nenecchiCV/ball-balancing-omni-rover/README.md

# ball-balancing-omni-rover
玉乗りオムニローバー開発用
