nenecchiCV/ball-balancing-omni-rover/specs/hardware_design/electronics/nucleo_shield_imu_hole_alignment.md

# Nucleoボード・シールド・IMUの穴位置合わせ設計

作成日: 2026-10-27

Fusion 360のCADモデル（`ball_balancing_omnirover3wd_assembly`）に対応する、制御ボード・ユニバーサルシールド・IMUの取付穴位置情報をまとめる。CADには簡略化した代表形状のみを持ち、はんだ付け・ドリル位置の決定には本書の座標を正として使う。

## 座標系の定義

- **機体座標系**: 原点は機体中心（ボール直上・車体中央）、+XはP0モータ方向、+Zは上向き。単位はmm。
- **Nucleo基板座標系**: ST公式機械図面（UM2505 Fig.6）の基板左上隅を原点（0, 0）、+Xは基板右方向、+Yは基板下方向（ST-LINK側がy=0、ターゲット端がy=82.5）。
- **IMU基板座標系**: Adafruit Eagleデータの基板左下隅を原点。センサー（LSM6DSOXチップ）は基板中心(12.7, 8.89)に一致する。

## Nucleoボードの機体への配置

採用ボードはNUCLEO-G474RE（Nucleo-64, MB1367系、基板外形70 × 82.5 mm）。機体座標への変換は次の通り。

- 基板原点(0,0) → 機体座標 **(-34.27, -41.53)**
- 基板+X方向は機体+Xに対し **約+1.49°** の回転
- 基板のジャンクション（ST-LINK切り離しライン、基板y=27.93）は機体y ≈ -13.6の帯に位置する

### 基板取付穴（Ø3.2 mm、M3スペーサ対応）

| 穴 | 基板座標 (x, y) | 機体座標 (x, y) | 実装 |
|---|---|---|---|
| M1 | (10.97, 28.06) | (-24.03, -13.19) | M3×25mmスペーサ実装 |
| M2 | (59.17, 29.31) | (24.17, -11.94) | M3×25mmスペーサ実装 |
| M3 | (43.89, 80.14) | (8.89, 38.89) | L2に穴のみ（スペーサなし、下記参照） |

M3位置はバッテリー包絡（後述）と干渉するため、第3スペーサは省略としL2の貫通穴のみ残す。基板はジャンクション側2点で支持する。3点支持が必要になった場合はバッテリーを取り外した状態で第3スペーサを追加できる。

## IMU（Adafruit LSM6DSOXブレイクアウト）の配置

センサー中心を機体座標 **(0, 0)** に合わせる。基板の9ピン列は-Y側（ST-LINK／ジャンクション方向）、5ピン列は+Y側に向ける向きを標準とする。

- IMU基板外形: 25.4 × 17.78 × 1.6 mm、中央が(0,0)
- ヘッダピン列は機体Y = **±6.35 mm** の2列に並ぶ（センサー中心から±6.35）

### 一致させるべき穴位置（機体座標）

ユニバーサルシールド上で、Adafruitのヘッダピンが通るべきグリッド穴の位置は次の通り（全て2.54 mmグリッド上）。

| 用途 | 穴位置（機体座標, mm） |
|---|---|
| 9ピン列（JP1、9穴） | y = -6.35、x = {-10.16, -7.62, -5.08, -2.54, 0, +2.54, +5.08, +7.62, +10.16} |
| 5ピン列（JP2、5穴） | y = +6.35、x = {-5.08, -2.54, 0, +2.54, +5.08} |
| IMU基板固定穴（任意、2穴） | (-10.16, +6.35)、(+10.16, +6.35) |

両ピン列とも基板中心（x=0）に対し対称であり、14ピン全てが y = ±6.35 の2列の直線上に収まる。2列間隔は12.70 mm = 2.54 mmグリッド5ピッチで、連続グリッドに整合する。

### 一致させるべき穴位置（基板座標）

はんだ付け・グリッド確認を基板上で直接行えるよう、同じ14穴＋固定穴を各基板の座標系でも示す。機体座標との関係は次の通り。

- IMU基板座標: 原点 = 基板左下隅（機体座標(-12.7, -8.89)）、軸は機体と平行
- シールド基板座標: 原点 = 代表外形の左下隅（機体座標(-34.5, -24.5)）、軸は機体と平行

#### IMU基板座標（Adafruit Eagleデータの正規値）

| 用途 | 穴位置（IMU基板座標, mm） |
|---|---|
| 9ピン列（JP1、9穴） | y = 2.54、x = {2.54, 5.08, 7.62, 10.16, 12.70, 15.24, 17.78, 20.32, 22.86} |
| 5ピン列（JP2、5穴） | y = 15.24、x = {7.62, 10.16, 12.70, 15.24, 17.78} |
| 基板固定穴（任意、2穴） | (2.54, 15.24)、(22.86, 15.24) |

センサー中心 = 基板中心 (12.70, 8.89)。両ピン列は基板中心からy方向 ±6.35 の位置にある。

#### シールド基板座標（CADの代表外形 69 × 53 mm 基準）

| 用途 | 穴位置（シールド基板座標, mm） |
|---|---|
| 9ピン列と一致させる列 | y = 18.15、x = {24.34, 26.88, 29.42, 31.96, 34.50, 37.04, 39.58, 42.12, 44.66} |
| 5ピン列と一致させる列 | y = 30.85、x = {29.42, 31.96, 34.50, 37.04, 39.58} |
| IMU固定穴と一致させる穴 | (24.34, 30.85)、(44.66, 30.85) |

シールド基板座標でのIMUセンサー中心位置は (34.50, 24.50)。2列間隔は12.70 mm（2.54 mmグリッド5ピッチ）で、シールドのユニバーサルグリッドがこれらの座標を含む位相にあればよい。

- 代表外形は実シールドと異なる可能性があるため、実シールド上では「外形隅からの絶対座標」ではなく「ユニバーサルグリッドに対する位相」で判断する。上表の座標を2.54で割った剰余（x: 約1.48、y: 約0.37）が、代表外形左下を原点とした場合のグリッド位相条件となる。
- 参考: Nucleo基板座標では、IMUセンサー中心は約 (35.34, 40.63)（基板のほぼ中央）に投影され、両ピン列は基板X軸に対し約 -1.5° 傾いた直線になる。

### スペーサ穴を基準としたIMU中心位置

実機ではんだ付け位置を決める際、Nucleoの取付（スペーサ）穴を基準に測るのが最も確実。IMUセンサー中心の目標位置と各取付穴からのオフセットは次の通り。

| 基準 | 座標系 | IMU中心位置 |
|---|---|---|
| Nucleo基板座標（左上隅原点） | 基板座標 | **(35.34, 40.63)** — 基板のほぼ中央 |
| 取付穴M1 (10.97, 28.06) から | 基板座標オフセット | **(+24.37, +12.57)** |
| 取付穴M2 (59.17, 29.31) から | 基板座標オフセット | **(-23.83, +11.32)** |
| 取付穴M3 (43.89, 80.14) から | 基板座標オフセット | **(-8.55, -39.51)** |

実装上の2スペーサ（M1, M2）を基準にすると:

- **M1–M2を結ぶ線のほぼ垂直二等分線上**にあり、その線から**約11.9 mm**だけM3側（基板奥側）へ離れた位置
- 穴中心からの直線距離（ノギス確認用）: M1から **27.4 mm**、M2から **26.4 mm**、M3から **40.4 mm**
- 機体座標ではM1(−24.03,−13.19)、M2(24.17,−11.94)から見てIMU中心(0,0)は中点の真上付近（中点(0.07,−12.57)から+y方向へ12.6 mm）

採用するUNO互換ユニバーサルシールドのプロト穴グリッド（2.54 mmピッチ）が、機体座標で **y = ±6.35** の2列および上表のx位置に穴を持つ必要がある。言い換えると、機体中心を通る仮想のy=0線から測って **グリッドが半ピッチ（1.27 mm）ずれた位相** にあれば全穴が一致する。

- シールドの機体への位置は、NucleoのArduinoコネクタ（CN5, CN6, CN8, CN9）への挿入で機械的に確定する。グリッド位相はシールド個別の設計に依存するため、採用シールド上で上表の14座標に実穴があることを確認してからはんだ付けする。
- グリッド位相が半ピッチずれないシールドでは、IMUのヘッダピンをグリッドに合わせるとセンサー中心が±1.27 mmずれる。厳密な中央一致を優先する場合は、2.54 mmピッチの小型変換基板（グリッドを1.27 mmオフセットする中継板）をシールドとIMUの間に挟む。

## 高さ方向の積層（機体座標 z, mm）

| 要素 | z範囲 | 備考 |
|---|---|---|
| フレームL2上面 | 178.0 | 電子機器の載置面 |
| 基板固定スペーサ M3×25 | 178.0–203.0 | M1, M2位置に2本（Nucleo用） |
| MDD3A用 M3×10 スペーサ | 178.0–188.0 / 199.0–209.0 | 右側ストリップに4本×2段（MDD3A 2層積み） |
| MDD3A-A基板（実寸代表 48.26×41.66×11） | 188.0–199.0 | 下層、中心(56,0)、取付穴はL2穴表 |
| MDD3A-B基板（実寸代表 48.26×41.66×11） | 209.0–220.0 | 上層、中心(56,0)、L3下面まで8 mm |
| Nucleo基板（1.6 mm厚） | 203.0–204.6 | |
| シールド基板 | 215.0–216.6 | スタックヘッダ高さ10.4 mm想定（実物のヘッダ高で調整） |
| IMU基板 | 219.1–220.7 | シールド上面から2.5 mmのスタンドオフ想定 |
| フレームL3下面 | 228.0 | IMU上面との隙間約7.3 mm |

IMUとL3の間隔は約7 mm確保される。スタックヘッダを実装する際は、シールド下の高さを合わせてIMUがL3下面に接触しないことを確認する。

## バッテリー配置

- バッテリー: Zeee 7.2 V 5000 mAh NiMH（TAMIYAプラグ付）、包絡 **135.5 × 45.5 × 22.5 mm**
- 配置: 機体座標で x = ±22.75、y = ±67.75、z = 178.0–200.5（L2上・Nucleo基板下、ほぼ機体中央）
- 上部クリアランス: バッテリー上面200.5 → 基板下面203.0で2.5 mm

### 既知の干渉と対処

- 中央配置のバッテリー（幅45.5 mm）と2本の基板スペーサ（M1, M2、中心間隔48.2 mm）の間に、**約1.8 mm深さの隅部干渉** が残る（実測: 157 / 145 mm³）。スペーサ間隔よりバッテリー幅が2.7 mmだけ狭いため、中央近傍では両スペーサを同時に回避する位置が幾何学的に存在しない。
- 実機では、NiMHスティックパックの角部シュリンク・丸み（実効幅は公称より小さい）とスペーサのわずかな面取りで吸収できる見込み。完全非接触が必要なら、バッテリーを1–2 mm片側へ寄せるか、スペーサに小さな面取りを入れる。
- 配線スロット（L2、幅10 mm、r=26–56、0°/120°/240°方向）はバッテリー縁より外側まで開放しており、モーターコネクタからの配線はスロット外側部を通る。

## フレームL2の穴（実装済み）

| 穴 | 位置（機体座標, mm） | 寸法 |
|---|---|---|
| 基板取付穴 ×3 | M1(-24.03,-13.19)、M2(24.17,-11.94)、M3(8.89,38.89) | Ø3.5 |
| MDD3A取付穴 ×4 | (37.71,±21.59)、(74.29,±21.59)（2層共用） | Ø4.0（挿入固定） |
| 層間スペーサ穴 ×6 | r=65、0°/60°/120°/180°/240°/300° | Ø3.5 |
| 配線スロット ×3 | r=26–56の放射状長穴、0°/120°/240°方向 | 幅10 |
| 中央部 | — | 充填済み（旧Ø20穴は廃止） |

## 備考・未確認事項

- CADのシールドは69 × 53 mmの代表形状であり、採用シールド実物とは外形が異なる。確定したシールドのユニバーサル領域が上表14座標を含むことを発注前に確認する。
- Nucleo基板CADの外形は機械図面寸法を反映しているが、USBコネクタ・部品高さは未モデル。基板上の実部品高は別途確認する。
- IMUの向き（±90°回転）は自由に選べる。向きを変える場合は上表の座標を同じ回転で変換し直す。
