nenecchiCV/ball-balancing-omni-rover/specs/hardware_design/controll/ball_balancing_omnirover3wd/ball_balancing_omnirover3wd-implementation-plan.md

# 玉乗り3WDオムニローバー実装計画

## 状態

| 項目 | 値 |
|---|---|
| ステータス | 正本モデルのモジュール化完了・階層制御へ移行済み |
| 最終更新日 | 2026-09-09 |
| アーキテクチャ | [アーキテクチャ仕様](ball_balancing_omnirover3wd-architecture.md) |
| 検証 | [検証計画](ball_balancing_omnirover3wd-test-plan.md) |

## 1. 進捗

| フェーズ | 状態 | 成果物 |
|---|---|---|
| 0. インターフェース固定 | 完了 | 座標系、信号、単位、符号、パラメーター |
| 1. MATLAB関数 | 実装・単体試験完了 | 幾何、摩擦、IMU、推定、制御、配分、単体試験 |
| 2. Multibodyプラント | 完了 | 球、床、3輪機構、4接触、異方性摩擦 |
| 3. 制御器統合 | バイアス診断・起動ガード統合完了 | 状態推定・モード制御、5 ms制御遅延、サーボ包絡線 |
| 4. 閉ループ検証 | 短時間公称完了 | 静止、複合速度・ヨー指令 |
| 5. ロバストネス | 未完了 | 摩擦、球質量、ソルバー感度 |
| 6. 実機向けヨーバイアス補正 | 基本実装・構造検証完了 | 14状態推定器、低運動認定、診断、起動ガード、単体試験、短時間MIL |

## 2. 依存製品

| 製品 | 用途 | 必須 |
|---|---|---|
| MATLAB | パラメーター、MATLAB関数、解析 | Yes |
| Simulink | 制御器・ログ | Yes |
| Simscape | 物理信号 | Yes |
| Simscape Multibody | 剛体・ジョイント・接触 | Yes |
| Simulink Test | Gherkin/MIL自動化 | No。利用可能時に使用 |

## 3. フェーズ依存

```mermaid
flowchart TD
  P0[Phase 0<br/>Interface freeze]
  P1A[Geometry and parameters]
  P1B[Estimator functions]
  P1C[Controller functions]
  P2A[Ball and ground]
  P2B[Rover and wheel modules]
  P2C[Wheel-ball contacts]
  P3[Closed-loop integration]
  P4[Nominal MIL]
  P5[Robustness MIL]
  P0 --> P1A
  P0 --> P1B
  P0 --> P1C
  P1A --> P2A
  P1A --> P2B
  P1A --> P2C
  P1B --> P3
  P1C --> P3
  P2A --> P3
  P2B --> P3
  P2C --> P3
  P3 --> P4 --> P5
```

## 4. ビルド手順

### Phase 0: インターフェース固定

| ID | 操作 | 完了条件 | 状態 |
|---|---|---|---|
| 0.1 | $W,B,K,F_i$座標系を固定 | 機構・制御文書で一致 | 完了 |
| 0.2 | 3輪番号と正方向を固定 | $\beta=[0,120,240]$ deg | 完了 |
| 0.3 | 13要素推定出力を固定（バスは14幅・末尾未使用） | システム仕様§5と一致 | 完了 |
| 0.4 | 5 ms離散インターフェースを固定 | 推定器・制御器で一致 | 完了 |

### Phase 1: MATLAB関数

| ID | 関数 | 確認 | 状態 |
|---|---|---|---|
| 1.1 | `ballbotParameters` | 全パラメーター有限、質量整合 | 完了 |
| 1.2 | `ballbotWheelGeometry` | 直交性、$\operatorname{rank}(A_\tau)=3$ | 完了 |
| 1.3 | `ballbotTorqueAllocator` | 往復誤差、飽和 | 完了・現行構成では輪速変換$W_\omega$（`p.controller.lqi.wheelSpeedFromPlanarVelocity`）へ移行 |
| 1.4 | `ballbotCustomFriction` | 摩擦がすべりと逆向き | 完了・3接触へ統合済み |
| 1.5 | `ballbotWheelRateFromDisplacement` | 車輪回転変位の後退差分 | 完了 |
| 1.6 | `ballbotEstimatorStep` | 14状態、補正角速度、静止不変、有限出力 | 完了・実行確認済み |
| 1.7 | `ballbotControlStep` | モード・符号・飽和 | 完了・現行構成では`ballbotLqiControllerUpdate`→`ballbotFullPlantHierarchyUpdate`へ移行 |
| 1.8 | `ballbotServoTorqueEnvelope` | 最高輪速で加速トルク0 | 完了・現行構成では`ballbotSpeedPiMotorStep`→`ballbotMdd3aVoltageController`の輪速PI＋DCモータへ移行 |
| 1.9 | `ballbotEstimatorStepTest` | バイアス収束、学習抑止、上限、再開、回帰 | 16件合格（現行制御器向けに更新済み） |
| 1.10 | `ballbotYawBiasStartupGuard` | ヨー抑止、解除、運動中ラッチ保持 | 完了・実行確認済み |
| 1.11 | `ballbotFullPlantHierarchyUpdate` | 速度外側ループ＋傾斜安定化＋輪速変換 | 完了・正本モデルで使用中 |
| 1.12 | `ballbotSpeedPiMotorStep` | 輪速PI、MDD3A電圧制限、DCモータトルク | 完了・正本モデルで使用中 |
| 1.13 | `ballbotDesignLqi` | 10状態縮約プラントのLQIゲイン設計 | 完了・パラメーター初期化で再計算 |

### Phase 2: Multibodyプラント

| ID | 操作 | 検証ツール |
|---|---|---|
| 2.1 | 既存`omnirover3wd_multibody.slx`を新規フォルダーへ複製 | ファイル存在 |
| 2.2 | ルートをCommandSource/Controller/MultibodyPlant/Loggingへ分割 | `model_overview` |
| 2.3 | Infinite Planeと直径100 mm Spherical Solidを配置 | `model_read` |
| 2.4 | 球–床Spatial Contact Forceを接続 | `model_read`, `model_check` |
| 2.5 | 3輪中心を球面$\lambda=33$ degへ再配置 | Transform確認 |
| 2.6 | 3組のRevolute Jointを$+a_i$へ整列 | Joint軸確認 |
| 2.7 | 3組の輪–球Spatial Contact Forceを接続 | 物理ポート確認 |
| 2.8 | Provided by Input摩擦と`ballbotCustomFriction`を接続 | すべり/力ログ |
| 2.9 | IMU、車輪回転変位、truthセンサーを接続 | 信号次元確認 |

### Phase 3: 制御器統合

| ID | 操作 | 完了条件 |
|---|---|---|
| 3.1 | StateEstimatorをMATLAB Function+Unit Delayで構成 | 14状態、13要素`estimate` |
| 3.2 | ModeAndControlをMATLAB Function+Unit Delayで構成 | 2積分状態、3輪出力 |
| 3.3 | 輪トルクをRevolute Jointへ接続 | 正方向一致 |
| 3.4 | 速度・ヨー指令をCommandSourceへ接続 | 範囲制限一致 |
| 3.5 | truth信号を制御器から隔離 | 制御入力線なし |
| 3.6 | ヨーバイアス診断をLoggingへ接続 | $\hat b_{g,z}$、$\gamma$、$t_{qual}$を個別ログ |
| 3.7 | 起動時ヨー制御ガードを追加 | 準備完了までヨートルクだけを抑止し、状態をUnit Delayで保持 |

Phase 3.1、3.6、3.7はSimulink Agentic Toolkitの`model_read`、`model_edit`、`model_check`を使用して実施し、`Controller`と`Logging`の構造チェックが正常であることを確認した。

### Phase 4: 閉ループ検証

| ID | シナリオ | ゲート |
|---|---|---|
| 4.1 | 静止直立 | 4接触維持、姿勢±1 deg |
| 4.2 | $v_x=0.10$ m/s | 速度誤差±0.01 m/s |
| 4.3 | $v_y=0.08$ m/s | 速度誤差±0.01 m/s |
| 4.4 | $r=0.5$ rad/s | ヨー速度誤差±0.05 rad/s |
| 4.5 | 初期傾斜10 deg | 2 s以内に±2 deg |
| 4.6 | 静止、ヨーバイアス0.02 rad/s | 15 s以内に推定誤差0.002 rad/s未満 |
| 4.7 | 学習後の静止10 s | ヨードリフト0.5 deg未満 |
| 4.8 | 走行・振動・すべり・接触低下 | バイアス変化0.002 rad/s未満 |

## 5. パラメーター表

| パラメーター | 値 | 単位 | 出典 | 実装 |
|---|---:|---:|---|---|
| $R_b$ | 0.050 | m | 要求 | `p.ball.radius` |
| $m_b$ | 0.285 | kg | 基準質量・実測更新 | `p.ball.mass` |
| $R_w$ | 0.024 | m | 14108仕様書 | `p.wheel.radius` |
| $m_w$ | 0.039 | kg | 14108仕様書/既存モデル | `p.wheel.mass` |
| $m_R$ | 1.179 | kg | Fusion実測反映後（MotorMount_v12等） | `p.rover.mass` |
| $m_p$ | 0.500 | kg | 正式上部ロッド仕様 | `p.fullplant.payload.mass` |
| $L_p$ | 0.300 | m | 正式上部ロッド仕様 | `p.fullplant.payload.length` |
| $h_{COM}$ | 0.1074 | m | ローバー合成重心（Fusion実測反映後） | `p.rover.centerAboveBall` |
| $\lambda$ | 33 | deg | 機構設計（案B内向き格納の成立限界） | `p.wheel.contactLatitude` |
| $\tau_{motor,stall}$ | 0.981 | N·m | FIT0521公式仕様 | `p.motor.stallTorque` |
| $\tau_{driver,continuous}$ | 0.919 | N·m | MDD3A 3 A連続定格とFIT0521トルク定数 | `p.driver.continuousTorqueLimit` |
| $\tau_{contact,max}$ | 0.1262 | N·m | ローバー質量・λ33の公称法線荷重・摩擦 | `p.wheel.contactTorqueLimit` |
| $T_s$ | 0.005 | s | 制御設計 | estimator/controller |
| $K_{pv}$ | [2.3,2.3] | s$^{-1}$ | 正本構成の速度外側ループ | `p.controller.fullplant.velocityKp` |
| $K_{iv}$ | [0,0] | s$^{-2}$ | 正本構成の速度外側ループ | `p.controller.fullplant.velocityKi` |
| $K_{p,\alpha}$ | [16,16] | - | 傾斜安定化比例 | `p.controller.fullplant.tiltKp` |
| $K_{d,\alpha}$ | [1.6,1.6] | - | 傾斜安定化微分 | `p.controller.fullplant.tiltKd` |
| $\tau_{motor,lim}$ | 0.010 | N·m | 正本構成の輪トルク上限 | `p.controller.fullplant.motorTorqueLimit` |
| $c_{scale}$ | 0.60 | - | 指令スケール | `p.controller.fullplant.commandScale` |
| $\omega_{w,th}$ | 0.10 | rad/s | 低運動の暫定輪周速度ゲート | `p.estimator.biasWheelRateThreshold` |
| $a_{th}$ | $0.03g$ | m/s² | 静止振動の暫定許容値 | `p.estimator.biasAccelNormThreshold` |
| $\omega_{rp,th}$ | 0.02 | rad/s | ロール・ピッチ低運動の暫定値 | `p.estimator.biasRollPitchRateThreshold` |
| $\omega_{z,th}$ | 0.05 | rad/s | 0.02 rad/sバイアスを含む暫定値 | `p.estimator.biasYawRateThreshold` |
| $t_{min}$ | 0.50 | s | 一時停止を除外する滞留時間 | `p.estimator.biasQualificationTime` |
| $\tau_b$ | 1.0 | s | 低運動維持時間内の収束と15 s基準を両立する暫定値 | `p.estimator.biasTimeConstant` |
| $b_{max}$ | 0.10 | rad/s | 未確定IMU向け保守上限 | `p.estimator.biasMaximum` |
| $\Delta b_{max}$ | $1.0\times10^{-4}$ | rad/s/sample | 外れ値急変防止 | `p.estimator.biasMaximumUpdatePerSample` |
| $\omega_{ready}$ | 0.002 | rad/s | 収束合格誤差と一致する起動ガード解除値 | `p.controller.yawBiasReadyRateThreshold` |

## 6. 完了定義

- [x] 座標系・符号・単位を文書化
- [x] MATLAB関数をモデル外で静止入力確認
- [x] ルート階層がアーキテクチャと一致
- [x] `model_check`にerrorなし
- [x] 全モデルが更新・コンパイル可能
- [x] 静止シミュレーション完走
- [x] 短時間の複合速度・ヨー指令シナリオ完走
- [x] 4接触truthログを保存
- [ ] 規定速度での定常追従ゲート合格
- [ ] 接触分離シナリオと法線力・すべりログを保存
- [ ] ソルバー・摩擦・球質量の感度試験完了
- [x] 14状態推定器とヨー軸バイアス更新則をMATLAB関数へ実装
- [x] 9項目以上のクラスベース単体試験を作成
- [x] MATLAB接続下でヨーバイアス単体試験を実行
- [x] StateEstimatorの状態幅と診断ログをSimulinkモデルへ統合
- [ ] バイアス・ノイズ・振動・すべり・接触低下MILを実行

### 6.1 実行済みMIL

| シナリオ | 主結果 | 判定 |
|---|---|---|
| 静止、0.1 s | 4接触、最大傾斜0.00001 deg未満、有限値 | 合格 |
| $[v_x,v_y,r]=[0.03,0.02,0.20]$、0.5 s | 4接触、最大傾斜0.787 deg、平均ヨー速度0.183 rad/s、最大輪速1.403 rad/s | 短時間ゲート合格 |
| モデル更新 | `ANISOTROPIC_COMPILE_OK` | 合格 |
| MATLAB単体試験 | 16件中16件合格 | 合格 |
| モデル構造 | `Controller`、`Logging`とも`model_check`正常、ルートにerrorなし | 合格 |
| 静止、ヨーバイアス0.02 rad/s、4 s | 4 s時点誤差0.001916 rad/s、3～4 sヨードリフト0.005293 deg | 短時間ゲート合格 |
| $[v_x,v_y,r]=[0.03,0.02,0.20]$、0.5 s再試験 | 平均ヨー速度0.197879 rad/s、最大傾斜0.005681 deg、最終mode=1 | 合格 |
| モジュール化回帰 | サブシステム化後モデルと再構成前ベースラインで全ログ信号が一致（最大相対差は摩擦力で約$4\times10^{-3}$） | 合格 |
| モデル更新 | モジュール化後モデルで`update`成功 | 合格 |

25 sの全機体バイアスMILでは15 s時点の推定誤差0.001916 rad/sを確認したが、モデルは4.760 sでFALLENへ遷移したため、その後の10 sヨードリフトは判定対象外とした。バイアスなし公称指令でも2.195 sでFALLENへ遷移するため、長時間姿勢・速度回帰は既存プラント／制御調整の未解決事項として分離する。ノイズ、振動、すべり、接触低下を含む長時間MILは未実施である。

## 7. リスク

| リスク | 検出 | 対策 |
|---|---|---|
| 接触モデルが硬くシミュレーション停止 | ソルバー診断 | 遷移幅、剛性、最大ステップを段階調整 |
| 車輪ローカル軸と摩擦方向が不一致 | 単輪正トルク試験 | $F_i$座標の軸を修正 |
| 反力符号が逆 | 1 deg姿勢偏差試験 | joint actuation signを1か所で反転 |
| 公称摩擦でトルク不足 | 飽和率 | 接触緯度・重心・指令範囲を再設計 |
| IMU速度積分ドリフト | truth誤差 | 実機版で外部速度補正を追加 |
| 実機IMU仕様未確定 | 静止ログ、温度試験、Allan分散 | 低運動閾値、時定数、上限を実測調整 |
| 走行中にエンコーダーからヨーを誤推定 | バイアスの運動中変化 | エンコーダーは低運動認定だけに使い、走行中は学習停止 |
