nenecchiCV/ball-balancing-omni-rover/specs/hardware_design/mechanism/ball_balancing_omnirover3wd/cad/fit0521_motor_mount_report.md

# FIT0521モーター固定パーツ設計レポート(v23 長方形プレート締結角筒式・印刷伏せ姿勢)

## 概要

DFRobot FIT0521(φ24.4 × 52 mm、4 mm Dシャフト)を Nexus Robot 14108 オムニホイール(φ48 × 25.1 mm)に同軸直結する配置と、そのモーター固定パーツを設計した。ホイール接触緯度は **λ = 33°**(車軸水平角 57°)、ユーザー指示により **案B(内向き格納)** を採用する。ホイール方位 β = {0°, 120°, 240°} は変更しない。

v9 では **実機で成立するギアボックス締結**を実現するため v12 のモーター締結部を再構成した。v8 の中央 Ø26 挿通ボアは PCD17 タップ半径(8.5 mm)がボア内側に入るためボルト座面となる材料が存在しなかった。v9 ではモーター面を板裏面(現行 s′=20.0 mm 面一)に着座させ、中央ボアを充填し、PCD17 の Ø3.5 貫通穴×4とホイール側ワッシャーポケット Ø7.2×2 mm×4を実体に切削した。

λ = 33° の選定根拠: 案B(モーターを車軸の内向き・上向きに延ばす同軸直結)は3モーター尾部が中心軸へ収束するため λ ≲ 33° でのみ幾何学的に成立する(計画書 §3 の定量化)。λ = 33° は境界値である。

v8→v9 での変更点(実締結構造の実現):

- **モーター締結部を実体ウェブ化**: 中央 Ø26 ボアを廃止し、ギアボックス前面タップ(PCD17、Ø2.5×4)に同軸の Ø3.5 貫通穴×4が板実体を通る構造へ変更
- **ワッシャーポケット**: ホイール側に Ø7.2×2 mm 窪み×4を新設(M3 ボルト頭+ワッシャーを収容、頭頂 s′≈14.5 mm)
- **ノーズ逃げ穴 Ø8**: ギアボックス前面中央の突起逃げ
- **モーター位置**: フェース s′=16.0 → 20.0 mm(板裏面に面一着座)
- **アダプタ再作成**: WheelAdapter_v4 を λ33 同軸の Ø11.9/Ø4.2 貫通チューブとして作り直し(旧姿勢の残存を解消)
- 体積 12.33 → 21.71 cm³(タブ追加・旧穴充填後)

v9→v10での変更点(フレーム締結とフィレット撤廃):

- **フレーム締結をタブ式に変更**: パッド上面を z=141–147 mm のキャップブロックで埋めて幅方向(±y)に張り出すタブとし(y = ±24 mm)、タブに Ø4.5 垂直穴×2((62,±19.5) mm)を切削。Frame_L1 側にも同一XY位置に Ø4.5 垂直穴を開け(3ステーション計6ヶ所)、フレーム板とタブをはさんで M4 ボルト+ナットで締結する方式へ変更
- **旧締結穴の撤廃**: パッド部の Ø4.6 垂直すきま穴×4は新タブ構造に置き換え(現行ボディに Ø4.6 垂直穴は存在しない)
- **フィレット撤廃・面取り化**: 凹角フィレット(R4×3・R2.5×1)を削除し、三角プリズムの結合/切削でフラットな面取り角に置き換え。プロファイルの段差ジグザグも直線化
- **モーター180°回転**: コネクタ干渉回避のため全3モーターを車軸まわりに180°回転
- 天面を z=147 mm で平坦化(Frame_L1 下面と面一密着、干渉0)

v10→v11での変更点(モーター姿勢の恒常化とシャフト係合):

- **モーターをステーション別コンポーネント化**: オカレンス変換(`transform2`)が保存時に旧姿勢へ巻き戻る問題が残存したため、最終姿勢をコンポーネント幾へ直接焼き込んだ FIT0521_P0/P1/P2(恒等変換)へ再構築。保存・再オープンで姿勢維持を検証
- **モーター面を板裏面へ面一着座**: s′=20.6(0.6 mm 浮き)→ s′=20.0 mm(タップ開口位置で実測確認)
- **アダプタ延長でシャフト係合を確保**: WheelAdapter_v4 のモーター側端を s′=+1.5 → +11.5 mm へ延長し、シャフト先端 s′=7.8 との 3.7 mm 係合を実現(ボア Ø4.2、外径 Ø11.9 は不変)
- 全ペア干渉 0 mm³、PCD17 穴整合・3ステーション対称性を再検証済み

v11→v13での変更点(スリーブ式マウントへの全面再設計、v15 で廃止):

- **モーターを筒状部に挿入**: 車軸同軸の回転体カップ(外径 Ø31・ボア Ø25.5、肉厚 2.75 mm)を生成。モーターは内側端(ギヤボックス側 s′≈50 の開口)から挿入され、ボアがギヤボックス前方 s′≈18.5–50 mm の周囲を包む。ボア内端 s′=18.3 がモーター前面(s′=18.5–18.7)の座面となる
- **モーターフェイスと筒壁のねじ止め**: カップ外端(ホイール側 s′=14 のキャップ壁 4.6 mm)に PCD17 同軸 Ø3.5 貫通穴×4 + Ø7.2×3.5 ワッシャーポケット×4 + 中央 Ø8 ノーズ逃げ穴を切削。キャップ内面にはギヤボックス前ボス(Ø17.6×s′≈18.5–21.5 突入)の逃げとして Ø18.4 カウンターボア(s′=15–18.4)を設置
- **面数削減**: キャップ+ウェブ+タブを単一ソリッドへ一体化(旧横穴はプラグ充填、不要な凹凸なし、面取りのみ)。現行ボディ 1 個・面数 39(解析面のみ)
- 体積 21.71 → **18.63 cm³**、CG z=128.1 mm(球心上 78.1 mm)・半径方向 52.7 mm、CG基準主慣性(鋼)≈0.500/0.440/0.185 kg·cm²

v13→v14での変更点(板+左右柱構造への再設計、v15 で3部品化。モーター/ホイール位置は不変):

- **ギアボックス接続板**: 車軸垂直の傾斜板(ê方向 ±17 mm × 幅方向 ±20 mm × 板厚 s′=14–18.6)。PCD17 同軸 Ø3.5 貫通穴×4 + ホイール側 Ø7.2 ワッシャーポケット×4 + 中央 Ø8 ノーズ逃げ穴 + 内面 Ø18.4 カウンターボア(モーター前ボス座面)はv13キャップと同一仕様
- **左右分割柱**: 板裏面(s′=18.6、ê≈+8 基点)から Frame_L1 下面タブへ繋ぐ柱を y=+15..24 / −24..−15 mm の左右2本に分割(モーター胴体 Ø25 が柱間 30 mm を軸方向に挿入可能)。柱断面は板→タブ方向(d̂=(0.10,0,0.99))に沿った 16 mm 幅の角柱
- **タブブロック**: 柱上端が接する L1 下面タブ(x=51–72.5・y=±24・z=141–147)を保持、Ø4.5 穴×2((62,±19.5) mm)の M4 ボルト+ナット挟み締結は不変
- 単一ソリッド **19.49 cm³**、CG z=126.0 mm(球心上 76.0 mm)・半径方向 58.9 mm、CG基準主慣性(鋼)≈0.845/0.488/0.468 kg·cm²。モーター胴体が開放されるため v13 のスリーブ保持(胴体拘束)は失われ、保持は面ボルトのみとなる

v14→v15での変更点(一体マウントを3部品へ分割、v16で一体成型へ回帰・廃止。モーター/ホイール位置は不変):

- **3部品構成**: `MountPlate_v15`(モーターフェイス締結板)+ `MountPillar_v15_R`(右柱)+ `MountPillar_v15_L`(左柱)。Fusion アセンブリでは3コンポーネント×3ステーションの9オカレンス(ステーション0は恒等変換、他は Rz(±120°))
- **接続は全てタブ同士のボルト+ナット挟み**:
  - 板↔柱: 板の両側縁タブ(y=±23.5)と柱下端の足タブが面接し、ê方向(車軸面内・水平角57°の斜交)Ø4.5 貫通穴を通す M4 ボルト+ナットで挟み締結(板側穴 (62.7,±23.5,112.2)、柱側穴 (61.5,±23.5,114.1)、同軸ずれ 0.007 mm)
  - 柱↔フレーム: 柱上端タブが Frame_L1 下面に接し、垂直 Ø4.5 穴((62,±19.5) mm、z=141–147)を通す M4 ボルト+ナットで挟み締結 — v14 と同位置
- **体積(鋼材質計測)**: 板 5.119 cm³ + 柱 5.530 cm³×2 = **16.18 cm³**(v14 より −17%)。結合体 CG: z=122.2 mm(球心上 31.9 mm)・半径方向 58.3 mm、CG基準慣性テンソル(鋼) Ixx/Iyy/Izz = 0.706/0.368/0.475 kg·cm²(Ixz=−0.080)
- **注意**: 板↔柱・柱↔フレームの各継手は1ヶ所あたりボルト1本のみ — ボルト軸まわりの回転拘束はタブ面接触摩擦に依存する。実機でガタが出たら継手を2穴化するか段付き嵌合を検討

v15→v16での変更点(一体成型・バケット形状への回帰、v17 で一体化構造を修正・廃止。モーター/ホイール位置は不変):

- **単一ソリッド `MotorMount_v16`**: 分割案v15を廃止し、ショベルカーのバケットに相当する形状へ一体化 — 車軸垂直のフェイス板(s′=14–18.45) + 左右のチーク壁(y=±15–19、s′=18.6–54、モーター胴体Ø25.4を挟む間隔30mm) + 底クレードル(n′=14–16.5、胴体下面を支える) + チーク上端から立ち上がるリブでL1タブ(z=141–147)へ接続
- **締結**: ギアボックス前面 M3×4(板貫通、従来通り) + L1タブ Ø4.5垂直穴×2((62,±19.5) mm)→ Frame_L1 と M4 ボルト+ナット挟み(従来通り)。分割継手は廃止
- **モーター拘束の向上**: v14/v15 は面ボルトのみだったが、v16 はチーク壁(側面)+底クレードルで胴体を包み込み、径方向・重力方向の拘束を追加。挿入は尾部側(s′>54)の開口から車軸方向へスライド
- **体積**: 22.02 cm³(v14 +13%、v15合計 +36%)、CG z=124.4 mm(球心上 74.4 mm)・半径方向 48.4 mm、CG基準慣性テンソル(鋼) Ixx/Iyy/Izz = 0.812/0.754/0.686 kg·cm²(Ixz=−0.159)
- **板裏面**: s′=18.45 にトリム(モーター前面 s′≈18.48–18.6 との微小食い込みを解消)

v16→v17での変更点(接続一体化・接続位置と穴の分離、v18 で筒形状を変更・廃止。モーター/ホイール位置は不変):

- **バケット部の一体化**: v16 はフェイス板・チーク壁・底クレードル・リブを別々の直方体で差し込んで結合しており、接合部に継ぎ目が残っていた。v17 では **単一ブロック(s′=14–56・y±19・n′=−20..16)から内部空洞(y±15・s′>18.45・n′<14)を切削する構成**に変更し、フェイス板・左右チーク壁・底クレードルの間に継ぎ目を持たない一体シェルとした
- **タブ接続と締結穴の位置分離**: v16 ではチーク壁(y=±15–19)の上端がタブの M4 穴列(y=±19.5)の直下で接続され、穴と壁の接続箇所がほぼ同じ位置だった。v17 ではタブとの接続を **中央スパインブリッジ(y=±9・s′=40–58)のみ**に限定し、チーク壁の上端は s′>42 で n′≤12.5 まで下げてタブ下面から退避。タブ穴(x=62, y=±19.5)とブリッジ接続域(x≈51–56, y=±9)は x 方向 6 mm・y 方向 10 mm 以上離れ、明確に分離
- **ブリッジ上面**: z=146.5 の水平面でトリムし、Frame_L1 下面(z=147)に 0.5 mm の隙間(タブ z=141–147 が従来通り L1 下面に面一密着)
- **工学的形状への最適化**: ユーザ指示により「バケット」は比喩とし、胴体を包む必要のない壁上部を削除 — チーク壁の開放側(−n′)端を n′=−5(胴体中心高さ)まで下げた鞍状クレードルに変更。モーター保持は M3 ボルトに任せ、壁は横振動拘束の必要最小限とした(体積 22.75→18.24 cm³)
- **体積・質量**: 18.24 cm³、CG (53.33, 0, 123.73) mm(球心上 73.7 mm・半径方向 53.3 mm)、CG基準慣性テンソル(鋼) Ixx/Iyy/Izz = 0.663/0.539/0.407 kg·cm²(Ixz=−0.090)

v17→v18での変更点(ユーザ提示スケッチに基づく角筒構成、面数最小化・体積増は許容。v19 で箱外形をプレート寸法へ整合・拡大。モーター/ホイール位置は不変):

- **四角筒構造**: v17 の低壁クレードルを廃止し、モーター胴体を **30×30 mm 角筒(y±15・n′±15 内寸、壁厚4 mm、s′=18.45–58)** で四方向に包む構成へ変更。筒の車軸側端はフェイス板(s′=14–18.45)で閉塞 — 筒+板は単一ソリッド
- **一面の壁をフレーム方向へ延長**: +n′側(フレーム側)の壁(内面 n′=17・外面 n′=21、モーター尾部コネクタ n′≲15.5 との隙間 ≧1.5 mm)をそのまま s′=64 まで延長し、L1 下面(z=147)へ到達させる — 「四角筒の一面の壁がフレーム方向に延長」の実装
- **水平フランジタブ**: 延長壁の上端から水平板(z=141–147、x=34–72.5・y=±24)を張り出し、上面 z=147 を Frame_L1 下面へ面一密着、Ø4.5 垂直穴×2((62,±19.5) mm)で M4 ボルト+ナット挟み締結(従来通り)
- **コネクタ逃がしスロット**: フランジ内端に U字スロット(x=33–53・y±13.5)を切り、モーター尾部コネクタ(z≈141–146 領域へ進入)を回避
- **体積・質量**: 33.61 cm³(v17 +84%、面数優先・体積増許容の指示による)、44面、CG (47.23, 0, 123.38) mm(球心上 73.4 mm・半径方向 47.2 mm)、CG基準慣性テンソル(鋼) Ixx/Iyy/Izz = 1.168/1.210/1.098 kg·cm²(Ixz=−0.164)

v18→v19での変更点(箱外形を締結プレート寸法へ整合・壁厚化、剛性に寄与しない領域を垂直面でカット。v20 で締結部を変更。モーター/ホイール位置は不変):

- **箱外形=プレート寸法**: v18 の角筒外形(y±19・n′−19..21、38×40 mm)をフランジプレート(x=34–72.5・y±24)と同じ平面外形へ拡大 — 外寸 y±24・n′±24(48×48 mm角)。側壁は9 mm、床壁は9 mm、フレーム側壁は17..24(7 mm)に厚化。筒の水平投影はフランジの48 mm幅と一致
- **垂直カット(剛性に寄与しない領域)**: フランジ内端(x=34)より内側の箱部分を垂直面で除去 — +n′壁は全高x≥34で残存し筒→壁→フランジの荷重経路を維持。フランジ外端(x=72.5)以降の角部も除去し、平面視で箱がプレートに正確に一致
- **断面構成(変更なし)**: 内空 y±15・n′−15..+17(尾部コネクタ n′≲15.5 回避)、フェイス板 s′=14–18.45 の穴仕様(Ø8+PCD17 Ø3.5×4+Ø7.2ポケット+Ø18.4座面)、フランジ z=141–147・Ø4.5×2((62,±19.5))・U字スロット(x=33–53・y±13.5)
- **体積・質量**: 43.94 cm³(v18 +31%)、39面、CG (52.44, 0, 122.44) mm(球心上 72.4 mm・半径方向 52.4 mm)、CG基準慣性テンソル(鋼) Ixx/Iyy/Izz = 1.794/1.241/1.371 kg·cm²(Ixz=−0.189)

v19→v20での変更点(締結プレートを幅方向へ延長し穴を延長部へ移設。v21 でプレート外形を一様化・フェイス部下端角を削除。モーター/ホイール位置・箱構造は不変):

- **締結タブの延長**: フランジプレートの両側縁を y=±24 → **±34** へ延長(x=50–72.5 の翼タブ、z=141–147 の同一肉厚) — フレーム板(z=147–150)下面の広い範囲と重なり、ボルト+ナット挟みの強度余裕を確保
- **締結穴の移設**: 旧 Ø4.5 垂直穴×2((62,±19.5) mm)をマウント側・Frame_L1 側双方で充填(プレート下面 z=147 より下へ突出しない z=140–147 の充填)し、延長タブ上の **(62,±29) mm** に新 Ø4.5 垂直穴×2を開通 — 3ステーション全て(120°回転相当の位置)で同様
- **Frame_L1 の穴移設**: フレーム側も旧6穴(62,±19.5)×3を充填して新6穴(62,±29)×3を開通 — 単一ボディ、体積 43.83 cm³(ほぼ不変)
- **体積・質量**: 46.68 cm³(v19 +6%)、47面、CG (52.96, 0, 123.70) mm(球心上 73.7 mm・半径方向 53.0 mm)、CG基準慣性テンソル(鋼) Ixx/Iyy/Izz = 2.062/1.360/1.570 kg·cm²(Ixz=−0.23)

v20→v21での変更点(締結プレートの段差解消とフェイス部の不要角削除。v22 で印刷姿勢向けに楔充填。モーター/ホイール位置・筒構造・締結穴位置は不変):

- **締結プレートの一様長方形化**: v20 ではフランジが主部(y=±24)と両側翼タブ(x=50–72.5・y=±24–34)の段差形状だった。翼部を x=34–50 へも延長し、プレート全体を **x=34–72.5・y=±34・z=141–147 の一様な長方形**とした — 側縁の段差を解消し、Frame_L1 下面との接触面積を拡大(上面 z=147 面一密着は不変)
- **フェイス部下端角の削除**: 角筒のホイール側下端角(フェイス板外面と筒底面が交わる角、世界座標 (34.3,±24,89.0) mm 付近)がホイールへ張り出していたため、面取りで削除 — 前面側へ約11 mm・底面側へ約9 mm の斜面カット(幅方向全域)。フェイス板の穴仕様(Ø8/PCD17 Ø3.5/Ø7.2 ポケット/Ø18.4 座面)・筒内空・空洞床には影響なし(床面・側壁内面は残存)
- **体積・質量**: 46.91 cm³(v20 +0.5%)、41面、CG (53.06, 0, 125.59) mm(球心上 75.6 mm・半径方向 53.1 mm)、CG基準慣性テンソル(鋼) Ixx/Iyy/Izz = 2.092/1.276/1.660 kg·cm²(Ixz=−0.13)

v21→v22での変更点(締結プレート面をベッド伏せ印刷面とするための楔充填。モーター/ホイール位置・筒構造・締結穴位置は不変):

- **ホイール側下端角の復元**: v21 で面取りした下端角を元の方角へ戻した — 三角プリズム (34,88.78)–(34,96.02)–(43.54,94.97)・幅 y±24 を結合し、−n′外面と x=34 切断面が直角に交わる元の角を復元
- **フレーム側斜め隙間の充填**: +n′壁の斜め外面(57°)とプレート下面 z=141 の間にあった三角隙間(x=57.75–72.5・壁外面 z=118.29–141)を三角プリズム (57.75,141)–(72.5,141)–(72.5,118.29)・幅 y±24 で充填 — 筒のフレーム側端面が x=72.5 で壁底からプレート下面まで連続し、プレート面を下に伏せた際に筒端までベッドへ届く形状となった
- **印刷姿勢**: 締結プレート上面(z=147、フレーム接触面)をベッド面とする伏せ姿勢を想定 — 下端角と楔充填により、伏せ時に筒側が面一で支持されサポートなしで自立可能な輪郭に近付く
- **体積・質量**: 56.60 cm³(v21 +21%)、44面、CG (54.66, 0, 125.76) mm(球心上 75.8 mm・半径方向 54.7 mm)、CG基準慣性テンソル(鋼) Ixx/Iyy/Izz = 2.431/1.632/1.969 kg·cm²(Ixz=−0.26)。Frame_L1 は残存充填プラグを再統合して単一ボディ(43.83 cm³・不変)へ復帰

v22→v23(現行)での変更点(モーター端部下端角の面取り。モーター/ホイール位置・筒構造・締結穴位置は不変):

- **モーター端部下端角の面取り(ボール・ホイール接線平行)**: v22 で方形に復元した角筒のモーター端部下端角(世界座標 (34,±24,88.78) mm — x=34 端面と −n′斜め外面が交わる角)を、写真指示に基づき面取りカット — 切断面は**ボール・ホイール接線(接点における接線方向 (−0.545,0,0.839))に平行な平面**(法線 (0.839,0,0.545) = 球心→ホイール中心方向 = 車軸方向)。フェイス板と平行な面で、端面側へ約14.7 mm・斜め底面側へ約8 mm の斜面カット(幅方向全域 y±24)。フェイス板の穴仕様・筒内空・床面・楔充填部には影響なし(円筒面15個すべて保持)
- **体積・質量**: 53.17 cm³(v22 −6.1%)、**44面**、CG (55.79, 0, 127.49) mm(球心上 77.5 mm・半径方向 55.8 mm)、CG基準慣性テンソル(鋼) Ixx/Iyy/Izz = 2.127/1.298/1.817 kg·cm²(Ixz=−0.12)
- **面取り面の深化**: 接線垂直方向(中心線法線 (0.839,0,0.545) 方向)に +1.358 mm 追加して、面取り平面をフェイス板外面と同一面(const=86.26 mm)に一致させた → 面取り面とフェイス板外面フラグメントが同一平面上の単一面に統合され、併せてフレーム側端の重複面ペアと分割されていた端面が修復されて 45→42面に減少(実形状・体積は変更後も一致、BRep修復による面の統合)
- **締結穴の増設**: 締結プレートの Ø4.5 穴を y=±29 行に内側 x=44.5 へ1か所ずつ追加(内縁から既存外側穴と同じ 10.5 mm マージン)→ 各ステーション4穴 (44.5,±29)+(62,±29)。Frame_L1 にも3ステーション回転位置で対応穴を追加(計12穴)。マウント44面 = 面統合後42面 + 新円筒面2面

v23 締結規格改訂(現行): スペーサー穴パターン +30° 回転、M4→M3+Ø6ワッシャ移行(フェイス板は M2.5)。モーター/ホイール位置・筒構造・締結穴位置は不変:

- **スペーサー穴の回転**: フレーム間スペーサー穴を全層で +30° 回転 — パターン {±30,±90,±150} → {0,±60,±120,180}。Frame_L2/L3 は旧穴を充填して回転位置へ Ø3.5 で開け直し(6穴/層)、Frame_L1 は検出30穴を全て充填→両面フラット化→新パターン+締結穴+他穴を Ø3.5 で開け直し(30穴)。スペーサーオカレンス12個も +30° 移動して穴と一致
- **M4→M3+Ø6ワッシャ**: 旧M4想定箇所の穴を全て Ø3.5(M3クリアランス)へ変更 — フレーム締結穴 (44.5,±29)+(62,±29)、スペーサー穴、その他のフレーム穴を含む。ボルト+Ø6ワッシャ+ナットの挟み締結(平面部にワッシャ座面を確保)
- **スペーサー本体の M3 化**: `Spacer_M4x50` → `Spacer_M3x50` へ改名・再構築 — 外径 Ø6.2・通しボア Ø3.2・長さ50 mm(両端フラット)、単一ボディ 1107.4 mm³
- **フェイス板の M2.5 化(例外)**: ギアボックス締結のみ M2.5 を維持 — Ø3.5 貫通穴を充填して Ø2.9 で開け直し、ワッシャポケットを Ø7.2→Ø6.0(M2.5 ワッシャ Ø5.5 想定)へ。再構成中にポケット間ウェブが消失したため、フェイス板は中央 Ø25 ボス構造へ再構築(ノーズ Ø8 + 4×Ø2.9 + 4×Ø6.0 ポケットをボスが担う)
- **体積・質量**: 51.443 cm³、60面、CG (55.63, 0, 128.32) mm(球心上 78.3 mm・半径方向 55.6 mm)、CG基準慣性テンソル(鋼) Ixx/Iyy/Izz = 2.012/1.181/1.761 kg·cm²(Ixz=−0.12)。Frame_L1 = 43.994 cm³、L2/L3 = 各 59.203 cm³(後述のスタブ除去後)、スペーサー = 1107.4 mm³×12

v23 Frame_L2/L3 スタブ除去(現行): 旧スペーサー穴の充填プラグが板両面へ約5 mm ずつ突出したまま残っていたため、両円板を穴付き単一押出(L2: z=200–203 / L3: z=253–256、Ø160・中央 Ø20・スペーサー穴 Ø3.5×6 回転パターン)として作り直し、旧フィーチャ履歴を新しい順に削除。結果: 各層 単一ボディ・59.203 cm³(旧60.381)、全フレーム/マウント/スペーサー間干渉0、12個の asBuiltJoint(スペーサー)維持を保存+再オープンで検証

## 配置(案B: 内向き同軸格納、λ = 33°)

車軸方向の単位ベクトルを `u_i`(水平から57°上向き・内側)とする。モーターは車軸上をホイールから中心軸へ向かって延び、尾部が Frame_L1 のクリアランス穴を通過する。

- ホイール中心: r = 62.06 mm・z = 90.30 mm・球中心距離 74.0 mm(接線接触)
- モーター前面(タップ面): 車軸座標 s′ ≈ 18.5–18.6 mm(板裏面 s′=18.45 にほぼ面一着座、実測面 ~18.55)
- モーター CG: z = 130.6 mm(球心上 80.6 mm)、半径方向 35.8 mm
- 尾部先端: z ≈ 154 mm、ρ ≈ 20 mm → Frame_L1 の Ø48 穴を貫通
- 隣接ホイール間の最小隙間: 62.1 mm

## 部品構成

| 部品 | 役割 | 締結 |
|---|---|---|
| MotorMount_v23 | 角筒マウント(外形=締結プレート寸法 48×48 mm角・厚壁角筒 ＋ フェイス板 s′=14–18.45 ＋ +n′壁フレーム方向延長 → 水平締結プレート z=141–147 を一様長方形 x=34–72.5・y=±34 へ拡張、フレーム側斜め隙間を楔充填・モーター端部下端角は面取り、単一ソリッド) | ギヤボックス前面 M2.5×4(板貫通) + プレート Ø3.5 穴×4 → Frame_L1 板と M3 ボルト+Ø6ワッシャ+ナットで挟み締結 |
| ホイールアダプタ WheelAdapter_v4 | ホイールハブ内のスルーボア管(外径 Ø11.9・ボア Ø4.2、モーター側端 s′=+11.5 まで延長)→ Ø4.2 Dシャフトが 3.7 mm 係合(先端 s′=7.8)、実機ハブの Dカット向け止めネジで軸方向固定 | `parts/WheelAdapter_v4.step/.stl` |
| ~~MotorClampStrap_v1~~ | **廃止** — 設置空間なし(ハブブラケットと不可避干渉) | — |

### 締結方針(要件との対応)

- **フレーム1層との固定(ボルト・ナット挟み式)**: 締結プレート(一様長方形 x=34–72.5・y=±34・z=141–147 mm)の上面は Frame_L1 下面に面一で接し、プレート上の Ø3.5 垂直穴×4((44.5,±29)+(62,±29) mm)とフレーム板の同位置 Ø3.5 穴を通す M3 ボルト+Ø6ワッシャ+ナットで挟み締結する
- **ギアボックス前面との締結**: モーターを尾部側開口から車軸方向へ角筒内(内寸30×30)にスライド挿入し、前面ボスを板内面の Ø18.4 カウンターボア座面へ着座。ホイール側ボス面の Ø6.0 ポケットから M2.5 ボルト+Ø5.5ワッシャーでギアボックス前面 PCD17 タップへ締結(同軸確認済み)。さらに角筒が胴体を包み、径方向の拘束を分担
- **インサートナット不要**: v23 にインサートポケットは無い
- **連続面**: 単一ソリッド、解析面のみ(60面)

### モーターマウントの形状(v23 長方形プレート締結角筒式)

- **四角筒(厚壁)**: 外寸 48×48 mm(y±24・n′±24 = 締結プレートと同じ幅)、内空 30×32 mm(y±15・n′−15..+17)、車軸方向 s′=14–58。側壁9 mm・床壁9 mm・フレーム側壁7 mm(17..24)。尾部側は開放(挿入口)
- **フェイス板**: 筒の車軸側端を閉塞する板(s′=14–18.45、筒外形断面)。中央 Ø25 ボスが穴仕様を担う: Ø8 ノーズ + PCD17 Ø2.9×4(M2.5) + Ø6.0 ワッシャポケット×4
- **フレーム延長壁**: +n′側の壁(n′=17–24、モーター尾部コネクタ n′≲15.5 を回避)を筒の尾部端から s′=64 まで延長し、上面を z=147 で水平トリム — 筒壁がそのままフレームへ届く構成
- **水平締結プレート(一様長方形)**: 延長壁上端から張り出す水平板(z=141–147)を全長にわたり **x=34–72.5・y=±34 の一様長方形**とした(v20 の主部+翼タブ段差を解消)。上面 z=147 = Frame_L1 下面に面一密着、Ø3.5 垂直穴×4((44.5,±29)+(62,±29) mm)。内端は U字スロット(x=33–53・y±13.5)で尾部コネクタを回避
- **モーター端部下端角(接線平行面取り)**: x=34 端面と −n′外面が交わる角 ((34,±24,88.78) mm) を、ボール・ホイール接線に平行な平面(法線=車軸方向 (0.839,0,0.545)、フェイス板と平行)でカット — 端面側約14.7 mm・底面側約8 mm。板の穴仕様・筒内空・床面は維持
- **フレーム側楔充填**: +n′壁の斜め外面(57°)とプレート下面 z=141 の間の三角隙間を充填 — 筒のフレーム側端面(x=72.5)が壁底 z≈114 からプレート下面 z=141 まで連続する垂直面となった
- **旧穴充填**: 旧締結穴(62,±19.5)は充填済み。充填プラグのプレート下面への残存突起(スタブ)と円形インプリント痕も除去し、プレート下面は z=141 で完全にフラット
- **垂直カット**: プレート内端(x=34)より内側・プレート外端(x=72.5)より外側の材料を除去 — 平面視の外形が締結プレートと一致
- 単一ソリッド 51.443 cm³、不要な凹凸なし

### 3Dプリント指針

- **印刷姿勢**: 単一品。**締結プレート上面(z=147、Frame_L1 接触面)をベッド面とする伏せ姿勢**が基本 — フレーム側楔充填により筒端がベッドへ面一で届き、伏せ時の自立輪郭が確保される(モーター端部下端角は面取り済み)。筒開口は横向き。サポート要否はスライサーで確認
- **穴**: 板の Ø8/Ø2.9/Ø6.0 穴は車軸方向(斜交穴)、締結プレート・スペーサー穴の Ø3.5 は垂直穴。実寸公差はクーポン試刷で確認(Ø2.9・Ø3.5 はドリル整形想定)
- **組立手順**: マウントを L1 へ M3×4(+Ø6ワッシャ+ナット) で固定 → モーターを尾部側開口から角筒へスライド挿入 → M2.5×4 で板締結(逆順でも可。実作業性は要確認)
- **材質**: ABS/PETG/ナイロン想定(反り・変形はPETG推奨)。Fusion 上の材質は鋼(仮置き)のため質量は体積換算値を使用

## 検証結果

`fit0521_mount_validation.json` に機械可読の結果を出力。

### v23(Fusion 360 BRep ブール演算 交差、オカレンス座標ボディ、全3ステーション)

| 組合せ | 結果 |
|---|---|
| マウント–モーター/ホイール/アダプタ/Frame_L1/ボール | 干渉 0 mm³(全3ステーション) |
| モーター–ホイール/アダプタ/Frame_L1/ボール | 干渉 0 mm³ |
| ホイール–アダプタ/Frame_L1/ボール、アダプタ–Frame_L1/ボール、Frame_L1–ボール | 干渉 0 mm³ |
| 板穴–ギアボックスタップ | 同軸(PCD17、n/y = ±8.5/0・0/±8.5 で一致、Ø2.9 貫通=M2.5) |
| プレート穴–Frame_L1実穴 | Ø3.5 垂直穴 同軸一致(44.5,±29)+(62,±29) mm×3ステーション(一様長方形プレート上)、プレート上面 z=147 = フレーム下面(密着・干渉0) |
| スペーサー穴–オカレンス | 全層 Ø3.5・回転パターン {0,±60,±120,180}・r=65、Spacer_M3x50(OD6.2/ボアØ3.2/50mm)×12と一致 |
| モーター軸–車軸 | dot = 1.0000(全3ステーション)、モーター面 s′≈18.5–18.7 が板座面(Ø18.4 カウンターボア)に対向着座 |
| モーター胴体–筒隙間 | 筒内面 y=±15・n′=−15/+17 に対し胴体 Ø25(半径12.5) → 半径隙間 2.5 mm(−n′・両側)/4.5 mm(+n′) |
| モーター尾部コネクタ–延長壁/フランジ | コネクタ n′≲15.5 に対し壁内面 n′=17、フランジ内端 U字スロット(x=33–53・y±13.5)で回避 — 干渉 0 mm³ |
| アダプタ–車軸 | 全3ステーションで û33 と同軸(Ø4.2 貫通ボア、モーター側 s′=+11.5 まで延長→シャフト係合 3.7 mm) |
| アセンブリ構成 | MotorMount_v23 ×3(保存+再オープンで維持確認済み) |

### λ = 33° 幾何の検証値

| 項目 | 実測 | 目標 |
|---|---|---|
| ホイール接触緯度 | 33.00°(3輪とも) | 33° ± 0.5° |
| ホイール中心半径 | 62.06 mm | 62.1 ± 0.3 mm |
| ホイール中心高さ | 90.30 mm | 90.3 ± 0.3 mm |
| 球中心–ホイール中心距離 | 74.0 mm | 74 mm(接線接触) |
| 車軸水平角 | 57.0° | 57° |
| 隣接ホイール隙間 | 62.1 mm | ≥ 40 mm |
| ボール–モーター最小隙間 | 約11.8 mm(車軸線-球心距離74 mm − 球半径50 − モータ半径12.2) | ≥ 10 mm |
| 最大外形 | 直径167.5 mm | ≤ 直径250 mm |

### 質量プロパティ(Fusion 実測)

| 部品 | 体積 | CG(球心上高さ/半径方向) |
|---|---|---|
| MotorMount_v23(単一ソリッド) | 51.44 cm³ | 78.3 mm / 55.6 mm |
| FIT0521(CAD固体) | 27.05 cm³ | 79.0 mm / 37.1 mm |
| ホイール | — | 40.4 mm / 62.0 mm |
| アダプタ(延長後) | 1.217 cm³ | 44.7 mm / 59.2 mm |
| Frame_L1(穴開き実測) | 43.99 cm³ | 98.5 mm |

`ballbotParameters.m` には ABS 密度(1050 kg/m³)換算で反映: mountMass ≈ 54.0 g(51.44 cm³)。CG基準慣性テンソル(鋼実測) Ixx/Iyy/Izz = 2.012/1.181/1.761 kg·cm²(Ixz=−0.12) → ABS 換算して mountTiltI=1.58e-5・mountYawI=2.36e-5 kg·m²。スペーサーは Spacer_M3x50(OD 6.2/ボア Ø3.2/50 mm = 1107.4 mm³)×12。

## λ65復帰の原因究明と根絶

保存・再計算時にモーターオカレンスがλ65姿勢へ巻き戻る現象が繰り返し発生していた。原因究明の結果、以下を除去した。

- **破損した剛性asBuiltJoint(剛性108)**: 削除済みオカレンスを参照するジョイント(`occPath1.valid()` = InternalValidationError)が、λ65時代に捕捉した変換を再計算時に生存オカレンスへ再適用していた → 削除。削除後の保存でモーター3台のλ33姿勢が維持されることを確認
- **λ65時代の部品エクスポート**: `parts/` の MotorMount_v4/v5/v6/v7/v9、MotorClampStrap_v1、WheelAdapter_v3、`cad/` の fit0521_motor_clamp_strap、fit0521_motor_mount_bracket、MotorMount_v10(外向き)を削除 — 再インポートによるλ65幾何の混入経路を遮断(git履歴には残存)
- **λ65変換で生成された旧モーターオカレンス(:8/:11/:12/:14/:15)**: 削除
- **オカレンス変換の保存時巻き戻し(第2の原因)**: 破損ジョイント除去後も、API で設定した `transform2` が保存時に旧姿勢へ戻る現象が残存した。根絶策として、各ステーションの最終姿勢をコンポーネント幾何へ直接焼き込んだ **FIT0521_P0/P1/P2**(オカレンス変換=恒等行列、巻き戻る変換が存在しない)へモーターを再構築。保存 + 閉じる/再オープン後も λ33 姿勢(ギア面 s′=20.0)が維持されることを検証済み
- **omnirover3wd_reference**: オムニホイール以外は本機と無関係のためディレクトリ削除(READMEのデータシートリンクは `cad/parts/omniwheel_14108.step` 参照へ修正)

残存: Fusionクラウドのドキュメント・バージョン履歴にはλ65版(v1–v17)が残るが、現行ドキュメント内の再計算パスは除去済み。

## 未確定事項・残課題

- **モーター保持は面ボルト4本+角筒**: v23 はギアボックス前面 PCD17 タップへの M2.5 締結に加え、角筒が胴体を拘束する(垂直カットで尾部側の下面・下面側面は開放)。胴体拘束の実効性は印刷公差を含めて実機確認
- **延長プレートのナット側アクセス**: 締結穴(44.5,±29)+(62,±29)は内外2列 — ナット・スパナのアクセス空間と、プレート端の印刷強度は実機で確認
- **ギアボックス前面M2.5タップの実寸**: PCD17(±8.5 mm)のタップとして実装。実機採寸で径・有効深さを確定する
- **モーター挿入・締結作業性**: 尾部側開口から胴体 Ø25 を角筒内寸 30×30 へスライド挿入する通過確認、およびワッシャーポケット内でのボルト締結工具(精密ドライバ)アクセスは実印刷で確認。CAD干渉ゼロは実作業性を保証しない
- **尾部配線**: モーター尾部は Frame_L1 の Ø48 穴を貫通する。エンコーダ配線も同穴経由で引き回す前提(穴径は配線コネクタ通過を含めて確定)
- **Frame_L1 剛性**: Ø48 穴×3が中央開口と繋がり、外周部が残る形状。L1荷重(バッテリ等)に対する剛性確認は残課題
- **アダプタボアの公差**: ボア Ø4.2 とシャフト Ø4.2 は公称ゼロクリアランス。印刷の実寸収縮を考慮し、必要ならボアを Ø4.3–4.5 へ拡大するか挿入後リーマ仕上げとする
- **印刷品質の実機確認**: スライサーでのプレビュー(サポート不要の確認)、実寸公差(Ø8/Ø3.5/Ø7.2/Ø4.6 の実測)、積層方向強度は実印刷で確認する。実装前に公差クーポンの試刷を推奨

## 生成ファイル

| ファイル | 内容 |
|---|---|
| `parts/FIT0521.step` | モーター実装モデル(出力軸 Ø4×12 Dカット丸軸) |
| `parts/MotorMount_v23.step/.stl` | 長方形プレート締結角筒マウント・楔充填印刷伏せ対応+モーター端部下端角面取り(3個共用) |
| `parts/MotorMount_v18.step/.stl` | v18 角筒マウント(比較・ロールバック案として残置) |
| `parts/MotorMount_v17.step/.stl` | v17 一体成型クレードルマウント(比較・ロールバック案として残置) |
| `parts/MotorMount_v14.step/.stl` | v14 一体式板+柱マウント(比較・ロールバック案として残置) |
| `parts/MotorMount_v13.step/.stl` | v13 スリーブ式マウント(比較案として残置) |
| ~~`MotorMount_v10/step/.stl`~~ | λ65外向きマウント — λ65復帰原因の除去のため削除(git履歴に残存) |
| `ball_balancing_omnirover3wd_assembly.f3d/.step/.stl` | 全体アセンブリ(λ=33°、案B、v23 角筒マウント) |
| `fit0521_mount_validation.json` | 干渉・隙間・質量プロパティの検証結果 |

現行形状は Fusion 360 アセンブリ(`ball_balancing_omnirover3wd_assembly`)内の MotorMount_v23(×3)が正であり、MotorMount_v18・v17・v16・v15 3部品(MountPlate_v15/MountPillar_v15_R/_L)および MotorMount_v14 のオカレンスは削除済み。MotorClampStrap_v1 も削除済み。Fusion計測の質量プロパティは `ballbotParameters.m` へ ABS 密度換算で反映済み。
