nenecchiCV/ball-balancing-omni-rover/specs/hardware_design/controll/ball_balancing_omnirover3wd/ball_balancing_omnirover3wd-system.md

# 玉乗り3WDオムニローバー制御・推定システム仕様

## 状態

| 項目 | 値 |
|---|---|
| ステータス | 実装中 |
| 最終更新日 | 2026-09-09 |
| 対象モデル | `matlab_ws/ball_balancing_omni3/ball_balancing_omni3_multibody_lqi_custom_contact_fullplant.slx` |
| 機構仕様 | [玉乗り3WDオムニローバー機構仕様](../../mechanism/ball_balancing_omnirover3wd/README.md) |

## 1. 目的

3輪オムニ機構を球の駆動系として用い、固定結合を持たないローバーを球上に維持しながら、ワールド座標の任意方向並進速度とヨー角速度を追従させる。制御器は6軸IMUと3輪エンコーダーのみを入力とし、ボール回転、機体速度、機体–ボール相対変位を内部推定する。実機展開に向け、エンコーダーで低運動状態を認定した区間だけヨー軸ジャイロバイアスを学習し、ヨードリフトを低減する。

## 2. 成功条件

| ID | 指標 | 目標 | 検証 |
|---|---|---:|---|
| G-01 | 静止時ロール・ピッチ | 定常値 ±1 deg | 閉ループMIL |
| G-02 | 0.10 m/s速度ステップ | 整定誤差 ±0.01 m/s | 閉ループMIL |
| G-03 | 0.5 rad/sヨー速度ステップ | 整定誤差 ±0.05 rad/s | 閉ループMIL |
| G-04 | 接触維持 | 3輪接触率 99%以上 | truthログのみで判定 |
| G-05 | ボール–床接触維持 | 分離時間 0 s | truthログのみで判定 |
| G-06 | 推定姿勢 | ロール・ピッチ誤差 0.5 deg以内 | truthとの比較 |
| G-07 | 推定速度 | 平面速度誤差 0.02 m/s以内 | truthとの比較 |
| G-08 | アクチュエーター制約 | 輪速・輪トルク上限超過なし | 回転変位ログの差分値とトルクログで判定 |
| G-09 | ヨー軸バイアス収束 | 0.02 rad/s注入時、15 s以内に誤差0.002 rad/s未満 | MATLAB単体/MIL |
| G-10 | 学習後ヨードリフト | 静止10 sで0.5 deg未満 | MATLAB単体/MIL |
| G-11 | 運動中の誤学習防止 | バイアス推定値変化0.002 rad/s未満 | MATLAB単体/MIL |

## 3. 適用範囲

| 対象 | v1 |
|---|---|
| 物理モデル | 上部ロッドを含む剛体、球–床接触、3組のcustomホイール–球接触、接触分離、異方性摩擦 |
| 制御 | 平面速度、ロール・ピッチ、ヨー角速度、モード、飽和、積分器アンチワインドアップ |
| 推定 | 姿勢、平面速度、ボール角速度、機体–ボール相対変位、ヨー軸ジャイロバイアス、低運動継続時間 |
| センサー | 比力、角速度、車輪回転変位。MILではバイアス・ノイズ・振動を注入可能 |

| 非対象 | 理由 |
|---|---|
| ヨー軸以外のジャイロバイアス・温度モデル | 実機IMU選定と温度試験後に拡張するため |
| ボール変形の有限要素モデル | 接触ペナルティモデルで制御帯域を評価するため |
| ローラー個別剛体 | 異方性摩擦として等価化するため |
| 絶対位置の長期保持 | IMU・エンコーダーのみでは絶対位置が観測不能なため |

## 4. 運転シナリオ

| ID | 条件 | 指令 | 期待動作 |
|---|---|---|---|
| S-01 | 直立・静止初期値 | $v_d=0$, $r_d=0$ | ロール・ピッチ0、全接触維持 |
| S-02 | 直立 | $v_{x,W}:0\rightarrow0.10$ m/s | 一時的前傾後、速度追従 |
| S-03 | 直立 | $v_{y,W}:0\rightarrow0.08$ m/s | 一時的横傾斜後、速度追従 |
| S-04 | 直立 | $r_d:0\rightarrow0.5$ rad/s | 並進速度を維持してヨー回転 |
| S-05 | 10 deg初期傾斜 | $v_d=0$, $r_d=0$ | BALANCEで直立復帰 |
| S-06 | 20–35 deg傾斜 | 任意 | RECOVERYで速度・ヨー指令を抑制 |
| S-07 | 35 deg以上 | 任意 | FALLENでトルク0、積分器リセット |
| S-08 | 摩擦係数-20% | S-02 | 飽和下で接触維持、性能劣化を記録 |

## 5. 外部インターフェース

### 5.1 入力

| 名前 | 記号 | 次元 | 単位 | サンプル時間 | 範囲 | 符号 |
|---|---:|---:|---:|---:|---:|---|
| ワールドX速度指令 | $v_{x,d}^W$ | 1 | m/s | 5 ms | ±0.12 | $+X_W$ |
| ワールドY速度指令 | $v_{y,d}^W$ | 1 | m/s | 5 ms | ±0.12 | $+Y_W$ |
| ヨー角速度指令 | $r_d$ | 1 | rad/s | 5 ms | ±0.80 | $+Z_W$右手 |
| 制御有効 | enable | 1 | logical | 5 ms | 0/1 | 1=有効 |
| IMU比力 | $f^B$ | 3 | m/s² | 5 ms | double | $B$軸 |
| IMU角速度 | $\omega_{IMU}^B$ | 3 | rad/s | 5 ms | double | $B$軸右手。ヨー成分はバイアスを含み得る |
| 車輪回転変位 | $\theta_w$ | 3 | rad | 5 ms | double | $+a_i$ |

### 5.2 出力

| 名前 | 記号 | 次元 | 単位 | サンプル時間 | 範囲 |
|---|---:|---:|---:|---:|---:|
| 車輪軸トルク | $\tau_w$ | 3 | N·m | 5 ms | ±`min(p.controller.tractionLimitedWheelTorque, p.controller.fullplant.motorTorqueLimit)`（正本構成の公称±0.010） |
| 推定状態 | $\hat z$ | 14 | 混合 | 5 ms | [理論仕様](ball_balancing_omnirover3wd-control-estimation-theory.md) |
| 制御モード | mode | 1 | uint8 | 5 ms | 0,1,2 |

推定状態出力`estimate`は13要素とする。`estimate(4:6)`は生ジャイロではなく、前回サンプルまでの推定バイアスを差し引いた機体角速度とする。末尾の接触信頼度要素は実測で常に~1（49.5 s全サイクル中t=0.01の初期1サンプルのみ低下）かつmode遷移・バイアス学習ゲートの両方で不発だったため削除した。なおモデル内の推定バスは保存済みSelector範囲（15:28）を維持するため14幅のままとし、末尾要素は未使用パッド（常時0）である。

### 5.3 診断出力

| 名前 | 記号 | 次元 | 単位 | 意味 |
|---|---:|---:|---:|---|
| ヨー軸バイアス推定値 | $\hat b_{g,z}$ | 1 | rad/s | 当該サンプル末に更新した値 |
| バイアス学習許可 | $\gamma$ | 1 | logical | 1のサンプルだけバイアスを更新 |
| 低運動継続時間 | $t_{qual}$ | 1 | s | 候補不成立で0、成立中は$t_{min}$まで増加 |

診断3信号はSimulinkログと実機テレメトリで確認できる構成とする。学習許可は起動時のヨー制御抑止解除判定にも内部使用する。

### 5.4 truth出力

| 名前 | 用途 | 制御器への接続 |
|---|---|---|
| 機体6DoF位置姿勢 | 検証 | なし |
| ボール6DoF位置姿勢 | 検証 | なし |
| 4接触の接触信号・法線力・すべり | 検証 | なし |
| 推定誤差 | 検証 | なし |

## 6. 運転モード

| 値 | モード | 進入条件 | 動作 | 積分器 |
|---:|---|---|---|---|
| 0 | DISABLED/FALLEN | `enable=0` または傾斜≥35 deg（一旦進入すると終端・復帰なし） | 全輪速度指令0、駆動電圧0 | 0へリセット |
| 1 | BALANCE | 傾斜<5 deg（mode 2からの退出は2 degヒステリシス） | 速度・姿勢・ヨーの全制御 | 条件付き積分 |
| 2 | RECOVERY | 傾斜5–35 deg | 姿勢チャネルのみの高ゲイン律で直立復帰を優先 | 0へリセット |

正本構成では `p.controller.recoveryTilt=5` deg、`recoveryExitTilt=2` deg、`recoveryGainScale=3.0` とする。起立時の初期傾きが大きい場合に早期発動させるため旧17 degから引き下げた。mode 2ではLQI状態の速度・ヨーレート・輪速チャネル（速度系チャネルはtorque LQIゲインが元々ゼロ）をゼロ化し姿勢のみを制御する。

リーン目標との競合不変式: `leanSetpointLimit`（並進のための傾き指令上限）は `recoveryTilt` より十分小さく保つ。通常運転の傾き実測は最大 ~0.026 rad（最悪ケース、旧設定では ~0.012 rad）で、`leanSetpointLimit=0.015` rad の指令帯＋トラッキングオーバーシュートでも 5 deg（0.087 rad）閾値へは ~3 倍以上の余裕があり、リーン追従が誤ってリカバリを発動することはない。静的保持コーン（現行牽引上限 ~0.162 N·m で ~0.23 rad ≈ 13 deg）はこの上限を超えるため物理的余地はあるが、リーン上限を閾値へ近づける変更はリカバリ発動条件との同時再設計を要する。

また mode 2 への進入は `elevatedAuthority` フラグを立て、車輪が静止するまで（filtered輪速<1.5 rad/s）保持する。有効中はモードに関わらずトルク上限を `recoveryWheelTorqueLimit`（公称牽引上限と同じ ≈0.162 N·m — 旧来は公称が陳腐な 4.07 N 静止荷重で実際の接触予算の半分に飢餓していたため 2 倍に引き上げていた）とする。接触信頼度ゲートは全運転域で不発だったため削除した。

**mode 0 は終端状態**: 傾斜≥35 deg（または `enable=0`）で一旦 mode 0 に入ると、そのラン中は mode 1/2 へ復帰しない。fallen→recovery の再突入は、床で機体がバウンスして傾斜が 35 deg を割るたびに発動し、床への反復フェースプラントになる（実測: ドリフト ~22 s 後に 0.55→0.03 rad のバウンスサイクルが反復）ため、再突入経路は実装しない — 実機での反復転倒破損を防ぐ安全仕様。復帰は新規ラン（実機では電源/コントローラ再起動）のみ。

**初期傾き起立の実測包絡**: 傾き注入は `p.rover.initialEulerWorld`（プラント配置・6-DOFターゲット・推定器初期状態が共有）で行う。検証結果は — 5–7 deg: 全方向合格、10 deg: **全6方位で ~15–25 s 保持**（60°/90°方位は25 s完走、他方位はドリフトが ~10 m 伸びた後に再転倒。速度状態LQI導入前は純粋ロール ~8.6 s・settle制御導入前は ~4–6 s）。λ=33 再導出後（`leanSetpointLimit=0.015`・加速ランプ 0.06 m/s²・牽引上限を実測静止荷重 8.45 N ベースの 0.162 N·m へ修正）の純粋ロール計測では **40 s 完走・転倒なし**（旧構成では ~15–25 s でボール喪失転倒）— ボールは ~0.5 m/s でドリフトし続けるが、機体がドリフトに追従して支持を失わなくなった。elevatedAuthority 中の mode 1（settle）は推定器のボール速度・機体速度チャネル（ドリフト中にそれぞれ ~7 倍・~3 倍のバイアスを実測）を捨て、エンコーダ輪速から逆解した運動学レート（`pinv(wheelSpeedFromPlanarVelocity)*filteredWheelRate`、~0.25 s 一次フィルタ）をチェイス目標・速度誤差・スリップ基準に共用する（`settleFollowGain=1.0` の純粋追従）。`settleLeanDamping=1.0` はフィルタ済みドリフト加速度をリーン要求から減算し、IMU加速度バイアス（ドリフト中 est-real ~0.016 rad実測）の相殺を兼ねる。settle専用の `settleLeanGain=1.0` はドループを超過する制動リーン要求を出す（通常運転の `velocityLeanGain=0.3` には影響しない）。

速度状態付きLQI（`ballbotVelocityTorqueGains`）は10状態プラント [v; tilt; rate; yaw; wheels]（dv/dt = g·tilt + forceScale·W'τ/mEff、輪行は運動学レートへのcompliance結合）で速度列を設計する。フィードバック `state(1:2)=ballVelocityBody−commandVelocityBody` は **elevated-authority settle 中のみ有効** — 通常運転で有効化すると力チャネルが惰性走行ボールを牽引駆動する回帰（停止脚 ~0.2 m/s残留）を確認したため。settle中の速度ゲインは yaw-tilt シミーを減衰させる（保持 ~8.6 s→20 s級）が、ドリフト自体を止められない。

ドリフトの残存機構と牽引上限の再評価: 以前「接触トラクション ~0.078 N·m/輪が物理上限」と結論したが、これは65°時代の静止荷重 4.07 N を残していた**推定側の飢餓**だった — λ=33 実測の静止荷重は 8.45 N/輪（物理限界は μ=2.0 換算で ~0.41 N·m/輪、推定側は μ_est=1.0・80% ディレートで 0.162 N·m/輪へ修正済み）。修正後は直接ブレーキなしでも 10° 純粋ロールで **40 s 完走・転倒なし**: ボールは依然 ~0.5 m/s でドリフトするが、機体がドリフトへ追従して支持を失わなくなった（ドリフトの減速自体は未達 — IMU加速度バイアスが残す真のリーン残留が重力供給を止めない）。残課題はドリフト制動（真値に近い姿勢・速度推定または更なる権限配分）であり、転倒して床に倒れる失敗形態はこの包絡では解消した。

**非理想床**: `p.simulation.floorSlopeDeg` と `floorSlopeAzimuthDeg` で接触平面を傾斜できる（GroundFrameをランタイム回転、重力はワールド鉛直のまま。重力ベクトルを傾ける方法は勾配ではなく水平加速を生じるため不適）。実測: 1 deg勾配は保持、2 deg以上は斜面を転がり落ちる。凹凸床はGrid Surfaceへの構造的置換が必要（未実装）。

## 7. 初期値・タイミング

| 項目 | 値 |
|---|---:|
| 推定器初期クォータニオン | $[1,0,0,0]^T$ |
| 推定速度・ボール角速度・相対変位 | 0 |
| ヨー軸ジャイロバイアス推定値 | 0 rad/s |
| 低運動継続時間 | 0 s |
| 制御器サンプル時間 | 5 ms |
| 推定器サンプル時間 | 5 ms |
| Multibodyプラント | 連続 |
| 最大ソルバーステップ | $1.0\times10^{-4}$ s |
| 相対許容誤差 | $1.0\times10^{-4}$ |

## 8. 観測可能性の境界

| 状態 | 理想条件での扱い | 実機で必要な追加情報 |
|---|---|---|
| ロール・ピッチ | 加速度方向+ジャイロで推定 | バイアス同定 |
| ヨー | 初期値+バイアス補正ジャイロ積分 | 磁気・視覚・外部方位 |
| ヨー軸ジャイロバイアス | 低運動・高接触信頼区間のIMUヨー角速度 | 実機IMUノイズ・温度特性に基づく調整 |
| 平面速度 | 比力積分+接触運動学で推定 | 外部速度または位置補正 |
| 絶対平面位置 | 制御対象外 | GNSS、UWB、LiDAR、視覚 |
| ボール角速度 | 車輪回転変位の微分値+地面無すべり仮定で推定 | ボールマーカー等 |
| 接触分離 | 運動学残差から信頼度を推定 | 荷重・距離センサー |

車輪エンコーダーは低運動状態の認定に使用する。絶対ヨー角の観測には使用しない。走行中は、車輪回転だけから機体ヨー角速度とボール角速度を常時かつ一意に分離できるとは仮定せず、バイアス学習を停止する。

## 9. ヨー軸ジャイロバイアス学習条件

低運動候補は、最大車輪角速度、比力ノルム偏差、ロール・ピッチ角速度、バイアス補正後ヨー角速度の全条件で判定する。候補が0.50 s連続した後だけ学習し、いずれかの条件が退出側閾値を超えたサンプルでは更新せず継続時間を0へ戻す。認定後は1.25倍の退出側閾値を用い、境界付近のチャタリングを抑える。

バイアス更新は時定数1.0 sの一次遅れ、絶対上限±0.10 rad/s、1サンプル更新量上限$1.0\times10^{-4}$ rad/sとする。時定数は、0.5 sの認定後にマルチボディモデルが低運動域を保つ時間内で0.02 rad/sの注入値へ収束し、15 s収束目標を満たす暫定値である。起動時は補正後ヨー角速度が0.002 rad/s以下になるまでヨートルクだけを抑止し、ロール・ピッチ安定化は継続する。解除状態はラッチし、明示的な非ゼロヨー指令は抑止をバイパスする。実機ではIMUのゼロレート出力、ノイズ密度、温度ドリフト、車輪エンコーダー量子化、機体振動を測定して更新する。

## 10. 関連文書

- [アーキテクチャ](ball_balancing_omnirover3wd-architecture.md)
- [制御・状態推定理論](ball_balancing_omnirover3wd-control-estimation-theory.md)
- [実装計画](ball_balancing_omnirover3wd-implementation-plan.md)
- [検証計画](ball_balancing_omnirover3wd-test-plan.md)
