nenecchiCV/ball-balancing-omni-rover/specs/hardware_design/controll/ball_balancing_omnirover3wd/ball_balancing_omnirover3wd_lqi_theory.md

# 玉乗り3WDオムニローバーLQI制御理論

## 1. 目的

本書は、玉乗り3WDオムニローバーを直立近傍で安定化し、ワールド座標の平面速度とヨー角速度へ追従させるLQR/LQI制御系を定義する。制御設計には4接触を完全拘束として縮約した低次モデルを使用し、閉ループ検証には電圧駆動サーボモーターをSimscape Electricalで表現した非線形モデルを使用する。

採用する方針は次の3点である。

1. ボール―床1点とボール―ホイール3点の計4接触を、直立近傍では常時成立する完全拘束として扱う。
2. 接触ばねの貫入量とその速度は制御設計状態に含めず、拘束反力として消去する。
3. LQIは3輪の速度指令を生成し、各サーボの内側速度制御器がモーター印加電圧を生成する。電流、逆起電力、減速機、ローター・車輪慣性、粘性摩擦、電圧・電流制限はSimscape Electricalプラントで再現する。

このLQIは接触モードが変化しない局所制御器である。接触分離、大きなすべり、転倒からの復帰は、別のモード管理および非線形検証の対象とする。

## 2. 制御対象の境界

### 2.1 信号インターフェース

| 種別 | 信号 | 次元 | 単位 | 内容 |
|---|---|---:|---|---|
| 指令 | $v_d^W=[v_{x,d}^W,v_{y,d}^W]^T$ | 2 | m/s | ワールド座標の平面速度指令 |
| 指令 | $r_d$ | 1 | rad/s | ローバーヨー角速度指令 |
| 推定値 | $\phi,\theta$ | 2 | rad | ローバーのロール、ピッチ |
| 推定値 | $p,q,r$ | 3 | rad/s | ローバー物体座標の角速度 |
| 推定値 | $v_B^W$ | 2 | m/s | ローバー平面速度 |
| 推定値 | $\omega_w$ | 3 | rad/s | 車輪軸角速度 |
| LQI出力 | $\omega_{w,d}$ | 3 | rad/s | 3輪速度指令 |
| サーボ出力 | $v_a$ | 3 | V | 各モーターの等価電機子電圧 |

LQIの制御出力と物理プラント入力を区別する。

$$
\underbrace{\omega_{w,d}}_{\text{LQI出力}}
\longrightarrow
\underbrace{C_{\omega}(s)}_{\text{サーボ内側速度制御}}
\longrightarrow
\underbrace{v_a}_{\text{電気プラント入力}}
\longrightarrow
\underbrace{\omega_w}_{\text{実車輪速度}}
$$

市販連続回転サーボへの実機指令がPWMパルス幅である場合、$v_a$はPWMデューティ比と電源電圧から得る平均等価電圧と解釈する。実機用のPWM―速度非線形、デッドバンド、内部制御器が判明した場合は、その特性を内側サーボモデルへ追加する。

### 2.2 座標と符号

姿勢角は既存仕様に合わせ、ロール$\phi$を$+X_B$右手、ピッチ$\theta$を$+Y_B$右手、ヨー$\psi$を$+Z_B$右手とする。速度指令は、推定ヨー角を用いて機体座標へ変換する。

$$
v_d^B=R_z(\hat\psi)^Tv_d^W,qquad
v_B^B=R_z(\hat\psi)^Tv_B^W
$$

平面2軸を同形に扱うため、傾斜状態を、

$$
\alpha=
\begin{bmatrix}\alpha_x\\\alpha_y\end{bmatrix}
=
\begin{bmatrix}\theta\\-\phi\end{bmatrix},qquad
\dot\alpha=
\begin{bmatrix}q\\-p\end{bmatrix}
$$

と定義する。$\alpha_x>0$は機体上端が$+X_B$方向へ傾く状態、$\alpha_y>0$は機体上端が$+Y_B$方向へ傾く状態を表す。

## 3. 4接触完全拘束モデル

### 3.1 完全拘束の意味

設計モデルでは次を仮定する。

- ボール中心の高さは$R_b$で一定である。
- ボールと床の接触点では、水平2方向に無すべりである。
- 3個のホイールはボールから分離しない。
- 各ホイールの駆動転動方向では無すべりである。
- 各ホイールのローラー方向は自由であり、理想拘束力を発生しない。
- 接触面の変形、貫入、法線方向振動を状態に持たない。

「完全拘束」は接触力が無限大であることを意味しない。必要な接触力を代数変数として解き、その力が摩擦円錐と正の法線荷重の範囲にある間だけ、仮定が成立する。

### 3.2 接触拘束式

一般化座標を$q_m$、一般化速度を$\nu$、車輪速度を$\omega_w$とすると、完全拘束は、

$$
\Phi_n(q_m)=0
$$

$$
J_t(q_m)\nu-D_w\omega_w=0
$$

で表せる。$\Phi_n$はボール―床1本と車輪―ボール3本の法線位置拘束、$J_t$は床2方向と各ホイール駆動方向3本の速度拘束である。

ボール―床の無すべり条件は、

$$
P_{xy}\left[v_K^W+\omega_K^W\times(-R_be_3)\right]=0
$$

であり、

$$
v_{K,x}^W=R_b\omega_{K,y}^W,qquad
v_{K,y}^W=-R_b\omega_{K,x}^W
$$

を与える。

ホイール$i$の駆動方向拘束は、

$$
(t_i^W)^T\left[
v_B^W+\omega_B^W\times r_{F_i/B}^W
-v_K^W-\omega_K^W\times(R_bn_i^W)
\right]=R_w\omega_{w,i}
$$

である。

### 3.3 拘束縮約

拘束を満たす一般化速度は、独立速度$\nu_r$と車輪速度を用いて、

$$
\nu=N(q_m)\nu_r+G(q_m)\omega_w
$$

と表すことができる。ここで$N$は拘束ヤコビアンの零空間基底であり、$G$は車輪速度による特解である。

完全な運動方程式を、

$$
M(q_m)\dot\nu+h(q_m,\nu)
=S^T\tau_w+J(q_m)^T\lambda
$$

とする。$\lambda$は接触反力である。左から$N^T$を掛け、$N^TJ^T=0$を用いると、

$$
M_r(q_m)\dot\nu_r+h_r(q_m,\nu_r,\omega_w)
=B_r(q_m)\tau_w+E_r(q_m)\dot\omega_w
$$

を得る。代表的には、

$$
M_r=N^TMN,qquad B_r=N^TS^T
$$

である。この操作により接触反力$\lambda$と接触変形状態を制御設計モデルから除去できる。$E_r\dot\omega_w$は速度制御された車輪の加速度が機体・ボールへ与える反力を表す。

### 3.4 成立条件の事後確認

縮約モデルで計算した制御入力は、詳細モデル上で次を満たす必要がある。

$$
F_{n,g}>0,qquad F_{n,w,i}>0
$$

$$
|F_{t,g}|\le\mu_gF_{n,g},qquad
|F_{t,w,i}|\le\mu_dF_{n,w,i}
$$

いずれかを満たさない場合、完全拘束モデルの予測は無効になる。LQIゲインを変更して拘束違反を隠すのではなく、指令制限、モード遷移または非線形制御へ切り替える。

## 4. 接触変形状態を除く理由

ペナルティ接触モデルでは、各接触点に、

$$
F_n=k_nd+c_n\dot d
$$

に相当する高剛性モードが生じる。その代表固有角周波数は、等価質量$m_{eq}$に対して、

$$
\omega_c\approx\sqrt{\frac{k_n}{m_{eq}}}
$$

となる。既存値の$k_n=2.0\times10^5$～$3.0\times10^5$ N/mは、姿勢・速度制御より十分高速な接触振動を生じさせる。

接触変形をLQI状態へ含めると、次の問題が生じる。

- Riccati方程式が高速接触モードにも制御努力を配分する。
- 数値的な接触剛性や遷移幅の変更でゲインが大きく変わる。
- 実機で直接計測できない貫入量を状態推定する必要が生じる。
- 遅い姿勢制御と高速電気・接触系が混在し、重み調整が難しくなる。

そこで、設計モデルでは$d=0$を厳密に課し、接触変形は状態から完全に除く。ただし詳細Simscapeモデルでは有限剛性接触を維持し、設計されたLQIが接触高周波モードを励起しないことを検証する。

この方針は、

$$
\text{制御器設計モデル}\neq\text{最終検証モデル}
$$

を意図的に採用するものである。前者は制御則を明確にし、後者はモデル化誤差と接触限界を検出する。

## 5. サーボモーターの電気・機械モデル

### 5.1 DCモーター基本式

各サーボを、電機子回路、DCモーター、減速機、車輪負荷から構成する。モーター軸量には添字$m$、車輪軸量には添字$w$を付ける。

$$
L_a\dot i_a=v_a-R_ai_a-K_e\omega_m
$$

$$
J_m\dot\omega_m=K_ti_a-b_m\omega_m-\tau_{g,m}
$$

理想減速比を$N=\omega_m/\omega_w>1$、効率を$\eta_g$とすると、

$$
\omega_m=N\omega_w,qquad
\tau_w=\eta_gN\tau_m
$$

である。車輪側へ換算すると、

$$
L_a\dot i_a=v_a-R_ai_a-NK_e\omega_w
$$

$$
J_{eq}\dot\omega_w
=\eta_gNK_ti_a-b_{eq}\omega_w-\tau_{load}
$$

$$
J_{eq}=J_w+N^2J_m+J_g
$$

となる。$J_g$は減速機を車輪側へ換算した等価慣性、$\tau_{load}$は接触拘束を介してボールから戻る負荷トルクである。

SI単位系では数値的に$K_t=K_e$となる場合があるが、単位はそれぞれN m/AとV/(rad/s)であり、パラメーターとして分けて管理する。

### 5.2 電圧、電流、速度の制限

$$
|v_a|\le V_{dc}
$$

$$
|i_a|\le I_{max}
$$

$$
|\omega_w|\le\omega_{w,max}
$$

を適用する。既存の最高速度は、

$$
\omega_{w,max}=62\frac{2\pi}{60}\approx6.49\ \mathrm{rad/s}
$$

である。FIT0521のストールトルク0.981 N m、公称電圧6 V、ストール電流3.2 A、無負荷速度210 rpm、無負荷電流0.13 Aを初期制約として利用する。$R_a=1.875\ \Omega$、出力軸等価$K_t=0.306\ \mathrm{N\,m/A}$を公称値から推定し、$L_a,J_m,b_m$は実機試験で同定する。

ストール試験から得る一次近似は、

$$
R_a\approx\frac{V_{dc}}{I_{stall}},qquad
K_t\approx\frac{\tau_{stall}}{\eta_gNI_{stall}}
$$

である。無負荷試験では、

$$
V_{dc}\approx R_aI_0+NK_e\omega_{w,0}
$$

を利用できる。モーター端子へ直接アクセスできない市販サーボでは、これらを内部込みの等価パラメーターとして端子電圧―車輪速度―負荷トルク試験から同定する。

### 5.3 内側速度制御器

各輪の速度誤差を、

$$
e_{\omega,i}=\omega_{w,d,i}-\omega_{w,i}
$$

とし、PI制御で等価印加電圧を生成する。

$$
\dot\xi_{\omega,i}=e_{\omega,i}
$$

$$
v_{a,i}^{raw}=K_{p\omega}e_{\omega,i}+K_{i\omega}\xi_{\omega,i}
$$

$$
v_{a,i}=\operatorname{sat}(v_{a,i}^{raw},\pm V_{dc})
$$

電圧飽和中は、追跡型アンチワインドアップを用いる。

$$
\dot\xi_{\omega,i}
=e_{\omega,i}+K_{aw,\omega}(v_{a,i}-v_{a,i}^{raw})
$$

外側LQIが見る閉ループサーボは、設計初期には、

$$
\dot\omega_w=-T_s^{-1}\omega_w+T_s^{-1}\omega_{w,d}
$$

と近似できる。対称3輪なら$T_s=\tau_sI_3$であり、既存の暫定時定数$\tau_s=0.030$ sを初期値にできる。最終的にはSimscape Electricalモデルの周波数応答またはステップ応答から、輪ごとの$T_s$、遅延、DCゲインを同定して更新する。

### 5.4 Simscape Electrical構成

各輪の検証プラントは、概念的に次の要素で構成する。

```text
速度指令
  → 速度PI・電圧飽和・アンチワインドアップ
  → Controlled Voltage Source / PWM等価段
  → DC Motor（R, L, Kt, Ke, Jm, bm）
  → Ideal Gear または損失付き減速機
  → 車輪Revolute Joint
  → ボール接触負荷
```

電気基準、機械回転基準、電源内部抵抗を明示する。3輪同時加速時の電圧降下を評価する場合は、電源を共有し、

$$
V_{bus}=V_{oc}-R_{bat}\sum_{i=1}^{3}i_{a,i}
$$

に相当する電池内部抵抗も含める。

## 6. LQI用低次線形モデル

### 6.1 主要状態

4接触拘束を消去し、接触変形を除いた設計状態を、

$$
x_p=
\begin{bmatrix}
v_x^B&v_y^B&
\alpha_x&\alpha_y&
\dot\alpha_x&\dot\alpha_y&
r&
\omega_{w,1}&\omega_{w,2}&\omega_{w,3}
\end{bmatrix}^T
$$

とする。次元は10である。絶対平面位置、絶対ヨー角、ボール絶対姿勢、車輪回転変位は安定化に不要な積分座標なので、LQIの主要状態には含めない。

必要なログ出力は、低次状態から、

$$
\dot p_{B,xy}^W=R_z(\psi)v_{B,xy}^B,qquad
\dot\psi=r,qquad
\dot\theta_w=\omega_w
$$

を積分して再構成する。ボール中心速度・角速度は完全拘束の運動学から再構成する。

### 6.2 線形化

直立静止平衡点を、

$$
\alpha_0=0,quad\dot\alpha_0=0,quad
v_{B,0}=0,quad r_0=0,quad
\omega_{w,0}=0
$$

とする。縮約非線形モデルをこの点で線形化して、

$$
\delta\dot x_p=A_p\delta x_p+B_p\delta\omega_{w,d}
$$

$$
\delta y_p=C_p\delta x_p
$$

を得る。$A_p,B_p$には、機体・ボール慣性、重心高さ、3輪幾何、車輪半径、サーボ閉ループ時定数が反映される。

左右対称性が十分高くヨー運動との結合が小さい場合、平面運動は$x$軸系と$y$軸系へ分離できる。1軸モデルの例は、

$$
x_a=\begin{bmatrix}v&\alpha&\dot\alpha&\omega_a\end{bmatrix}^T
$$

$$
\dot x_a=A_ax_a+B_a\omega_{a,d}
$$

である。$\omega_a$は3輪速度を平面駆動方向へ変換した仮想アクチュエーター速度である。ただし最終設計では、3輪同時飽和とヨー結合を評価できる10状態MIMOモデルを使用する。

### 6.3 車輪速度配分

仮想平面・ヨー速度を、

$$
u_v=\begin{bmatrix}u_x&u_y&u_\psi\end{bmatrix}^T
$$

とし、3輪幾何行列$G_w$によって、

$$
\omega_{w,d}=G_wu_v
$$

へ変換する。$G_w$は$\beta_i$、接触緯度$\lambda$、$R_b$、$R_w$および既存の車輪正方向から導出する。符号は単輪正指令試験で確認し、解析式、Simscape Joint正方向、エンコーダー正方向を一致させる。

現行コードおよび実機CAD測定値では$\lambda=33$ degである（案B内向きモーター格納の成立限界）。LQIモデル生成は33 degの幾何に基づく。

## 7. LQI制御則

### 7.1 積分状態

速度追従誤差を、

$$
e_v=v_d^B-v_B^B
$$

とし、積分状態を、

$$
\dot\xi_v=e_v
$$

と定義する。ヨー角速度にも定常偏差除去が必要な場合は、

$$
\dot\xi_r=r_d-r
$$

を追加できる。ただしヨー積分はホイール摩擦差、ジャイロバイアス、飽和の影響を受けやすいため、初期構成では平面速度2積分のみとする。

拡大状態は、

$$
x_L=\begin{bmatrix}x_p^T&\xi_v^T\end{bmatrix}^T
$$

で、

$$
\dot x_L=
\underbrace{\begin{bmatrix}
A_p&0\\
-C_v&0
\end{bmatrix}}_{A_L}x_L
+
\underbrace{\begin{bmatrix}B_p\\0\end{bmatrix}}_{B_L}
\omega_{w,d}
+
\begin{bmatrix}0\\I_2\end{bmatrix}v_d^B
$$

となる。

### 7.2 評価関数と最適ゲイン

連続時間LQIでは、

$$
J=\int_0^\infty
\left(x_L^TQx_L+\omega_{w,d}^TR\omega_{w,d}\right)dt
$$

を最小にするゲインを求める。

$$
\omega_{w,d}^{raw}=-K_xx_p-K_i\xi_v+K_rr_d
$$

$Q\succeq0$、$R\succ0$とし、次を満たすことを確認する。

- $(A_p,B_p)$が可安定である。
- 積分出力を含む拡大系$(A_L,B_L)$が可安定である。
- 原点に不安定な不変零点がなく、指定した速度を積分制御できる。
- 閉ループ極が内側サーボ帯域へ過度に近づかない。

### 7.3 重みの選定

Bryson則を初期値として、許容最大値$x_{i,max}$、$u_{j,max}$から、

$$
Q_{ii}=\frac{1}{x_{i,max}^2},qquad
R_{jj}=\frac{1}{u_{j,max}^2}
$$

と置く。姿勢角と姿勢角速度の重みを速度より大きくし、速度追従より接触維持と直立を優先する。

| 状態 | 重み付け方針 |
|---|---|
| $\alpha_x,\alpha_y$ | 最大傾斜を小さく保つため大 |
| $\dot\alpha_x,\dot\alpha_y$ | 振動とオーバーシュート抑制のため中～大 |
| $v_x,v_y$ | 追従帯域を決める中程度 |
| $r$ | ヨー角速度応答に応じて中程度 |
| $\omega_w$ | 高速回転と電圧飽和を避けるため中程度 |
| $\xi_v$ | 定常偏差を除去できる範囲で徐々に増加 |
| $\omega_{w,d}$ | サーボ能力と接触摩擦を超えないよう設定 |

外側LQIの帯域は、内側速度ループ帯域の概ね1/3以下を初期目標とする。これは厳密な制約ではないが、二重ループ間の時間尺度を分離する実用的な出発点である。

## 8. 飽和とアンチワインドアップ

### 8.1 車輪速度指令制限

$$
\omega_{w,d}=\operatorname{sat}(\omega_{w,d}^{raw},\pm\omega_{w,max})
$$

とする。要素別飽和だけでは並進・ヨー方向が変わるため、可能なら3輪ベクトルを実現可能集合へ射影する。

$$
\omega_{w,d}
=\arg\min_{\omega\in\mathcal U}
\|W_u(\omega-\omega_{w,d}^{raw})\|_2^2
$$

$\mathcal U$には速度、加速度、推定電流、摩擦限界を含める。

### 8.2 外側LQI積分器

BALANCE中かつ制限前後の差が小さい場合だけ通常積分する。飽和時は、追跡型アンチワインドアップを用いる。

$$
\dot\xi_v=e_v+K_{aw,L}G_w^\dagger
(\omega_{w,d}-\omega_{w,d}^{raw})
$$

RECOVERY、FALLEN、DISABLEDでは$\xi_v=0$へリセットする。BALANCEへ再進入するときは、現在の出力と一致するよう積分状態を初期化するか、速度指令をランプ状に復帰させてバンプを防ぐ。

### 8.3 電流・摩擦制限との協調

電流制限はおおむねトルク制限に対応する。

$$
|\tau_w|\le\eta_gNK_tI_{max}
$$

さらに接触駆動力は、

$$
|\tau_{w,i}|\le \mu_dF_{n,w,i}R_w
$$

を満たす必要がある。電気的に発生可能なトルクが摩擦限界を超える場合は、速度追従よりすべり防止を優先する。

## 9. モード管理

既存モード境界を維持する。

$$
\theta_{tilt}=\sqrt{\phi^2+\theta^2}
$$

| モード | 条件 | LQI・サーボ動作 |
|---|---|---|
| BALANCE | `enable=1`、$\theta_{tilt}<18$ deg | LQI有効、速度積分有効 |
| RECOVERY | `enable=1`、$18\le\theta_{tilt}<35$ deg | 速度・ヨー指令0、姿勢回復制御、LQI積分リセット |
| FALLEN/DISABLED | `enable=0`または$\theta_{tilt}\ge35$ deg | 速度指令0、電圧0、積分リセット |

完全拘束モデルはBALANCEの設計にのみ用いる。大傾斜でRECOVERYへ入った場合、4接触仮定が崩れている可能性があるため、LQI出力を継続しない。

現在の判定にはモード境界のヒステリシスがない。実機化では、復帰側閾値を進入側より小さくし、最小滞留時間を設ける。

## 10. 可制御性と可観測性

### 10.1 LQI設計状態

IMUと車輪エンコーダーから、$\phi,\theta,p,q,r,\omega_w$を直接または推定できる。平面速度$v_B^W$はIMUと拘束運動学から推定する。

絶対位置$p_{B,xy}^W$と絶対ヨー$\psi$は、外部基準なしでは長期的に観測できない。そのため速度追従LQIの主要状態には含めない。

ボール絶対姿勢は球対称性のためバランス制御には不要である。ボール中心速度と角速度は、接触拘束の整合性確認およびログに使用する。

### 10.2 数値確認

線形化後に、

$$
\operatorname{rank}\mathcal C
=\operatorname{rank}
\begin{bmatrix}B_p&A_pB_p&\cdots&A_p^{n-1}B_p\end{bmatrix}
$$

を評価する。全状態可制御でなくても、非安定モードが可制御なら可安定である。PBH判定、

$$
\operatorname{rank}\begin{bmatrix}\lambda I-A_p&B_p\end{bmatrix}=n
$$

を$\operatorname{Re}(\lambda)\ge0$の固有値に対して確認する。

## 11. 設計モデルと検証モデルの役割分担

| 項目 | LQI設計モデル | Simscape検証モデル |
|---|---|---|
| 接触 | 完全拘束 | 有限剛性、減衰、摩擦、分離 |
| 接触変形状態 | なし | 物理ネットワーク内部に存在 |
| サーボ | 同定した閉ループ低次モデル | 電圧、電流、逆起電力、慣性、減速機 |
| 入力 | 車輪速度指令$\omega_{w,d}$ | 等価電圧$v_a$ |
| 用途 | LQIゲイン計算、極・可制御性解析 | 飽和、すべり、接触分離、電源評価 |
| 数値特性 | 低次、非剛性 | 高次、接触により剛性あり |

両モデルを一致させる対象は、低周波の車輪速度応答、直立近傍の姿勢応答、平面速度応答である。接触固有振動そのものを設計モデルへ一致させる必要はない。

## 12. 設計および検証手順

### 12.1 パラメーター同定

1. 車輪を無負荷で駆動し、電圧―定常速度、デッドバンド、時定数を測定する。
2. 拘束または既知負荷で電流―トルク特性を測定する。
3. $R_a,L_a,K_t,K_e,N,J_{eq},b_{eq}$または等価伝達関数を同定する。
4. 組立CADまたは実測からローバー重心と慣性テンソルを確定する。
5. 接触緯度と各車輪軸方向をCADおよび単輪試験で確定する。

### 12.2 LQI設計

1. 直立静止の整合平衡点を求める。
2. 4接触ヤコビアンから零空間基底$N$を求める。
3. 接触反力を消去した縮約モデルを生成する。
4. 内側速度ループを閉じ、$\omega_{w,d}\rightarrow\omega_w$の低次モデルを得る。
5. 10状態MIMOモデルを線形化する。
6. 可安定性と積分可能性を確認する。
7. Bryson則から$Q,R$を初期化し、LQIゲインを計算する。
8. 速度、電圧、電流、摩擦限界を考慮して重みと指令制限を調整する。

### 12.3 検証

| 段階 | 試験 | 主な合格条件 |
|---|---|---|
| サーボ単体 | 速度ステップ、負荷ステップ、逆転 | 実測時定数・定常速度・電流と一致 |
| 縮約モデル | 初期傾斜、速度ステップ | 安定、指定帯域、飽和なし |
| 詳細開ループ | 単輪電圧、3輪共通・差動電圧 | 符号、電流、車輪速度、接触反力が妥当 |
| 詳細閉ループ | 静止直立、$x/y$速度、ヨー速度 | 追従、姿勢、電圧、電流が制限内 |
| ロバスト性 | 質量・重心・摩擦・電圧変動 | 4接触維持、転倒なし、性能劣化が許容内 |
| モード遷移 | BALANCE↔RECOVERY、FALLEN | バンプなし、積分器リセット、電圧安全化 |

数値ロバスト性として、Simscapeのソルバー刻みと接触剛性を変化させ、低周波閉ループ応答が大きく変わらないことを確認する。

## 13. 必要パラメーター

### 13.1 既存パラメーター

| 記号 | 公称値 | 単位 | 対応 |
|---|---:|---|---|
| $R_b$ | 0.050 | m | `p.ball.radius` |
| $m_b$ | 0.285 | kg | `p.ball.mass` |
| $I_b$ | $4.75\times10^{-4}I_3$ | kg m$^2$ | `p.ball.inertia` |
| $R_w$ | 0.024 | m | `p.wheel.radius` |
| $m_w$ | 0.039 | kg/輪 | `p.wheel.mass` |
| $m_R$ | 1.179 | kg | 基礎ローバーと上部ロッドの合計（Fusion実測反映後）、`p.rover.mass` |
| $m_p$ | 0.500 | kg | 上部ロッド、`p.fullplant.payload.mass` |
| $h_B$ | 0.125 | m | 機体原点の幾何高さ |
| $h_{COM}$ | 0.1074 | m | ローバー合成重心高（Fusion実測反映後）、`p.rover.centerAboveBall` |
| $V_{dc}$ | 6.0 | V | `p.driver.supplyVoltage` |
| $\tau_{stall}$ | 約0.981 | N m | `p.motor.stallTorque` |
| $\tau_{continuous}$ | 約0.919 | N m | `p.driver.continuousTorqueLimit` |
| $\omega_{w,max}$ | 約21.99 | rad/s | `p.motor.noLoadSpeed` |
| $\tau_s$ | 0.030 | s | `p.motor.timeConstant`、暫定 |

### 13.2 追加または同定が必要なパラメーター

| パラメーター | 単位 | 用途 |
|---|---|---|
| $R_a,L_a$ | $\Omega$, H | 電機子電気応答 |
| $K_t,K_e$ | N m/A, V/(rad/s) | 電気―機械変換 |
| $J_m,b_m$ | kg m$^2$, N m/(rad/s) | モーター軸運動 |
| $N,\eta_g,J_g$ | -, -, kg m$^2$ | 減速機 |
| $J_w$ | kg m$^2$ | 車輪回転慣性 |
| $I_{max},I_0,I_{stall}$ | A | 電流制限と同定 |
| $R_{bat}$ | $\Omega$ | 3輪同時駆動時の電圧降下 |
| PWM中立点・デッドバンド・最大デューティ | μsまたは- | 実サーボ入力特性 |
| $K_{p\omega},K_{i\omega},K_{aw,\omega}$ | 適合単位 | 内側速度制御 |
| $I_B,r_{G_B/B}$ | kg m$^2$, m | 縮約機体運動 |
| $r_{F_i/B}$、軸方向 | m, - | 接触ヤコビアン |

推測値で電気パラメーターを埋めると、LQIが存在しない帯域やトルク余裕を利用する可能性がある。少なくとも無負荷速度応答、ストール電流、負荷時速度の測定後にゲインを確定する。

## 14. 現行実装との対応

本書の目標構成は正本モデル`ball_balancing_omni3_multibody_lqi_custom_contact_fullplant.slx`へ実装済みである。

- LQI設計モデルはサーボ速度状態を含む10状態MIMOで、`ballbotDesignLqi.m`が縮約プラントからゲインを設計する。
- LQI出力は3輪速度指令$\omega_{w,d}$とし、`ballbotLqiControllerUpdate`が生成する。
- 内側速度制御は`ballbotSpeedPiMotorStep`→`ballbotMdd3aVoltageController`の輪速PIで、電流・逆起電力・粘性摩擦・電圧・電流制限はMATLAB関数内の解析的DCモータモデルで表現する。Simscape Electricalプラントへの置き換えは実機詳細化の拡張余地として残す。
- 接触力はLQI設計時に拘束消去し、詳細モデル上で法線荷重と摩擦限界を検証する方針を維持する。

正本構成では `p.controller.fullplant.enabled=true` として、`ballbotFullPlantHierarchyUpdate.m` の階層制御（速度外側ループ＋傾斜安定化＋輪速変換）を適用する。10状態LQIは `enabled=false` 時の代替パスとして残り、両者は同一の輪速指令インターフェースを共有する。信号単位、車輪正方向、サンプル時間、飽和処理は[制御・状態推定理論](ball_balancing_omnirover3wd-control-estimation-theory.md) §6 に固定済みである。

## 15. 関連文書

- [状態方程式](ball_balancing_omnirover3wd-state-equations.md)
- [制御・状態推定理論](ball_balancing_omnirover3wd-control-estimation-theory.md)
- [制御・推定アーキテクチャ](ball_balancing_omnirover3wd-architecture.md)
- [システム仕様](ball_balancing_omnirover3wd-system.md)
