nenecchiCV/ball-balancing-omni-rover/specs/hardware_design/mechanism/omnirover3wd_reference/servo_16007/mg996r_like_16007_iso_20260902T153214Z.png

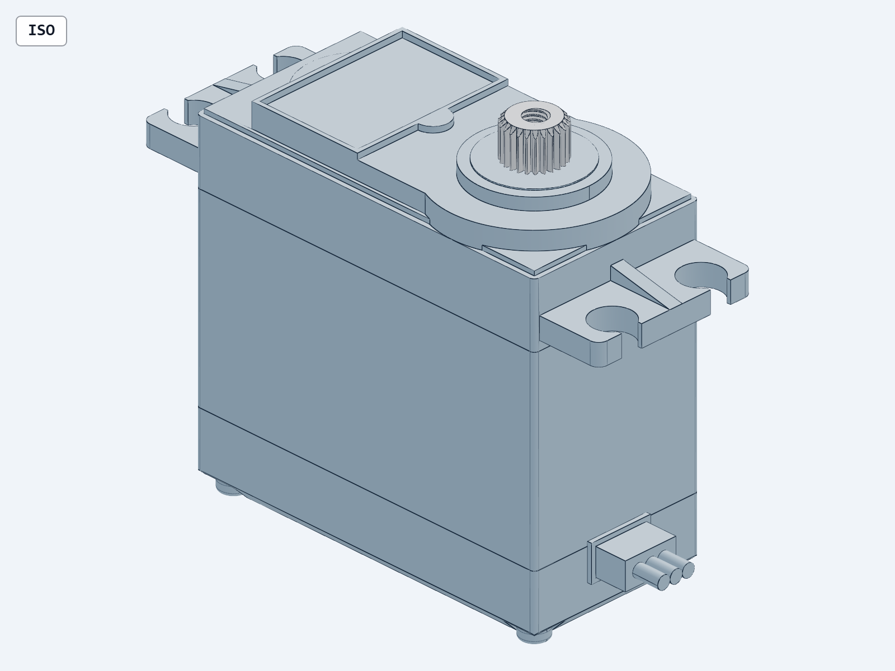
specs/hardware_design/mechanism/omnirover3wd_reference/servo_16007/mg996r_like_16007_iso_20260902T153214Z.png
