nenecchiCV/ball-balancing-omni-rover/specs/hardware_design/mechanism/omnirover3wd_reference/system/vstone_example_data/omniWheel_parts_list/parts_list.pdf

truck_type_robot_parts_list
Name | shopid | URL
M3ネジL5 | 05507162 | https://www.monotaro.com/p/0550/7162/
M3ネジL8 | 05507187 | https://www.monotaro.com/p/0550/7187/
M3ナット | 05529167 | https://www.monotaro.com/p/0552/9167/
M3樹脂スペーサーL60 | AS-360 | http://hirosugi.co.jp/products/POM/AR.html
M3樹脂スペーサーL17 | AS-317 | http://hirosugi.co.jp/products/POM/AR.html
M3金属スペーサーL5 | BSB-305E | http://hirosugi.co.jp/products/B/BSB-E.html
LEGO(レゴ)用48mmオムニホイール | | https://www.vstone.co.jp/robotshop/index.php?main_page=product_info&cPath=71_894_897&products_id=3771
メタルギアサーボモータ | | https://www.vstone.co.jp/robotshop/index.php?main_page=product_info&cPath=71_894_896&products_id=3825
Octopusアナログフォトセルブリック | | https://www.vstone.co.jp/robotshop/index.php?main_page=product_info&products_id=4344
OctopusLEDライトブリック(青) | | https://www.vstone.co.jp/robotshop/index.php?main_page=product_info&cPath=71_270_367_370&products_id=4356
Octopus雨／蒸気センサ | | https://www.vstone.co.jp/robotshop/index.php?main_page=product_info&cPath=71_270_367_370&products_id=4338
ドーム-コケリウム　S アップル | | http://ymall.jp/store/jaclife/e377280909a00001/?q=moss-connect
