nenecchiCV/ball-balancing-omni-rover/specs/hardware_design/mechanism/ball_balancing_omnirover3wd/cad/ball_balancing_omnirover3wd_assembly.step

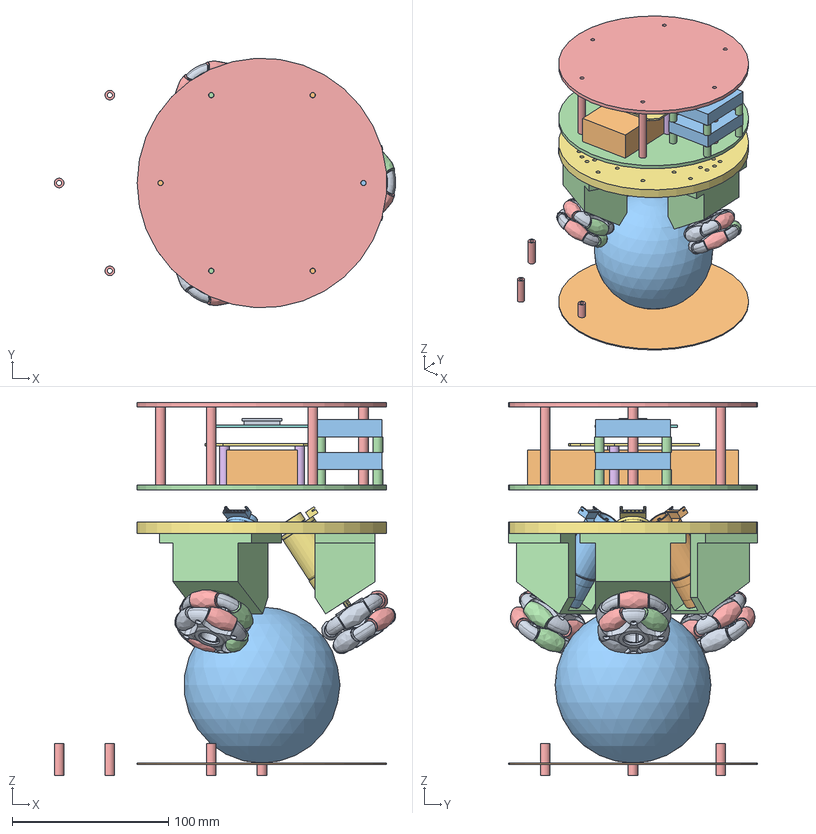
[picture p3: CAD file, 2026-10-28]
specs/hardware_design/mechanism/ball_balancing_omnirover3wd/cad/ball_balancing_omnirover3wd_assembly.step
218.8 x 159.8 x 239.0 mm
