nenecchiCV/ball-balancing-omni-rover/specs/hardware_design/mechanism/ball_balancing_omnirover3wd/cad/parts/Spacer_M3x20p5.step

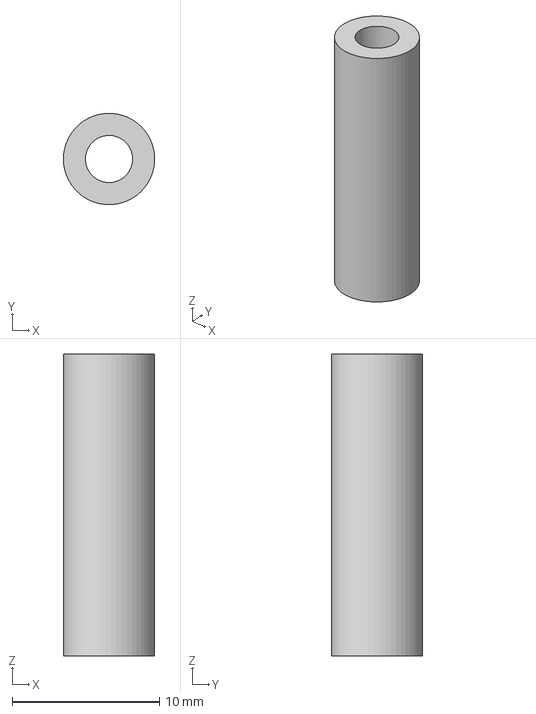
[picture p4: CAD file, 2026-10-28]
specs/hardware_design/mechanism/ball_balancing_omnirover3wd/cad/parts/Spacer_M3x20p5.step
6.19 x 6.20 x 20.5 mm
