nenecchiCV/ball-balancing-omni-rover/specs/hardware_design/mechanism/omnirover3wd_reference/omniwheel_14108/48MM-OMNI-WHEEL-for-NXT-and-servo-motor 14108/48MM-OMNI-WHEEL-for-NXT-and-servo-motor.stp

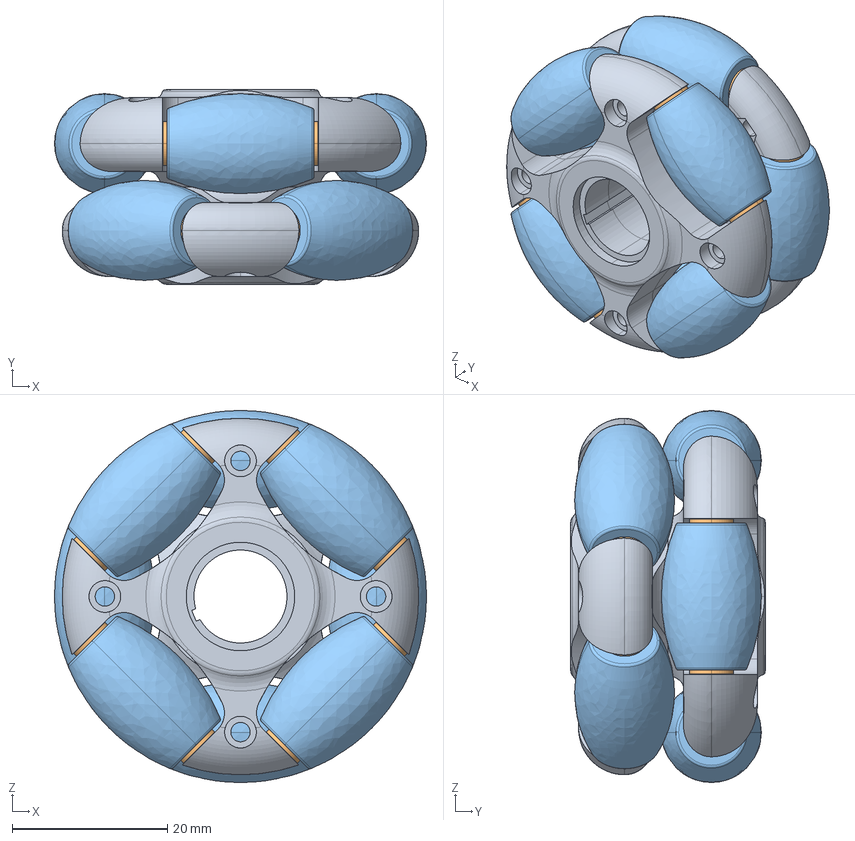
[picture p5: CAD file, 2026-08-31]
specs/hardware_design/mechanism/omnirover3wd_reference/omniwheel_14108/48MM-OMNI-WHEEL-for-NXT-and-servo-motor 14108/48MM-OMNI-WHEEL-for-NXT-and-servo-motor.stp
48.0 x 25.1 x 48.0 mm
G3
G8
X1-1 x 4
X2-1 x 4
X1-4
X1-5
X1-6
X1-7
G9_5 x 4
G8_1
G3_1
G11
X2-3 x 4
G9-7 x 4
