nenecchiCV/ball-balancing-omni-rover/specs/hardware_design/mechanism/omnirover3wd_reference/servo_16007/mg996r_like_16007.step

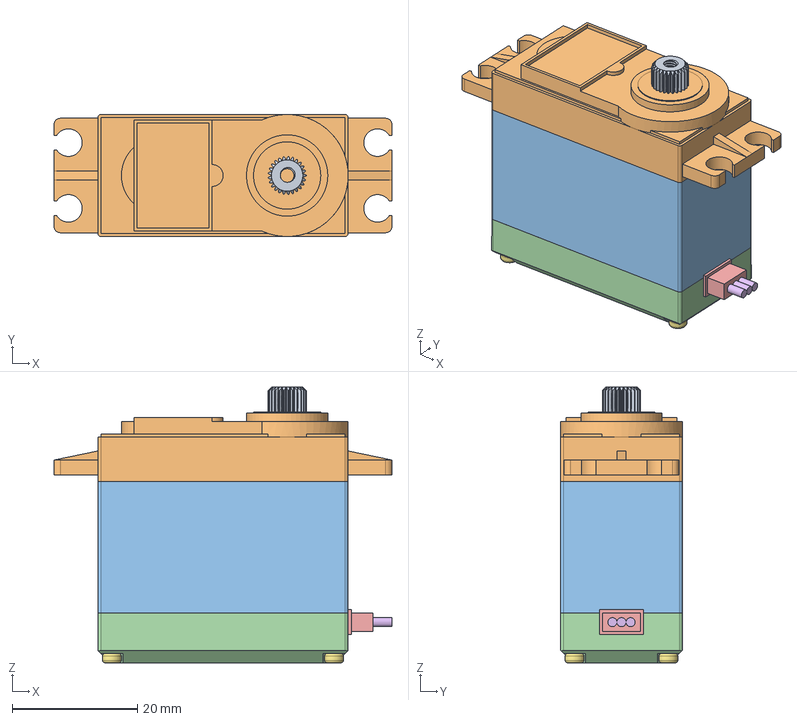
[picture p6: CAD file, 2026-09-03]
specs/hardware_design/mechanism/omnirover3wd_reference/servo_16007/mg996r_like_16007.step
54.0 x 19.5 x 44.0 mm
