nenecchiCV/ball-balancing-omni-rover/specs/hardware_design/mechanism/omnirover3wd_reference/system/vstone_example_data/omniWheel_parts_list/omniWheel_step/part01.step

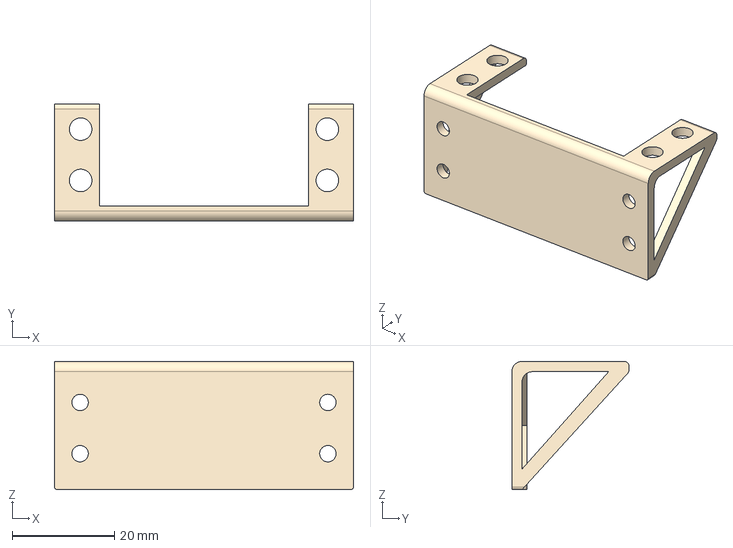
[picture p7: CAD file, 2026-08-31]
specs/hardware_design/mechanism/omnirover3wd_reference/system/vstone_example_data/omniWheel_parts_list/omniWheel_step/part01.step
58.4 x 22.9 x 25.0 mm
