nenecchiCV/ball-balancing-omni-rover/tools/cad/hub.stl

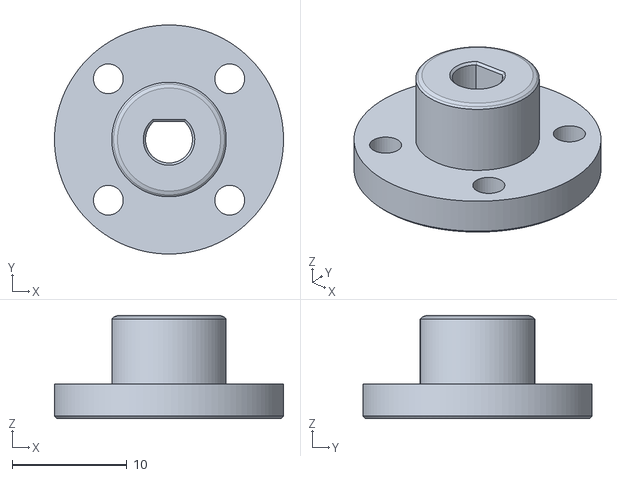
[picture p8: CAD file, 2026-10-27]
tools/cad/hub.stl
20.0 x 20.0 x 9.00
