nenecchiCV/ball-balancing-omni-rover/specs/hardware_design/mechanism/ball_balancing_omnirover3wd/cad/MotorMount_v12.step

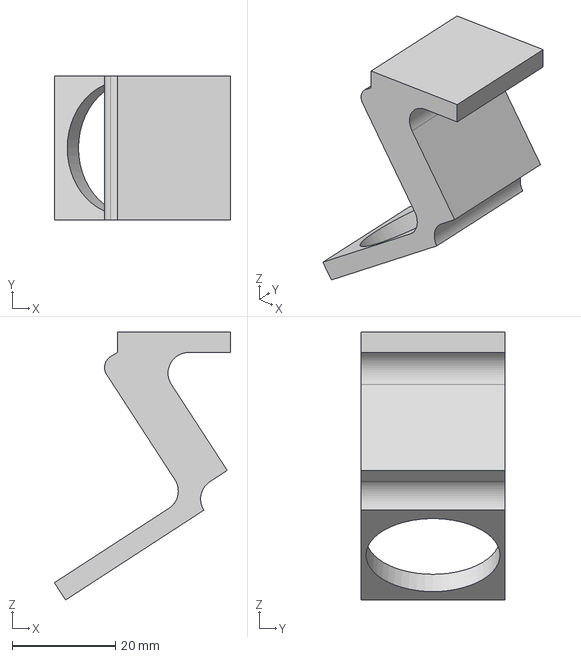
[picture p9: CAD file, 2026-10-18]
specs/hardware_design/mechanism/ball_balancing_omnirover3wd/cad/MotorMount_v12.step
34.2 x 28.0 x 52.0 mm
