nenecchiCV/ball-balancing-omni-rover/specs/hardware_design/mechanism/ball_balancing_omnirover3wd/cad/parts/Frame_L1.step

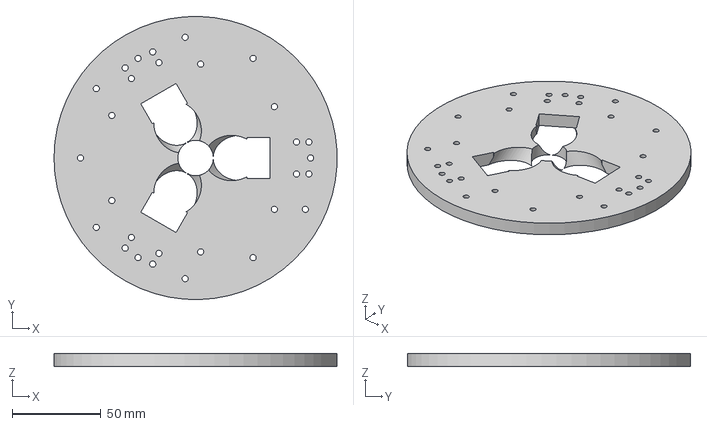
[picture p10: CAD file, 2026-10-28]
specs/hardware_design/mechanism/ball_balancing_omnirover3wd/cad/parts/Frame_L1.step
159.9 x 159.9 x 7.50 mm
