nenecchiCV/ball-balancing-omni-rover/specs/hardware_design/mechanism/omnirover3wd_reference/servo_16007/MotorMount_C.stl

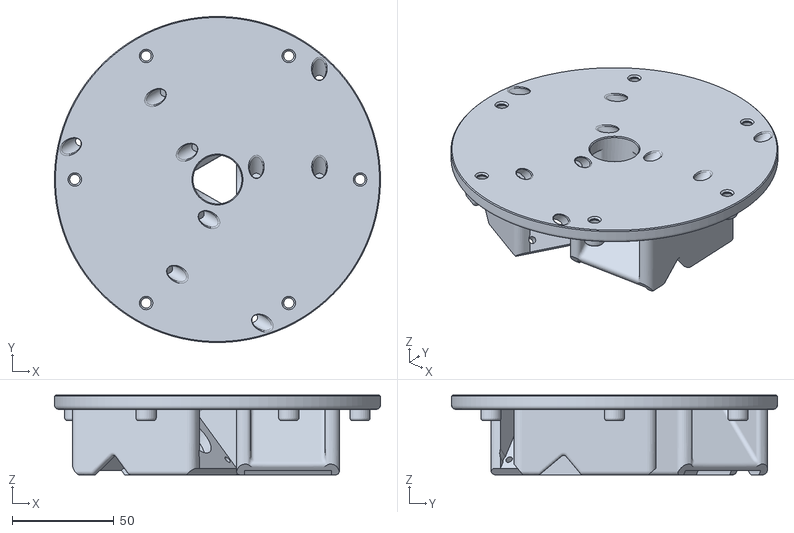
[picture p11: CAD file, 2026-09-03]
specs/hardware_design/mechanism/omnirover3wd_reference/servo_16007/MotorMount_C.stl
160.0 x 160.0 x 39.2
