nenecchiCV/ball-balancing-omni-rover/specs/hardware_design/mechanism/omnirover3wd_reference/system/vstone_example_data/omniWheel_parts_list/omniWheel_step/part02.step

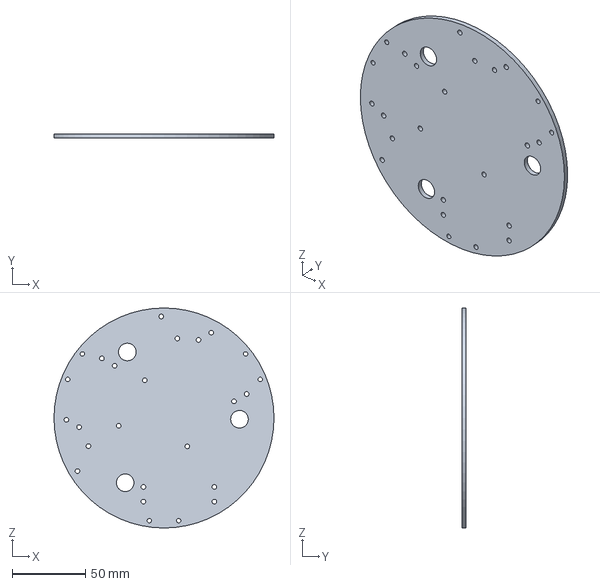
[picture p12: CAD file, 2026-08-31]
specs/hardware_design/mechanism/omnirover3wd_reference/system/vstone_example_data/omniWheel_parts_list/omniWheel_step/part02.step
150.0 x 3.00 x 150.0 mm
