nenecchiCV/ball-balancing-omni-rover/specs/hardware_design/mechanism/ball_balancing_omnirover3wd/cad/parts/Frame_L2.step

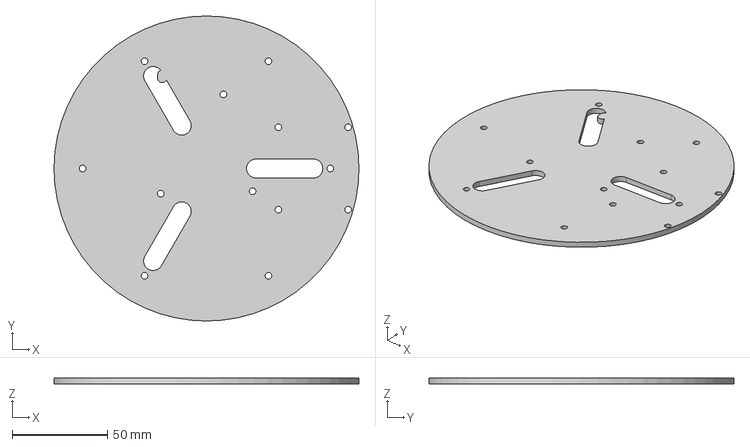
[picture p13: CAD file, 2026-10-25]
specs/hardware_design/mechanism/ball_balancing_omnirover3wd/cad/parts/Frame_L2.step
160.0 x 160.0 x 3.00 mm
