nenecchiCV/ball-balancing-omni-rover/specs/hardware_design/mechanism/ball_balancing_omnirover3wd/cad/parts/Nucleo64_G474.stl

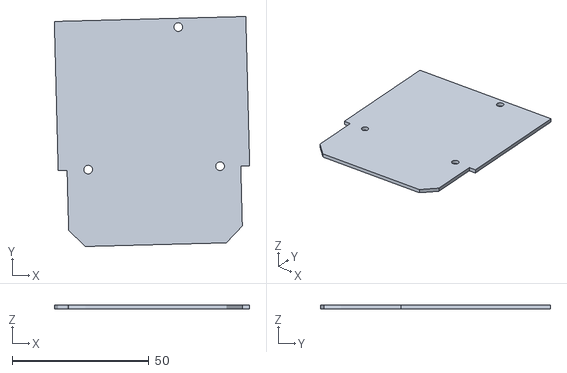
[picture p15: CAD file, 2026-10-22]
specs/hardware_design/mechanism/ball_balancing_omnirover3wd/cad/parts/Nucleo64_G474.stl
71.4 x 84.0 x 1.60
