nenecchiCV/ball-balancing-omni-rover/specs/hardware_design/mechanism/ball_balancing_omnirover3wd/cad/fit0521_motor_mount_bracket.step

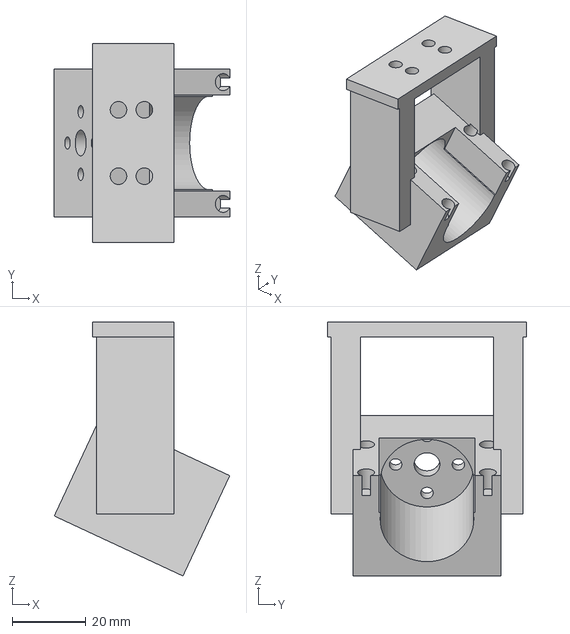
[picture p16: CAD file, 2026-09-21]
specs/hardware_design/mechanism/ball_balancing_omnirover3wd/cad/fit0521_motor_mount_bracket.step
47.6 x 54.0 x 68.8 mm
