nenecchiCV/ball-balancing-omni-rover/specs/hardware_design/mechanism/ball_balancing_omnirover3wd/cad/parts/Frame_L3.step

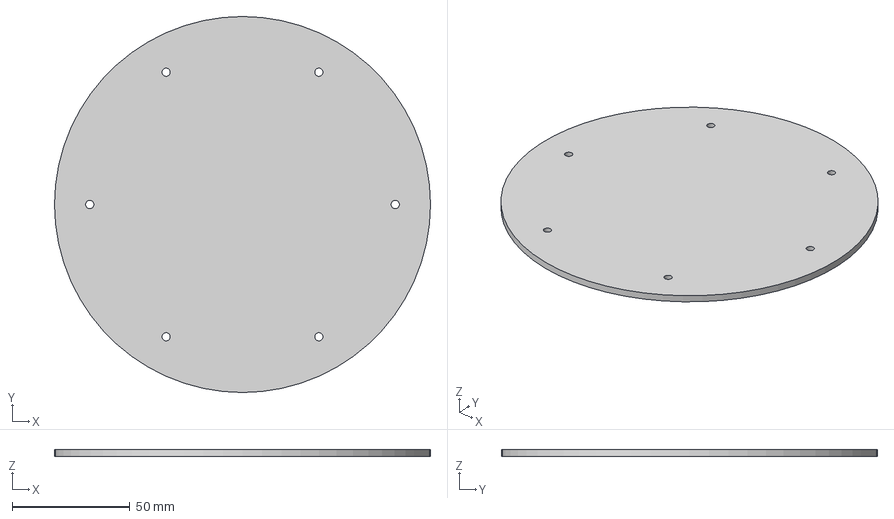
[picture p17: CAD file, 2026-10-22]
specs/hardware_design/mechanism/ball_balancing_omnirover3wd/cad/parts/Frame_L3.step
160.0 x 160.0 x 3.00 mm
