nenecchiCV/ball-balancing-omni-rover/specs/hardware_design/mechanism/ball_balancing_omnirover3wd/cad/fit0521_motor_clamp_strap.step

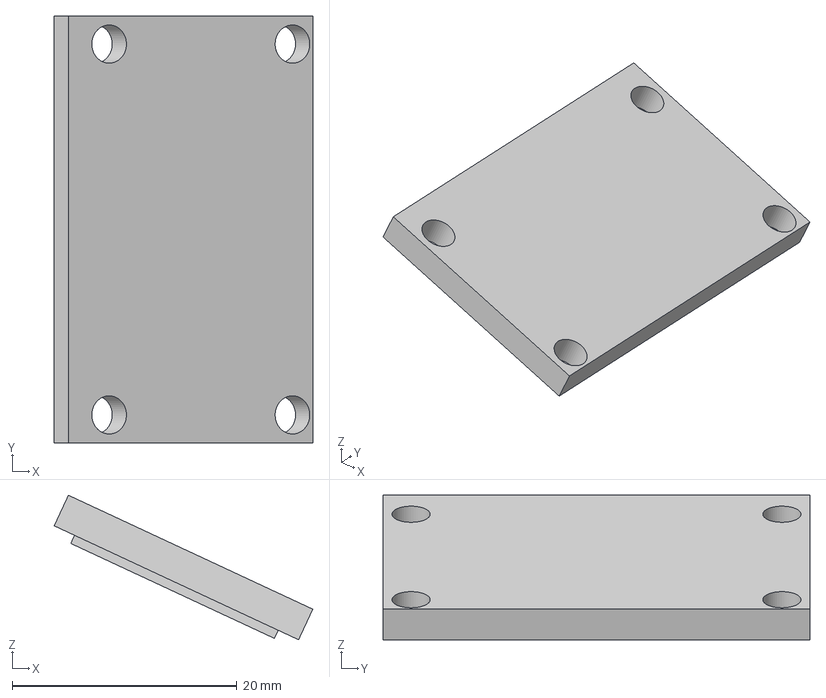
[picture p18: CAD file, 2026-09-21]
specs/hardware_design/mechanism/ball_balancing_omnirover3wd/cad/fit0521_motor_clamp_strap.step
23.0 x 38.0 x 12.9 mm
