nenecchiCV/ball-balancing-omni-rover/specs/hardware_design/mechanism/ball_balancing_omnirover3wd/cad/parts/Spacer_M3x50.step

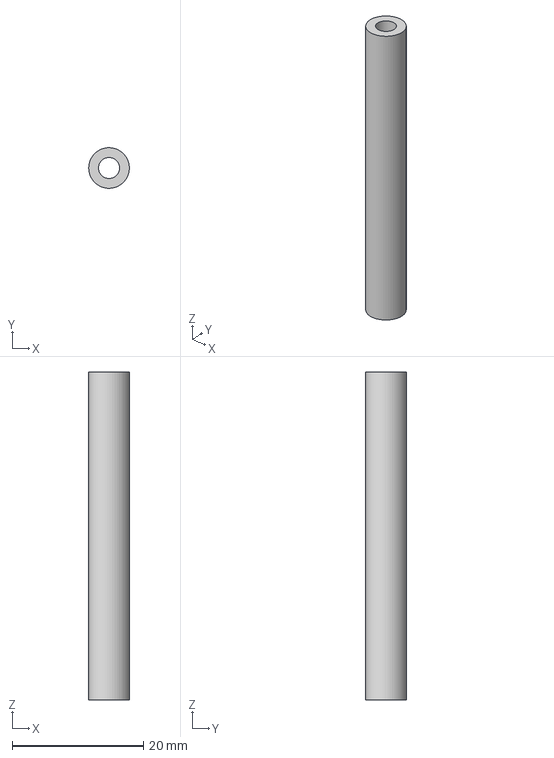
[picture p19: CAD file, 2026-10-18]
specs/hardware_design/mechanism/ball_balancing_omnirover3wd/cad/parts/Spacer_M3x50.step
6.19 x 6.20 x 50.0 mm
