nenecchiCV/ball-balancing-omni-rover/specs/hardware_design/mechanism/ball_balancing_omnirover3wd/cad/parts/MotorMount_v23.step

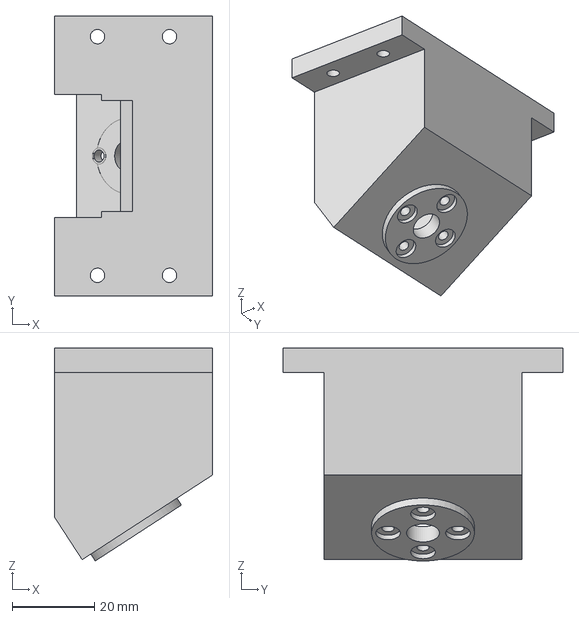
[picture p20: CAD file, 2026-10-18]
specs/hardware_design/mechanism/ball_balancing_omnirover3wd/cad/parts/MotorMount_v23.step
38.5 x 68.0 x 51.8 mm
