nenecchiCV/ball-balancing-omni-rover/specs/hardware_design/mechanism/ball_balancing_omnirover3wd/cad/parts/WheelAdapter_v4.step

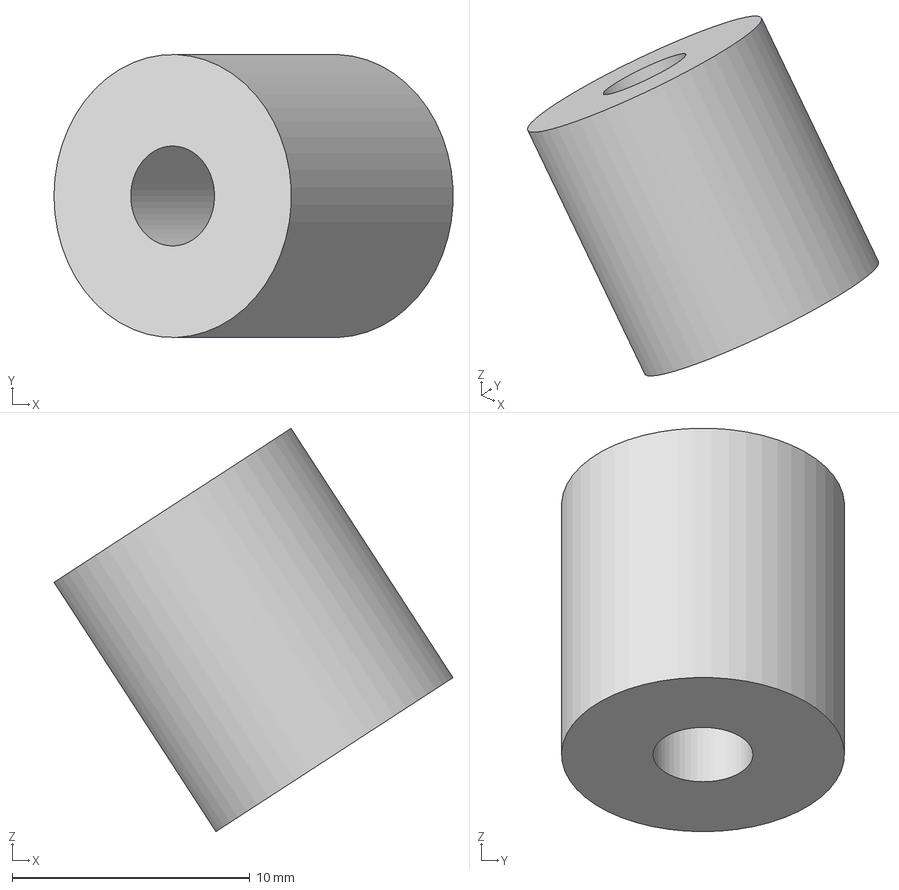
[picture p21: CAD file, 2026-10-18]
specs/hardware_design/mechanism/ball_balancing_omnirover3wd/cad/parts/WheelAdapter_v4.step
16.8 x 11.9 x 17.0 mm
