nenecchiCV/ball-balancing-omni-rover/specs/hardware_design/mechanism/ball_balancing_omnirover3wd/cad/parts/FIT0521.step

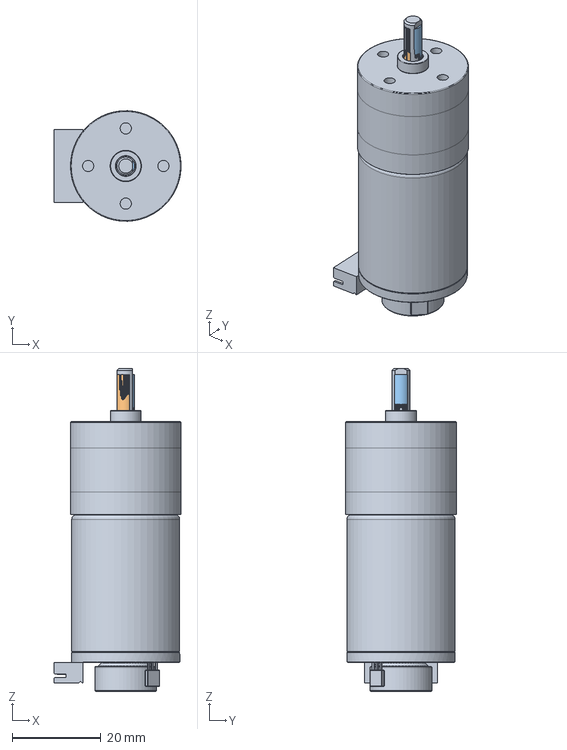
[picture p22: CAD file, 2026-09-21]
specs/hardware_design/mechanism/ball_balancing_omnirover3wd/cad/parts/FIT0521.step
28.7 x 25.0 x 73.0 mm
