nenecchiCV/ball-balancing-omni-rover/specs/hardware_design/mechanism/ball_balancing_omnirover3wd/cad/parts/Ground_ref.step

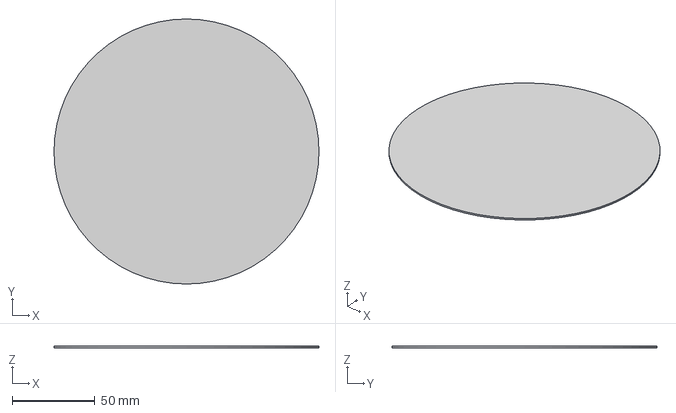
[picture p23: CAD file, 2026-09-21]
specs/hardware_design/mechanism/ball_balancing_omnirover3wd/cad/parts/Ground_ref.step
160.0 x 160.0 x 1.00 mm
