nenecchiCV/ball-balancing-omni-rover/specs/hardware_design/mechanism/ball_balancing_omnirover3wd/cad/parts/Ball_100.step

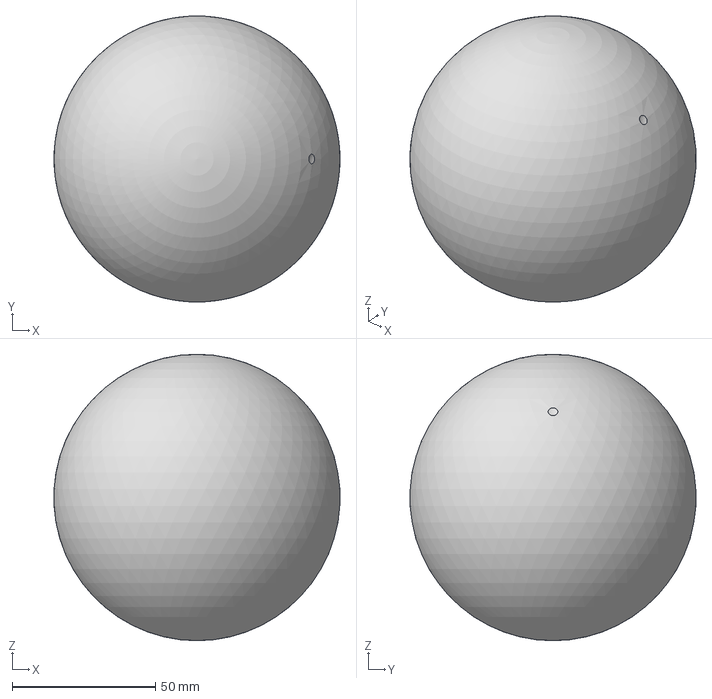
[picture p24: CAD file, 2026-09-21]
specs/hardware_design/mechanism/ball_balancing_omnirover3wd/cad/parts/Ball_100.step
99.8 x 99.8 x 100.0 mm
