nenecchiCV/ball-balancing-omni-rover/specs/hardware_design/mechanism/ball_balancing_omnirover3wd/cad/parts/Spacer_M4x50.step

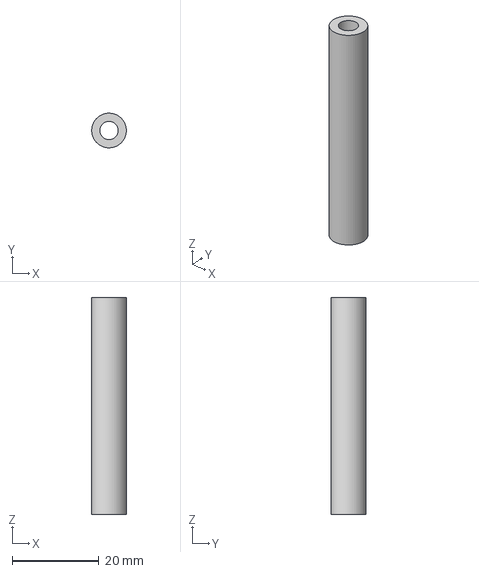
[picture p25: CAD file, 2026-09-21]
specs/hardware_design/mechanism/ball_balancing_omnirover3wd/cad/parts/Spacer_M4x50.step
7.99 x 8.00 x 50.0 mm
