nenecchiCV/ball-balancing-omni-rover/(list of files, cad)

Other CAD files:
specs/hardware_design/mechanism/ball_balancing_omnirover3wd/cad/parts/MotorClampStrap_v1.step
specs/hardware_design/mechanism/ball_balancing_omnirover3wd/cad/parts/omniwheel_14108.step
specs/hardware_design/mechanism/ball_balancing_omnirover3wd/cad/FIT0521.f3d
specs/hardware_design/mechanism/ball_balancing_omnirover3wd/cad/MotorMount_v10.step
specs/hardware_design/mechanism/ball_balancing_omnirover3wd/cad/MotorMount_v10.stl
specs/hardware_design/mechanism/ball_balancing_omnirover3wd/cad/MotorMount_v11.step
specs/hardware_design/mechanism/ball_balancing_omnirover3wd/cad/MotorMount_v11.stl
specs/hardware_design/mechanism/ball_balancing_omnirover3wd/cad/MotorMount_v12.stl
specs/hardware_design/mechanism/ball_balancing_omnirover3wd/cad/_XRef_/FIT0521.f3d
specs/hardware_design/mechanism/ball_balancing_omnirover3wd/cad/ball_balancing_omnirover3wd_assembly.f3d
specs/hardware_design/mechanism/ball_balancing_omnirover3wd/cad/ball_balancing_omnirover3wd_assembly.stl
specs/hardware_design/mechanism/ball_balancing_omnirover3wd/cad/fit0521_motor_clamp_strap.stl
specs/hardware_design/mechanism/ball_balancing_omnirover3wd/cad/parts/Ball_100.stl
specs/hardware_design/mechanism/ball_balancing_omnirover3wd/cad/parts/FIT0521.stl
specs/hardware_design/mechanism/ball_balancing_omnirover3wd/cad/parts/Frame_L1.stl
specs/hardware_design/mechanism/ball_balancing_omnirover3wd/cad/parts/Frame_L2.stl
specs/hardware_design/mechanism/ball_balancing_omnirover3wd/cad/parts/Frame_L3.stl
specs/hardware_design/mechanism/ball_balancing_omnirover3wd/cad/parts/Ground_ref.stl
specs/hardware_design/mechanism/ball_balancing_omnirover3wd/cad/parts/MotorClampStrap_v1.stl
specs/hardware_design/mechanism/ball_balancing_omnirover3wd/cad/parts/MotorMount_v13.step
specs/hardware_design/mechanism/ball_balancing_omnirover3wd/cad/parts/MotorMount_v13.stl
specs/hardware_design/mechanism/ball_balancing_omnirover3wd/cad/parts/MotorMount_v14.step
specs/hardware_design/mechanism/ball_balancing_omnirover3wd/cad/parts/MotorMount_v14.stl
specs/hardware_design/mechanism/ball_balancing_omnirover3wd/cad/parts/MotorMount_v17.step
specs/hardware_design/mechanism/ball_balancing_omnirover3wd/cad/parts/MotorMount_v17.stl
specs/hardware_design/mechanism/ball_balancing_omnirover3wd/cad/parts/MotorMount_v18.step
specs/hardware_design/mechanism/ball_balancing_omnirover3wd/cad/parts/MotorMount_v18.stl
specs/hardware_design/mechanism/ball_balancing_omnirover3wd/cad/parts/MotorMount_v20.step
specs/hardware_design/mechanism/ball_balancing_omnirover3wd/cad/parts/MotorMount_v20.stl
specs/hardware_design/mechanism/ball_balancing_omnirover3wd/cad/parts/MotorMount_v21.step
specs/hardware_design/mechanism/ball_balancing_omnirover3wd/cad/parts/MotorMount_v21.stl
specs/hardware_design/mechanism/ball_balancing_omnirover3wd/cad/parts/MotorMount_v22.step
specs/hardware_design/mechanism/ball_balancing_omnirover3wd/cad/parts/MotorMount_v22.stl
specs/hardware_design/mechanism/ball_balancing_omnirover3wd/cad/parts/MotorMount_v23.stl
specs/hardware_design/mechanism/ball_balancing_omnirover3wd/cad/parts/MotorMount_v4.step
specs/hardware_design/mechanism/ball_balancing_omnirover3wd/cad/parts/MotorMount_v4.stl
specs/hardware_design/mechanism/ball_balancing_omnirover3wd/cad/parts/MotorMount_v5.step
specs/hardware_design/mechanism/ball_balancing_omnirover3wd/cad/parts/MotorMount_v5.stl
specs/hardware_design/mechanism/ball_balancing_omnirover3wd/cad/parts/MotorMount_v6.step
specs/hardware_design/mechanism/ball_balancing_omnirover3wd/cad/parts/MotorMount_v6.stl
specs/hardware_design/mechanism/ball_balancing_omnirover3wd/cad/parts/MotorMount_v7.step
specs/hardware_design/mechanism/ball_balancing_omnirover3wd/cad/parts/MotorMount_v7.stl
specs/hardware_design/mechanism/ball_balancing_omnirover3wd/cad/parts/MotorMount_v9.step
specs/hardware_design/mechanism/ball_balancing_omnirover3wd/cad/parts/MotorMount_v9.stl
specs/hardware_design/mechanism/ball_balancing_omnirover3wd/cad/parts/Spacer_M3x50.stl
specs/hardware_design/mechanism/ball_balancing_omnirover3wd/cad/parts/Spacer_M4x50.stl
specs/hardware_design/mechanism/ball_balancing_omnirover3wd/cad/parts/WheelAdapter_v3.step
specs/hardware_design/mechanism/ball_balancing_omnirover3wd/cad/parts/WheelAdapter_v3.stl
specs/hardware_design/mechanism/ball_balancing_omnirover3wd/cad/parts/WheelAdapter_v4.stl
specs/hardware_design/mechanism/ball_balancing_omnirover3wd/cad/parts/omniwheel_14108.stl
