nenecchiCV/ball-balancing-omni-rover/specs/hardware_design/electronics/wiring_specification.md

# 配線仕様書

作成日: 2026-10-24

玉乗り3WDオムニローバーの電源・信号配線の仕様をまとめる。対象構成: Zeee 7.2 V NiMH バッテリー、Cytron MDD3A ×2、NUCLEO-G474RE、X-NUCLEO-IKS01A3/IMU、FIT0521 モータ×3(エンコーダー付き)。

## 電源ツリー

| 系統 | 供給元 | 供給先 | 電圧・容量 | 配線 |
|---|---|---|---|---|
| モーター電源 | バッテリー(TAMIYAプラグ) | MDD3A ×2 の VB+/VB−(各基板へ分岐) | 7.2 V・各ch 3 A連続/5 Aピーク | AWG20 以上・短く太く |
| ロジック 5 V | MDD3A-A の 5VO ピン | Nucleo 5V(E5V)入力 | 5 V・最大 200 mA | AWG24 以上 |
| ロジック 3.3 V | Nucleo 3V3 出力 | エンコーダー×3 電源、I2C プルアップ | 3.3 V | AWG24 以上 |
| 信号 GND/電源 GND | バッテリー(−) | 全機共通(後述) | — | — |

## 5 V 給電ルール

- **5V は MDD3A 1台の 5VO のみから供給する**。MDD3A-A の 5VO を Nucleo の 5V ピン(E5V)へ接続し、MDD3A-B の 5VO ピンは未接続とする。
- **2台の 5VO 出力を互いに接続しない**。5VO は各基板内蔵の独立バックブーストレギュレータ出力であり、出力を直結すると電圧差による環流・電流集中でレギュレータを損傷する。
- Nucleo 側の給電選択は E5V とする。E5V 給電時は ST-LINK 部に給電されないため、デバッグは USB 給電時(U5V)との使い分けとする。
- **容量管理**: 5VO の上限は 200 mA。Nucleo ターゲット部 + IKS01A3 系シールド + IMU の実効消費は実機で計測し、200 mA に近い場合はバッテリーから独立した 5 V レギュレータ(BEC)を追加して MD の 5VO は使わない構成へ切り替える。
- エンコーダーは 3.3 V 給電とし(5V 系からは取らない)、Nucleo 入力へ 5 V 信号を加えない構成を維持する。

## GND ルール

- バッテリー(−)、MDD3A ×2 の GND、Nucleo GND、IMU GND、エンコーダー GND は**すべて共通接続**する(信号基準の統一)。
- モーター電力線(VB/モーター出力)の GND リターン経路と IMU・エンコーダーの信号線は物理的に分離して引き回し、交差は最短に抑える。
- MDD3A の信号系 GND ピンは Nucleo GND へ接続し、MDD3A-A/B 間の GND もバッテリー(−)経由で共通化される。

## モーター・チャネル割当と配線経路

| MD基板 | 基板位置(機体座標) | 担当 | モーター線の引き込み経路 |
|---|---|---|---|
| MDD3A-A（下層） | 中心 (56, 0) mm、z=188–199（L2上面・M3×10スペーサ上） | M1 = P0 モーター | L2 配線スロット 0°方向(x=26–56, y±5)から直上 |
| MDD3A-B（上層） | 中心 (56, 0) mm、z=209–220（MD-A直上・M3×10スペーサ上、L3下面まで8 mm） | M1 = P1、M2 = P2 モーター | スロット 120°/240°から上面へ引き上げ、基板端子へ |

- 2枚は右側ストリップ(x≈35–77, y=±24)の同一4柱に2層積み。モーター線はバッテリー包絡(|x|<22.8, z≤200.5)を横切らない。
- MD-B の 5VO は未接続（5V ルール参照）。MD-B への電源・信号線は MD-A の脇を通して上層へ引き回す。
- MDD3A-A の M2 チャネルは予備とする。
- モーター出力配線は各モーターの2端子へ。モーター線は AWG20–22 程度を目安とする(3 A連続・5 Aピーク)。

## 制御信号(Nucleo → MDD3A)

| 信号 | 本数 | 仕様 |
|---|---|---|
| PWM(MxA) | 3 | 最大 20 kHz、タイマ3チャネル |
| DIR(MxB) | 3 | 3.3 V GPIO(MDD3A 論理入力は 1.8–12 V 対応、3.3 V 直結可) |
| エンコーダー A/B 相 ×3 | 6 | TIM2/TIM3/TIM4 エンコーダモード、3.3 V 給電 |
| I2C(IMU) | 2 | X-NUCLEO-IKS01A3 積層経由 |
| 非常停止 | 1 | 任意 GPIO(実装時に確定) |

- MDD3A は PWM/DIR 入力を MxA/MxB ピンに割り当てる(真値表に従い MxA=PWM・MxB=DIR)。
- モーター電力配線と IMU/エンコーダー信号配線は別経路とする(購入リストの配線方針に準拠)。

## 基板取付

- MDD3A 基板の実寸は **48.26 × 41.66 mm**、Ø3 mm 取付穴 ×4（穴間隔 **43.18 × 36.58 mm**）を持つ（実物写真に基づく）。基板の取付穴へ M3 スペーサで直接固定する（クレードル不要）。
- **2層構成（右側ストリップ、中心 (56,0)）**: L2上面の **Ø4.0** 貫通穴 (37.71, ±21.59)、(74.29, ±21.59) に挿入固定用スタッド付き M3×10 スペーサ ×4（z=178–188）を挿して MD-A（下層 z=188–199）を固定。その上に M3×10 スペーサ ×4（z=199–209）を重ね MD-B（上層 z=209–220）を固定する。
- L3 下面（z=228）まで MD-B 上面から 8 mm の隙間。Nucleo 基板（z=203–204.6）とは XY がほぼ非交差かつ高さも離れており無干渉。
- ※ 検討経緯: 2枚とも M3×25（Nucleoと同長）は不可能 — 下面側では L1–L2 ギャップ（25 mm）に基板 11 mm が入らず、上面側で 48 mm 幅基板が置けるのは右側ストリップ1箇所のみ。そのため 10 mm スペーサ 2 段積みとした。
- 各基板 4 点支持（上下で同一柱列）。端子台・テストボタンの向きはモーター線引き込み方向に合わせる。

## 接続性チェックリスト

- [ ] 両 MDD3A の VB+/VB− がバッテリーへ分岐接続されている(逆極性保護は MDD3A 内蔵)
- [ ] 5VO は MDD3A-A のみ使用、MDD3A-B の 5VO は未接続
- [ ] 全 GND 共通(バッテリー−・MD×2・Nucleo・IMU・エンコーダー)
- [ ] PWM×3・DIR×3 が各モーターの MxA/MxB に対応
- [ ] エンコーダーは 3.3 V 給電、信号は 5 V 非印加
- [ ] 5 V 系統の合計消費が 200 mA を超えない(実測)

## 未確認事項

- 2層積みの層間スペーサ長は M3×10 を暫定（MD-A 上面の端子台高さを考慮して調整可）
- バッテリー → MDD3A 間分岐のコネクタ/端子処理の選定
- 非常停止回路の結線先(Nucleo ピン割付確定後に追記)
