nenecchiCV/ball-balancing-omni-rover/.github/markdown.instructions.md

---
applyTo: "**/*.md"
---

# Markdown ファイル向け指示

Markdown ファイルを作成または編集する前に、`.agents/instructions/markdown.md` を読み、その内容を適用する。
