nenecchiCV/ball-balancing-omni-rover/.agents/instructions/markdown.md

# Markdownファイルの記述ルール

- Markdownファイルの文章は日本語で記述する。
- 抽象度の高い議論で一義性を高めるために補足する場合を除き、それ以外の文章はpositive-firstで記述する。
