nenecchiCV/ball-balancing-omni-rover/specs/hardware_design/controll/ball_balancing_omnirover3wd/ball_balancing_omnirover3wd-test-plan.md

# 玉乗り3WDオムニローバー検証計画

## 状態

| 項目 | 値 |
|---|---|
| ステータス | ドラフト |
| 最終更新日 | 2026-09-01 |
| アーキテクチャ | [アーキテクチャ仕様](ball_balancing_omnirover3wd-architecture.md) |

## 1. 検証段階

```mermaid
flowchart LR
  C[MATLAB関数] --> P[プラント開ループ]
  P --> I[閉ループ統合MIL]
  I --> R[ロバストネス]
  R --> H[実機パラメーター同定後再検証]
```

| 段階 | 合格ゲート |
|---|---|
| A. MATLAB関数 | 幾何、配分、静止推定、制御符号 |
| B. プラント開ループ | 接触・重力・正トルクの運動方向 |
| C. 閉ループMIL | 静止、速度、ヨー、復帰 |
| D. ロバストネス | 摩擦・質量・ソルバー変動で有限・安定 |

## 2. MATLAB関数検証

| ID | 対象 | 入力 | 期待値 | 判定 |
|---|---|---|---|---|
| U-01 | WheelGeometry | 公称$p$ | $n_i,t_i,a_i$相互直交 | 内積$<10^{-12}$ |
| U-02 | WheelGeometry | 公称$p$ | $A_\tau$フルランク | rank=3 |
| U-03 | 輪速変換$W_\omega$ | $u=[u_{planar};r_d]$任意 | 疑似逆で往復一致 | 平面速度再構成誤差$<10^{-9}$ m/s |
| U-04 | 輪速飽和 | 大指令 | 全輪飽和 | $|\omega_{w,d,i}|\le p.controller.lqi.maximumWheelSpeedCommand$ |
| U-05 | CustomFriction | $v_t\ne0,F_n>0$ | $F_t^Tv_t\le0$ | 常に非正 |
| U-06 | WheelRateDerivative | 変位増分$[0.01,-0.02,0.03]^T$ rad、$T_s=5$ ms | 後退差分 | $[2,-4,6]^T$ rad/s、誤差$<10^{-12}$ rad/s |
| U-07 | Estimator | 静止IMU、車輪回転変位一定 | 状態不変 | ノルム誤差$<10^{-10}$ |
| U-08 | Controller | 静止推定、指令0 | BALANCE、$\tau_w=0$ | mode=1、誤差$<10^{-12}$ |
| U-09 | Controller | $\theta=+1$ deg | 復元球トルク | $\tau_{b,y}<0$ |
| U-10 | Controller | 傾斜40 deg | FALLEN | mode=0、$\tau_w=0$ |
| B-01 | BiasObserver | 静止、バイアス0 | 0付近を保持 | $|\hat b_{g,z}|<10^{-12}$ rad/s |
| B-02 | BiasObserver | 静止、ヨーバイアス0.02 rad/s | 一次遅れ収束 | 15 s以内に誤差0.002 rad/s未満 |
| B-03 | Qualification | 全条件成立、$t<t_{min}$ | 学習待機 | $\gamma=0$、$\hat b_{g,z}$不変 |
| B-04 | Qualification | 車輪回転が閾値超過 | 学習停止 | $t_{qual}=0$、$\hat b_{g,z}$不変 |
| B-05 | Qualification | 比力ノルム偏差が閾値超過 | 学習停止 | $t_{qual}=0$、$\hat b_{g,z}$不変 |
| B-06 | Qualification | ロール・ピッチ角速度が閾値超過 | 学習停止 | $t_{qual}=0$、$\hat b_{g,z}$不変 |
| B-07 | BiasObserver | 長時間の上限超過相当入力 | 飽和 | $|\hat b_{g,z}|\le b_{max}$ |
| B-08 | BiasObserver | 静止→車輪回転→再静止 | 再認定後に学習再開 | 運動中保持、再静止後に推定値増加 |
| B-09 | Interface | 静止推定と制御器呼出し | 既存互換 | 状態14、`estimate` 13、BALANCE、トルク0 |
| B-10 | YawDrift | B-02学習後に静止10 s | ドリフト低減 | ヨードリフト0.5 deg未満 |
| B-11 | BiasHold | 学習後に車輪回転5 s | 運動中保持 | 推定値変化0.002 rad/s未満 |
| B-12 | StartupGuard | 学習未完了／完了／完了後運動 | ヨー抑止・解除ラッチ | 未完了時ヨートルク0、完了後と明示指令時は有効 |

B-01～B-12は`matlab_ws/ball_balancing_omni3/tests/ballbotEstimatorStepTest.m`のクラスベース試験として実装する。試験は公開関数を呼び出し、各テストメソッドをArrange–Act–Assertで独立させる。

## 3. プラント開ループ

### 3.1 接触静力学

| ID | 初期条件 | 入力 | 観測 | 合格条件 |
|---|---|---|---|---|
| P-01 | 公称直立 | 全輪0 N·m | 3輪法線力 | 各輪`p.wheel.normalLoadNominal`の±20%（公称約1.844 N） |
| P-02 | 公称直立 | 全輪0 N·m | 球–床法線力 | $(m_R+m_b)g$の±10% |
| P-03 | 公称直立 | 全輪0 N·m | 貫通量 | 各接触1 mm未満 |
| P-04 | 公称直立 | 全輪0 N·m | 接触信号 | 4接触すべて1 |

### 3.2 駆動符号

| ID | 入力 | 期待運動 | 合格条件 |
|---|---|---|---|
| P-05 | $\tau_b=[+0.01,0,0]^T$相当 | 球中心$-Y_W$加速 | $a_{K,y}<0$ |
| P-06 | $\tau_b=[0,+0.01,0]^T$相当 | 球中心$+X_W$加速 | $a_{K,x}>0$ |
| P-07 | $\tau_b=[0,0,-0.005]^T$相当 | 機体$+Z_W$ヨー加速 | $\dot r_B>0$ |

### 3.3 分離可能性

| ID | 初期条件 | 期待 | 合格条件 |
|---|---|---|---|
| P-08 | 機体zを+5 mm | 3輪が球から分離 | 3接触信号=0の区間あり |
| P-09 | ボールzを+5 mm | 球が床から分離 | 床接触信号=0の区間あり |

## 4. 閉ループMIL

| ID | 指令/初期条件 | 計測時間 | 指標 | 合格条件 |
|---|---|---:|---|---|
| C-01 | $v_d=0,r_d=0$ | 4 s | 姿勢 | 最終1 sで$|\phi|,|\theta|<1$ deg |
| C-02 | $v_x:0\to0.10$ m/s @1 s | 5 s | 速度 | 最終1 sで誤差<0.01 m/s |
| C-03 | $v_y:0\to0.08$ m/s @1 s | 5 s | 速度 | 最終1 sで誤差<0.01 m/s |
| C-04 | $r:0\to0.50$ rad/s @1 s | 5 s | ヨー速度 | 最終1 sで誤差<0.05 rad/s |
| C-05 | $v=[0.08,0.06]$, $r=0.3$ | 6 s | 複合追従 | 3軸すべて目標内 |
| C-06 | 初期$\phi=10$ deg | 4 s | 復帰 | 2 s以内に±2 deg |
| C-07 | 初期$\theta=20$ deg | 4 s | モード | RECOVERYを経てBALANCE |
| C-08 | 初期$\theta=40$ deg | 1 s | 安全 | FALLEN、トルク0 |
| C-09 | 静止、ヨーバイアス0.02 rad/s | 20 s | バイアス収束 | 15 s以内に誤差0.002 rad/s未満 |
| C-10 | C-09学習後、静止継続 | 10 s | ヨードリフト | 0.5 deg未満 |
| C-11 | C-09学習後、走行指令 | 5 s | 誤学習防止 | バイアス変化0.002 rad/s未満 |
| C-12 | 静止、IMU白色ノイズ・振動重畳 | 20 s | 認定ロバストネス | 発散なし、誤学習なし、退出後に再認定 |
| C-13 | 走行、輪–球すべり増加 | 5 s | 接触ゲート | 低信頼区間で$\gamma=0$ |
| C-14 | 3輪接触低下 | 3 s | 接触ゲート | 低信頼区間で$\gamma=0$、バイアス保持 |

### 共通接触判定

| 指標 | 合格条件 |
|---|---|
| 3輪接触率 | 各輪99%以上 |
| 球–床分離時間 | 0 s |
| 輪–球すべりRMS | 0.03 m/s未満 |
| 車輪トルク | 全サンプルで±`min(p.controller.tractionLimitedWheelTorque, p.controller.fullplant.motorTorqueLimit)`以内（正本構成の公称±0.010 N·m） |
| 車輪速度指令 | 全サンプルで±`p.controller.lqi.maximumWheelSpeedCommand`以内 |

## 5. 推定精度

| ID | シナリオ | 推定量 | 合格条件 |
|---|---|---|---|
| E-01 | C-01 | ロール・ピッチ | RMS誤差<0.2 deg |
| E-02 | C-02 | 平面速度 | RMS誤差<0.02 m/s |
| E-03 | C-04 | ヨー角速度 | RMS誤差<0.02 rad/s |
| E-04 | C-02 | ボール角速度 | RMS誤差<0.2 rad/s |
| E-05 | 摩擦-20% | 平面速度・ボール角速度 | 公称値との偏差を記録（診断観察） |
| E-06 | C-09 | ヨーバイアス | 15 s以内に誤差0.002 rad/s未満 |
| E-07 | C-10 | ヨー角 | 10 sドリフト0.5 deg未満 |

## 6. 飽和・アンチワインドアップ

| ID | 条件 | 回復入力 | 合格条件 |
|---|---|---|---|
| A-01 | $v_d=0.5$ m/sを1 s印加 | $v_d=0$ | 指令は0.12 m/sへ制限 |
| A-02 | A-01で輪トルク飽和 | $v_d=0$ | 積分器が飽和中に増加しない |
| A-03 | $r_d=2$ rad/s | $r_d=0$ | 指令は0.8 rad/sへ制限 |
| A-04 | BALANCE→RECOVERY | 傾斜18 deg超過 | 速度積分器0 |

## 7. 感度試験

| パラメーター | 公称 | 変動 | 再実行 | 合格条件 |
|---|---:|---:|---|---|
| ボール質量 | 0.285 kg | 0.228, 0.342 kg | C-01,C-02 | 転倒なし、誤差2倍以内 |
| 輪–球$\mu_d$ | 0.75 | 0.60, 0.90 | C-02,C-05 | 接触維持 |
| 球–床$\mu_d$ | 0.80 | 0.64, 0.96 | C-02 | 転倒なし |
| 上部ロッド込み機体質量 | 1.179 kg | ±10% | C-01,C-02 | 転倒なし |
| 接触緯度 | 33 deg | 30, 36 deg | C-01 | $A_\tau$ rank=3、接触維持 |
| IMU補正ゲイン | 2.5 | 1.25, 5.0 | E-01 | 有限、発散なし |

## 8. 数値ロバストネス

| ID | 変更 | 比較 | 合格条件 |
|---|---|---|---|
| N-01 | 最大ステップ$5\times10^{-5}$ s | C-01公称 | 最終姿勢差<0.2 deg |
| N-02 | 最大ステップ$2\times10^{-4}$ s | C-01公称 | 完走、最終姿勢差<0.5 deg |
| N-03 | RelTol$10^{-5}$ | C-02公称 | 最終速度差<0.005 m/s |
| N-04 | 代替ソルバー | C-01公称 | 完走、接触維持 |

## 9. ログ

| ログ名 | 内容 |
|---|---|
| `roverPose` | $x,y,z,\phi,\theta,\psi$ |
| `ballPose` | 球中心位置・姿勢 |
| `imuMeasurement` | 理想比力・角速度 |
| `wheelDisplacement` | エンコーダーが直接計測する3輪回転変位 |
| `wheelTorqueCommand` | 3輪トルク |
| `estimatedState` | 14幅推定バス（estimate 13要素+末尾未使用パッド） |
| `controllerMode` | 0/1/2 |
| `estimatedYawGyroBias` | $\hat b_{g,z}$ [rad/s] |
| `yawBiasLearningEnabled` | $\gamma$ [0/1] |
| `lowMotionQualificationTime` | $t_{qual}$ [s] |
| `contactStatus` | 球–床+3輪–球 |
| `contactNormalForce` | 4接触法線力 |
| `contactSlip` | 4接触接線速度 |

## 10. 実行方法

```matlab
p = ballbotFullPlantParameters;
assignin("base", "ballbotParams", p);
in = Simulink.SimulationInput( ...
    "ball_balancing_omni3_multibody_lqi_custom_contact_fullplant");
in = in.setVariable("ballbotParams", p);
in = in.setModelParameter("StopTime", "4");
out = sim(in);
```

ヨーバイアスMILでは`Simulink.SimulationInput`で注入振幅、ノイズ、振動、摩擦、接触条件を非破壊に上書きし、`Simulink.SimulationOutput`から上記3診断と`estimatedState`を取得する。マスク内部から参照する`ballbotParams`との互換性のため、実行前に同じ値をベースワークスペースへも設定する。エンコーダーは低運動認定だけに使用し、絶対ヨー角の正解信号として扱わない。

## 11. 今回の実行状態

| 項目 | 状態 | 理由 |
|---|---|---|
| 更新則の離散計算 | 合格 | 0.02 rad/s注入時の15 s誤差$1.046\times10^{-8}$ rad/s、続く静止10 sドリフト$6.022\times10^{-7}$ deg |
| B-01～B-12 | 合格 | MATLAB R2026aで16件中16件合格（現行LQI制御器向けに更新済み） |
| モジュール化回帰 | 合格 | サブシステム化後モデルと再構成前ベースラインで全ログ信号が共通時間グリッド上で一致。最大相対差は摩擦力で約$4\times10^{-3}$（可変ステップ誤差範囲） |
| モデル更新 | 合格 | モジュール化後モデルで`update`成功（ode15s） |
| `run_fullplant_regression` | 3/4合格 | upright・x・yは4接触維持・転倒なし・トルク上限内。xy合成指令は両モデルとも接触維持限界域で、再構成モデルは約2 sで輪―球接触を一時喪失。再構成前モデルも最小法線力0.04 Nの限界域であり、静止・指令前区間では両モデル一致（$10^{-4}$ rad級）。保存済み`fullplant_verification_results.mat`は現行HEADモデルでも再現しない旧条件の結果であり、制御再調整後に回帰基準を再生成する |
| C-09短時間ゲート | 合格 | 0.02 rad/s注入時、4 s誤差0.001916 rad/s、3～4 sドリフト0.005293 deg |
| C-09～C-14長時間 | 未完 | 全機体モデルがバイアス試験で4.760 s、公称指令で2.195 sにFALLENへ遷移するため |
| 既存C-01～C-08回帰 | 一部合格 | 0.5 s複合指令は平均ヨー速度0.197879 rad/s、最終mode=1。長時間ゲートは未完 |
| ノイズ・振動・すべり・接触低下 | 未実行 | 注入モデルと長時間安定化の整備後にC-12～C-14を実施 |
