nenecchiCV/ball-balancing-omni-rover/(commit log)

2026-08-31 玉乗りロボットのモデル仮組、制御できない
    [48MM-OMNI-WHEEL-for-NXT-and-servo-motor.stp, part01.step, part02.step, part03.step]
2026-08-31 できるだけsimulinkブロックで実装し、コードは最低限とするために推定器を整理
2026-09-02 推定器はある程度完成してる？ 立てない
2026-09-06 球が動くことは確認、球とローバー分離しないように変更、LQI制御バージョンを追加
2026-09-06 LQIで停止はできた
2026-09-08 ホイール震える
2026-09-09 ball_balancing_omni3_multibody_lqi_custom_contact_fullplantで並進＋倒立できた
2026-09-14 正本モデルをモジュール化し、旧モデル・旧関数・生成物を削除、制御・推定仕様書を現行構成へ整合
    - Controller を WheelSpeedSensing / StateEstimator / BalanceController / WheelDrive に分割
    - MultibodyPlant を Environment / Ball / RoverChassis / WheelAssembly1-3 に分割
    - トップレベルの冗長な Mux/Demux 中継を削除し直結化
    - old/ の旧モデル、旧制御・推定関数、build_*/run_*_demo、CAD生成物を削除
    - 単体試験を現行LQI制御器と現行設計アーティファクトへ整合（34件合格）
    - 仕様書を階層制御・輪速PI・DCモータ構成へ詳細化
    Generated with [Devin](https://devin.ai)
    Co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
    [.nexus16007_motor_layer.step.generation.progress.json, .nexus16007_motor_layer.step.py.generation.progress.json, .nexus16007_motor_layer.step.py.generator.progress.json, MotorMount_C_reference.stl, nexus16007_chassis.step, nexus16007_chassis.stl, radial_ramp_chassis.step, radial_ramp_chassis.stl]
2026-09-14 3輪ボールバランシングオムニローバーのCADアセンブリとパーツを追加
    READMEの幾何仕様（ボールØ100、ホイール接触緯度55°、方位0/120/240°、
    ホイール中心 r=42.4/z=110.6、車軸35°傾斜外向き）からFusionアセンブリを作成。
    外向きモータ構成・3層円板フレーム・M4x50スペーサ12本を含み、
    406ペアの干渉チェックで体積干渉0を確認済み。
    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
    [Ball_100.step, Ball_100.stl, FIT0521.f3d, Frame_L1.step, Frame_L1.stl, Frame_L2.step, Frame_L2.stl, Frame_L3.step]
2026-09-15 モータを内向き配置へ再設計し、CADと仕様を更新
    - 車軸を接触法線まわりにphi=65deg回転したピンホイール配置を採用
    (lambda=55degの接触幾何は維持、車軸交点でのモータ衝突を回避)
    - MotorMount_v2: フェース板4mm+ガセット+水平フット、M3x4+Ø9逃げ、
    M4x4フット穴でL1下面へ締結
    - WheelAdapter_v2: Ø11.9/Ø8.4段付きブッシュ、ボアØ4.15
    - Frame_L1: 新マウント穴パターン(4x3)へ更新
    - 最大外形Ø160mmを確認、全406ペア干渉0
    - 部品STEP+STLをcad/partsへ出力、アセンブリf3d/stepを更新
    - READMEにφ定義、部品表、3Dプリント設計メモ、検証結果を追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
    [Ball_100.step, FIT0521.step, FIT0521.stl, Frame_L1.step, Frame_L1.stl, Frame_L2.step, Frame_L3.step, Ground_ref.step]
2026-09-15 同軸外向き配置・高緯度設計へ変更（lambda=65, phi=0, Ø215）
    - モータを車軸方向に外向き（-a_i）配置し、車軸回転phiを0に戻す
    - 接触緯度を55→65degに引き上げ、隣接ホイール間クリアランス4.7mmを確保
    - 外形はモータ先端支配でØ215mm（同軸外向きの実質下限）、フレーム板はØ160維持
    - MotorMount_v3: フェース板3.6mm+アーム+水平フット、M3ザグリ付
    - WheelAdapter_v3: Ø11.9スリーブ、ボアØ4.15
    - Frame_L1: 新マウント穴パターン（r=57/64, y=±9）再構築
    - 全ペア干渉0、車軸位置誤差0.00mmを検証済み
    Co-Authored-B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
    [Ball_100.step, FIT0521.step, FIT0521.stl, Frame_L1.step, Frame_L1.stl, Frame_L2.step, Frame_L3.step, Ground_ref.step]
2026-09-15 モータポッドをボールキャスターでボール支持する構造を追加
    - MotorMount_v4: フェース板下端から張り出す一体ソケットブロックを追加
    - Ø10.6球ポケット＋Ø8.7口部でØ10球を捕捉、球先2mm突出
    - 球接点はボール面 緯度約37deg（ポッド対称面上、s=-26mm）
    - CasterBall_10: Ø10 POM/スチール球、3ポッド分配置
    - ポッドはホイール接点＋キャスター接点の2点でボールに支持され、
    L1片持ち荷重とモータ軸モーメントを軽減、ホイール法線荷重も増加
    - ジョイント40（リジッド37＋リボリュート3）、全116ボディ干渉0
    - クリアランス: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
    [Ball_100.step, CasterBall_10.step, CasterBall_10.stl, FIT0521.step, FIT0521.stl, Frame_L1.step, Frame_L1.stl, Frame_L2.step]
2026-09-18 MotorMount_v5＋Pololu 3/8インチボールキャスターへ変更しNucleo/IMU選定を追加
    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
    [MotorMount_v5.step, MotorMount_v5.stl, ball_balancing_omnirover3wd_assembly.f3d, ball_balancing_omnirover3wd_assembly.step, pololu_ball_caster_375.step]
2026-09-18 Simscapeアクチュエータ構成のrev1モデルを追加
    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
2026-09-20 FIT0521用モーター固定パーツとフレーム1層プレートのCADを追加
    外側張り出し同軸配置(案A)でFIT0521を14108ホイールに直結。
    クラドル+キャップのクランプ式マウント、水平延長フランジ経由で
    M4ネジ+ナットによりモータ層プレートへ固定。その他のねじ穴は
    M3熱圧入インサート前提のポケットとした。
    [fit0521_drive_layout.step, fit0521_motor_layer_plate.step, fit0521_motor_layer_plate.stl, fit0521_motor_mount_cap.step, fit0521_motor_mount_cap.stl, fit0521_motor_mount_cradle.step, fit0521_motor_mount_cradle.stl]
2026-09-20 モーターマウントをギアボックス筒部クランプ式に再設計しボールキャスターホルダーを追加
    - クラドルをモーター前面から約22mmのギアボックス筒部のみを覆う形状に短縮
    - フレーム1層への固定はプレート下面の連続した水平パッド(半径49-63x接線±30)経由のM4ネジ+ナットに変更
    - 固定穴(半径56/接線±24)は周囲半径6mm以上に他形状のない板面上に配置
    - キャスター用にそれ以外のねじ穴はM3熱圧入インサートポケット
    - 球緯度+30°・方位60/180/300°に接するボールキャスター(仮モデル)用ソケットホルダーを追加
    - プレート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
    [ball_caster_holder.step, ball_caster_holder.stl, fit0521_drive_layout.step, fit0521_motor_layer_plate.step, fit0521_motor_layer_plate.stl, fit0521_motor_mount_cap.step, fit0521_motor_mount_cap.stl, fit0521_motor_mount_cradle.step]
2026-09-21 MotorMount_v7＋WheelAdapter_v4へ更新し接触緯度65 degへ統一
    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
    [MotorMount_v6.step, MotorMount_v6.stl, MotorMount_v7.step, MotorMount_v7.stl, WheelAdapter_v4.step, WheelAdapter_v4.stl, ball_balancing_omnirover3wd_assembly.f3d, ball_balancing_omnirover3wd_assembly.step]
2026-09-21 モーターマウントをギアボックスボルト締結+ストラップ式に再設計しボールキャスターを削除
    - MotorMount_v9(46面): 水平パッド+2本脚+傾斜クレイドル+ギアボックス壁板の一体成型ポータル構造
    - MotorClampStrap_v1(15面): モーター胴体を押さえるクランプストラップ
    - ギアボックス前面M3タップ(PCD17)へ壁板越しにボルト+ワッシャー締結
    - Frame_L1固定はパッドのØ4.5穴×4でM4ネジ+ナット、その他はインサートナット前提
    - Caster_Pololu 3ユニットと関連エクスポートを設計から削除
    - モーターを軸回り180°回転しエンコーダー張り出しを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
    [FIT0521.step, ball_balancing_omnirover3wd_assembly.f3d, ball_balancing_omnirover3wd_assembly.step, ball_caster_holder.step, ball_caster_holder.stl, fit0521_drive_layout.step, fit0521_motor_mount_bracket.step, fit0521_motor_mount_bracket.stl]
2026-09-22 ハード設計変更に合わせて機構仕様を更新しキャスター関連成果物を削除
    - MotorMount_v7(49面) -> MotorMount_v9(46面) + MotorClampStrap_v1(15面) の仕様へ更新
    - ボールキャスター(Pololu 3/8インチ)を構成部品・レイアウト・検証から削除
    - ギアボックス側挿入 + 前面M3タップ壁板締結 + ストラップクランプの締結仕様を記載
    - 接触緯度55 deg表記を65 degへ訂正、車軸交差点・フェース位置を実測値へ更新
    - 旧レイヤープレート、v2生成スクリプト、キャスター部品ファイルを廃止
    Generated with [Devin](https://devin.ai)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
    [CasterBall_10.step, CasterBall_10.stl, MotorClampStrap_v1.step, MotorClampStrap_v1.stl, MotorMount_v9.step, MotorMount_v9.stl, fit0521_motor_clamp_strap.step, fit0521_motor_clamp_strap.stl]
2026-09-22 Reproduce real frame structure in mass model; wire LQI fallback path
    Chassis lumped mass now follows ball_balancing_omnirover3wd_assembly:
    three ABS frame plates, M4 spacers, MotorMount_v9 + ClampStrap
    (volumes from STEP solids), and L1/L2 electronics payload. Body mass
    0.180 -> 0.604 kg, rover 1.085 -> 1.509 kg, combined COM 201 -> 161 mm
    above ball center, chassis tilt inertia 2.18e-3 kg m^2. Reduced plant
    and payload composition use the real tilt inertia (unstable pole
    6.40 rad/s); N_nom 5.44 N, tau_contact 0.098 N m, slip-limited speed
    0.524 m/s. Simscape ChassisSolid switched to custom inertia/COM.
    Solver: MinStep = 1e-6 + ode23t makes friction stick-slip transitions
    complete determini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
2026-09-26 Bind each model to its own parameter builder and self-heal stale sets
    rev1.slx PreLoadFcn incorrectly loaded ballbotFullPlantParameters, which
    lacks the Simscape Electrical actuator fields (armatureInductance, MDD3A
    thresholds, bridge resistance) the rev1 plant requires, so a fresh
    session produced an un-runnable model.
    Each parameter builder now stamps p.parameterSource and each model
    InitFcn regenerates ballbotParams when the workspace variable is missing
    or was produced by an incompatible builder, so stale parameter sets can
    no longer silently drive the wrong model. The fullplant model's
    WheelRateCalculation now passes p.encoder.quantization to match the
    current ballbotWheelRateFromDisp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
2026-09-26 Add torque/duty direct-drive path to bypass wheel-speed PI on rev1
    The measured wheel-speed loop bandwidth (~5.6 rad/s) sits below the
    unstable tilt pole (~6.4 rad/s), so balance through speed commands is
    unreachable. In torque mode the LQI outputs wheel torque and
    ballbotTorqueDutyStep inverts the motor equation for duty, which
    responds at the electrical time scale instead.
    Measured the plant's torque-input B matrix with open-loop steps and
    found the reduced model overpredicts tilt coupling ~2.4x and yaw
    ~70x; ballbotTorquePlantDynamics now applies fit scales, and
    ballbotDesignTorqueLqi designs on the fitted model. The shipped gains
    come from a discrete LQR on the measured B (tilt x8, tilt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
2026-09-27 Add outer-loop channels and ball-spin brake to torque drive
    Outer loop, structured by actuator physics: wheel torque is internal
    to the rover+ball system and cannot accelerate the assembly centre of
    mass, so the channels split -- velocity tracking goes through a lean
    setpoint (gravity is the only external planar force), and the
    rover-ball offset takes direct torque through the wheel map (measured
    s'' ~= -8.7 m/s^2 per N*m coefficient). Both ship disabled: the inner
    loop still tips at ~4-7 s, so the outer channels cannot be validated
    in isolation yet.
    Two noise/energy paths found and fixed while chasing the residual
    divergence:
    - The yaw damper's common-mode torque pumps chassis angular mo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
2026-09-27 Add truth-feedback gate; isolate divergence source to yaw/ball-spin pump
    A/B experiment (estimator vs plant-truth feedback on identical plant,
    gains, actuator path) shows tip-over at ~5.3 s in both modes, so the
    estimator is not the divergence driver; nor is encoder quantization.
    Removing the yaw-rate feedback column and the ball-spin brake instead
    holds tilt at machine zero for ~10.5 s under estimator feedback --
    the common-mode torque channel pumps energy between chassis yaw and
    the free ball-spin mode until contacts unload. Both channels now ship
    at zero.
    Normal-force collapse follows the geometric unload limit (~0.13 rad
    quasi-static tip-over) rather than preceding it, so the wheel-bal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
2026-09-29 Robust fixed gains over 1-2kg mass range; estimator accel gate fix
    - ballbotRobustTorqueGains: scale the measured torque-input B matrix
    across the payload family (0-1 kg) via 1/Ipivot and 1/Iyaw, solve a
    discrete LQR per mass, cross-apply all candidates to all plants, and
    keep the gain with the smallest worst-case closed-loop pole radius.
    A nominal-point design is provably not robust: tilt authority drops
    ~8x light-to-heavy, so the fixed gain must come from the heavy end.
    - ballbotPayloadRoverProperties: single source for payload->mass/COM/
    inertia math (ballbotRev1Parameters refactor, identical values).
    - ballbotEstimatorStep: enable accel up-vector correction only when
    |f|~g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
2026-09-29 Fix rover drop-hop and soften saturated tilt channel
    - ballbotRev1Parameters(payloadMass): initialPositionWorld(3) placed the
    rover origin at comAboveBall, but the frame must sit at
    centerAboveBall -- COM rises with payload, so the chassis was spawned
    36-68 mm too high, free-dropped onto the ball (kN-scale impulse), and
    the wheels chattered on/off contact. This was the visible hopping and
    it seeded the early divergences. Wheel normal force is now a
    continuous 4.07 N equilibrium from t=0.
    - tractionLimitedWheelTorque scales the measured 4.07 N rest load with
    supported mass instead of pinning the nominal value, so heavier builds
    use the budget their normal force transmits.
    -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
2026-09-30 Quiet small-signal torque path and soft-start for IMU robustness
    Retune tilt:rate scaling to near-LQR ratio (tilt x1.8 clears the 1 kg
    static-hold floor ~4.2 N*m/rad; tilt 0.004 rad now commands ~43% of the
    traction clamp instead of 97%). Add gyro-rate low-pass (20 ms), lean
    slew limit, gravity-hold lean feedforward, tilt-gain scheduling, and a
    0.40 s startup torque ramp so the enable-time contact transient does
    not saturate the first correction. Lengthen move window to 18 s so the
    0.06 m/s^2 ramp actually completes.
    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
2026-09-30 Fix estimator self-referencing gate; scope startup ramp to disturbance paths
    Estimator roll/pitch: drop the horizontal-acceleration gate (computed
    from the estimated attitude, so an a/g-sized error hides real
    acceleration and the correction locks open during motion, tracking
    specific force instead of gravity). Correction now requires the
    motion-sensor quiescent witness only, plus a 0.5 rad/s rate clamp.
    Controller: soft-start ramp now scales only propulsion + lean
    feedforward (the disturbance sources); tilt PD keeps full authority so
    settle-time excursions remain catchable. Add a bounded leaky
    tilt-error integrator (default on, Ki=0.5) to absorb constant
    disturbance torques that the ~5%-m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
2026-09-30 Add MiaPURE-style cascade controller (tilt LQR + bounded ball-velocity PI)
    New architecture per arXiv:2304.02887: outer loop maps ball-velocity
    error to a commanded lean; inner LQR owns tilt/tilt-rate with wheel
    torques; a weak bounded PI trims contact friction. Replaces the legacy
    wheel-speed propulsion servo whose reaction torque wheeled the chassis.
    Known-good parts verified in sim: zero-command hold is clean (tilt <0.001
    rad, symmetric contact N=4.1 N) once the startup slip pump was fixed via
    differential-only wheel damping + common-mode removal + ball-spin brake.
    UNVERIFIED: move-phase still diverges ~1-2 s in (load shift unloads a
    wheel at tilt >0.005 rad); startup settle transient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
2026-09-30 Remove files unrelated to the rev1 cascade architecture
    Drops the legacy fullplant model, its design artifacts/scripts/tests,
    the pre-ballbot 3wd omnirover workspace, orphan helpers, scratch
    diagnostics, and all cycle_result_*.mat outputs. Everything remains
    recoverable from the legacy-torque-lqi-rev1 tag.
    Remaining runnable set: ball_balancing_omni3_multibody_lqi_rev1.slx +
    ballbotRev1Parameters (1:1), its dependency chain verified via
    dependency analysis, scratch_cycle.m for validation runs, and the two
    unit test files (estimator + parameters, both passing).
    README rewritten to describe the cascade architecture and the honest
    verification state (clean zero-command hold; move-phase diver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
2026-10-01 Restore rover initial-position helper; fix cascade plant model scaling
    ballbotRoverInitialPosition.m is required by RoverFreeJoint position
    targets (called via mask parameter strings, invisible to dependency
    analysis) -- its deletion left the chassis at the default joint origin.
    Also corrected the cascade design model: the torque->planar-force map
    now includes p.torqueFit.forceScale (0.5), the measured compliant-
    contact coupling factor, so Bvel and the PI allocation reflect the
    plant's real ~2x-weaker force delivery.
    The LifeSpan / MaxDataPoints / LoggingIntervals errors were traced to a
    shadowed 'inf' variable in the MATLAB base workspace, not the model;
    verified model update is clean.
    G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
2026-10-01 Idealize contact environment; fix estimator flicker and saturation pumps
    Environment side (per review direction: idealize surroundings, keep the
    onboard motor/sensor models precise):
    - Wheel-ball and ball-ground contacts: near-critical normal damping
    (the previous zeta ~0.1-0.4 underdamped normals were the startup
    bounce seed) and softened 10x so the hyperstatic tripod shares load
    smoothly instead of unloading a wheel at ~0.005 rad of tilt.
    - Contact friction raised to mu=2 fixed: the plant cannot slip. The
    wheel-slip limit is preserved controller-side via the new
    tractionEstimateFriction=0.75, decoupled from the contact friction.
    - Wheel preload 0.2->0.4 mm (deeper engagement mar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
2026-10-01 Add direct relPos wheel-torque PD channel to cascade controller
    Lean-domain ball centering can only move the chassis and injects tilt
    faster than it re-seats the ball (gain sweep 2->15 shortened hold).
    The direct channel applies a bounded zero-sum wheel-torque pattern
    through pinv(Bvel), rolling the ball back under the chassis -- the
    MiaPURE inner-state analogue -- while the tilt loop absorbs the
    reaction. Lean-domain positionGain is switched back off.
    Zero-command hold with this channel: machine-zero tilt for 1.5-3 s
    then tips at 2.7-3.7 s (vs ~1 s without). The remaining divergence is
    an authority-scale mismatch: the LQR's demanded torque at plausible
    tilts (~0.5 N*m at 0.05 rad) is >10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
2026-10-01 Delay-aware saturation-constrained LQR for cascade balance controller
    - Augment the design plant with per-wheel first-order actuator lag
    states (45 ms, covering motor electrical/mechanical + sample ZOH +
    gyro-filter delay) and feed back the internally tracked applied
    torque through the new Klag columns.
    - Select gains against the motor/traction torque cap: candidates must
    clear the tilt-stiffness hold floor and keep tilt demand inside the
    linear saturation cone on the target payload; gains are
    payload-scheduled since one gain cannot satisfy both ends of the
    family.
    - Raise the traction clamp derating to 0.80 (idealized contacts no
    longer dip normal force), bound relPos estima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
2026-10-14 Improve rev1 sim speed and hold stability; retarget cruise to 0.306 m/s
    Simulation speed: ballbotRev1SimConfig applies MaxStep=1e-3 and sets the
    three MDD3A drivers to always-enabled regenerative braking, removing the
    per-current-crossing equation-mode switches (~4x faster execution, far
    fewer Newton exceptions). The .slx stays in R2024b format because
    Simscape Electrical blocks cannot be down-exported from newer releases,
    so the settings are applied by script instead.
    Hold stability (baseline fell within ~8 s; now upright through 8 s):
    - Startup settle window (0.35 s, torque zeroed): the contact grab
    transient excites an ~8 Hz rocking mode that closed-loop feedback
    amplified ~8x; lett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
2026-10-14 Default to torque-LQI with plant-error suppression; fix stillness estimator
    Switch the default controller to the torque-input LQI path with the
    mechanisms that suppress plant/model error: filtered wheel-rate slip
    damping and propulsion servo (encoder flicker is >50% of the cruise
    rate signal), common-mode torque removal, ball z-spin brake, and a
    translation-gated yaw damper. Verified machine-quiet hold (~0.007 rad
    over 5 s) including payload 0.5/1.0 kg, which previously fell.
    Estimator: stillness detection now uses the low-passed wheel rate
    (blind band shrinks to ~0.03 m/s) and a still-velocity drain removes
    accelerometer-integrator phantom drift (~0.5 m/s observed mid-move).
    Cascade stays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
2026-10-14 Add ball-ground rolling resistance and retune controller for it
    The point contact resisted only sliding, so a coasting ball never shed
    momentum -- the missing dissipation behind the deceleration runaway.
    Adds a runtime plant augmentation (ballbotRev1PlantAugment +
    ballbotRollingResistance): an External Force and Torque load on the
    ball frame, driven by the joint's sensed velocities and the ball-ground
    normal force, so the drag vanishes airborne. Applied from
    ballbotRev1Parameters at InitFcn so the .slx stays in R2024b format.
    Retuned around muR=0.005: a separate gentler deceleration limit
    (0.02) since braking margin is thinner than drive margin; measured
    alternatives (muR 0.003/0.007/0.01,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
2026-10-14 Model Zeee 7.2V NiMH battery on L1; gate stillness drain by dwell time
    Place the selected 0.423 kg NiMH pack at the centre of chassis layer 1,
    raise the driver supply to 7.2 V nominal, and cap PWM duty at 6/7.2 so
    the average winding voltage stays within the FIT0521 6 V rating. Raise
    ball-ground rolling friction to 0.008, the value that carried a full
    move+stop window with the heavier chassis.
    Gate the stillness velocity drain AND the ball-rate zeroing behind ~1 s
    of continuous stillness: a real ~0.025 m/s creep sits on the filtered
    rate threshold, flickers the flag, and previously had its velocity
    drained away until the lean walked off (1.0 kg payload regression).
    Generated with [Devin](h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
2026-10-14 Switch to goBILDA 48mm dual-row omniwheel; raise traction budget and retune transitions
    Wheel is now the ServoCity 48 mm omni (3624-4008-0048): 32 g, 18 mm
    width, two staggered rows of 50A rubber rollers. Rubber rollers on a
    rubber-sprayed ball justify mu_est 1.0 (was 0.75), widening the
    traction clamp to ~0.078 N*m/wheel; bench slip-onset measurement still
    pending.
    Controller: add command-acceleration feedforward so the lean demand no
    longer saturates during ramps (killed the ball-overrun ringing on
    accel), cap the common-mode ball z-spin brake at 0.025 N*m so it cannot
    starve the zero-sum tilt pattern during transitions, strengthen yaw
    damping (0.30) and ball-spin brake (0.12), widen lea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
2026-10-14 Add follow-through braking for deceleration overrun and stop windows
    Diagnosis (clean runs, tilt>0.5 rad fall criterion): every failure up
    to now died in the first stop window at ~14 s. The ball keeps rolling
    at ~0.24 m/s after cmd hits zero; locking the wheel-rate servo at the
    slower/zero command drags the contact, the momentum-transfer kick
    starves the saturated torque budget, and the roll axis diverges.
    Fix: when commanded speed drops below stopFollowGain*|vBall|, command
    followGain*vBall instead. The velocity error becomes (g-1)*vBall -- a
    speed-proportional gravity brake that fades as the ball stops -- and
    the wheel servo rolls WITH the ball. Measured: stop window bleeds vB
    0.24 ->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
2026-10-14 Extend follow-through to deceleration overrun; default gain 0.75
    Follow-through now engages whenever commanded speed < 0.75*|vBall|,
    not only at zero command -- the ball also overruns the command during
    the deceleration ramp, which is where cycle 2+ died. Default gain
    tuned to 0.75 by scan (tFall 46.4 s on the 3-cycle profile vs 14.1 s
    disabled). A ball-speed engagement gate was tried and reverted
    (flicker-band chatter made transitions worse; hold tilt is unaffected
    either way).
    Also adds torqueSlewLimit hook (shipped at 0): slew-limiting the
    torque command did not break the cruise limit cycle (tFall 7.8-14.5 s
    at 0.15 m/s), kept documented for retuning.
    Cruise ceiling measured ~0.12-0.1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
2026-10-14 飽和を織り込んだ LQI 再設計: R を 4000 に、lean 帯域をゲイン由来に、輪速をモデル支援オブザーバ化
    - ballbotRobustTorqueGains: LQR の R を 2000→4000 (帯域引き下げ)。
    Ktilt ~6.5 N*m/rad、worst-case 極半径 ~0.9971 でロバスト性は維持。
    - ballbotRev1Parameters: leanSetpointLimit を 0.016→0.009 に再導出
    (帯域端のフィードバック要求をクランプの ~75% に制限: 旧 133%)。
    tiltStiffenGain 4.0→2.0 (帯域外の過剰ドライブを半減)。
    輪速オブザーバ用パラメータを追加 (gain 0.15 / drive 306 / compliance 0.134)。
    - ballbotLqiControllerUpdate: filteredWheelRate をモデル支援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
2026-10-15 Verify LQI redesign on rev1 model; reset interpreted persistents between sims
    Simulink verification of the PR #6 redesign (R=4000, gain-derived lean
    band 0.009, tiltStiffen 2.0, model-aided wheel-rate observer):
    - 0.12 m/s move/stop cycle: survives to t=25.6 s, tipping at the
    cycle-2 deceleration corner (wheel unload past the ~0.2 m/s ball
    contact wall). Every single-parameter revert tips earlier:
    tiltStiffenGain=4.0 -> 23.9 s, leanSetpointLimit=0.016 -> 21.6 s,
    observer off -> 23.2 s. The three redesign elements each contribute.
    - Torque no longer bang-bangs: duty p99 ~0.35 vs the 0.83 clamp, and
    recovery mode engages and returns to balancing several times per run.
    - 0.306 m/s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
2026-10-15 プラント実機化: IMU非理想性と車輪軸摩擦を追加
    - ballbotImuFromJoint: LSM6DSV16X 実測仕様のバイアス/白色ノイズ
    (200 Hz レート換算)/量子化/振動注入フックを p.imu で有効化
    - ballbotRev1PlantAugment: ギア出力軸の Coulomb+breakaway 摩擦を
    Ideal Torque Source + 平滑則 (ballbotShaftFrictionTorque) で
    ロータ/ケース間に動的追加。受動 Rotational Friction 要素は
    RMI トルクの初期値を未定にして特異となるためソース駆動に変更
    - motor.lam を viscousShare 分に削り無負荷損失の二重計上を回避
    検証: エンコーダ量子化+IMUノイズ+軸摩擦ありで 5 s 直立保持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
2026-10-15 ベンチマークハーネス: G-01〜G-11 指標の自動採点
    シナリオ hold/stepX/yaw/cycle/bias を実行し、姿勢・速度整定・
    ヨーレート・接触率・分離時間・推定誤差・飽和・バイアス学習を
    spec 閾値と照合して result.pass に集計する。
    リアル化プラント(IMU非理想+軸摩擦)上の現行制御ベースライン:
    hold 6/7(G-07限界外), stepX 6/9(G-02 実効速度~0で失速),
    yaw 6/9(G-03 達成~0.1/0.5), bias 5/8(G-09 資格ゲート不成立,
    G-10 真ヨー14.5deg/10sドリフト)。
    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
2026-10-15 ballforce制御器: ボール速度PI→平面力配分の新規並進チャネル
    トルクLQIの輪速サーボは輪速=ボール転動速度の接触拘束により到達不能な
    レート目標へ飽和し、0.10 m/sステップでボールが全く動かない(整定誤差
    -0.105 m/s)ことを実測。新経路は力要求をpinv(Bvel)で最小ノルム輪トルク
    へ配分し、ボールを指令速度へ実際に追従させる(+0.011 m/s)。
    姿勢・モード機械・滑り/スピン/ヨー・輪速オブザーバ等のレールはLQIと
    共有して静止時挙動を構造上一致させ、並進チャネルのみを差し替える設計。
    軸静摩擦のプリロードとし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
2026-10-16 離散周期の可変化とCGオフセット頑健性試験を追加
    - ballbotParameters/fullplant/rev1Parameters に sampleTime 引数を追加
    (既定5ms)。量子化フリッカー閾値・フィルタ重み・c2dゲイン再設計など
    Ts依存量が一貫して再構築される。モデル側SampleTimeは式参照のため
    自動伝播。
    - p.fullplant.payload.lateralOffset と augment でペイロードロッドの
    横オフセットを実行時適用(冪等・既定[0;0])。
    - ballbotBenchmark に第4引数 sampleTime と ov 後の augment 再適用を追加。
    計測結果(LQI・リアル化プラント): Ts=2ms(500Hz)で cycle を既定シードで
    52s完走(5msでは36.6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
2026-10-16 速度推定改善3案を実装・A/B: 窓積算輪速/T法エンコーダ/Kalman融合はいずれもcycleで現行に及ばず不採用
    量子化フリッカー対策として3案を実装し同一条件で比較した:
    - 窓積算輪速(wheelRateWindowTime): hold 0.875->0.670degに改善するが
    窓内の減速残存が遅延推定を注入しcycleが~15s級へ悪化
    - T法エンコーダ模擬(timedRateEnabled/augment差替): 停止後の最終方向
    減衰がバイアス化して保持悪化
    - 速度融合Kalman化(velocityFusion='kalman'): hold同等・cycle 25.7sで
    現行36.6sに及ばず
    全フラグoffで無効時経路は完全一致を確認し、既定は従来経路を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
2026-10-16 窓積算輪速に静止ゲート追加・既定off維持 + 減速コーナー脱輪の機構を特定
    - 窓積算輪速はフィルタ済み輪速の持続静止ゲート経由で運動学求解のみに
    注入する構成に整理（バイアス/準静的ゲートは生レートへ戻し、窓充填期の
    偽静止リークを遮断）。holdは0.875->0.651degに改善するが、窓長・周期を
    変えてもcycleは全て36.6s以下に悪化するため既定off維持
    - 脱輪メカニズムを時系列で特定: 停止指令後に制動リーンがボールを移動方向へ
    射出し、車体速度推定が~30%過小評価のまま相対位置が発散して脱輪。
    アン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
2026-10-16 静的リーン/CGオフセット学習を実装: ドリフト速度→リーン整定点バイアス適応
    20mm横オフセット保持が転倒から生存へ（10mm: 1.02°、15mm: 3.87°、
    20mm: 4.14°過渡で5s保持、0mmは0.913°で不変、cycleは適応有無で
    ビット一致）。休止突入エッジの静止判定でcycle停止窓のクリープを
    誤学習しない構造。減速コーナー脱輪は既存アーキテクチャの限界を
    確認（stopFollow 0.3/0.97 ともに悪化）。
    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
2026-10-17 減速コーナー対策第2ラウンド: 転倒形態の再特定 + 新レバーA/Bは全て不採用
    転倒は停止窓そのものではなく、relPos≈-0.05(ボール先行)を保持した
    まま次の移動脚で加速する瞬間に発生することを特定。速度適応制動・
    車体先行フォロー・惰行リセンタリングはいずれも内部運動量交換の
    制約で悪化(stopFollow 0.75が局所最適と確定)。500Hz+学習機構の
    相互作用(微小バイアス摂動)を発見し静止判定を生輪速由来に強化。
    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
2026-10-17 移動脚突入時の偏心ゲート採用 + staticLeanAdaptロール軸符号修正
    - 偏心ゲート（accelRelPosGuardGain=12既定ON）: ボール先行状態での
    移動脚突入時にaccelerationDemandを絞り、cycle 33.6→43.8sに改善。
    hold/stepX/yawはベースライン同等（yaw ~8.6s転倒は既知限界）。
    2msでは逆効果のため5ms既定専用。cycle転倒自体は残存。
    - staticLeanAdapt注入のチャネル2反転を修正: biasは平面ベクトル
    ではなくtilt整定点[pitch;-roll]規約。+y CGオフセットで正帰還
    （20mm y-offset: 適応on 2.6s / off 4.7s転倒）していたものを修正、
    y-offset 10/15/20mm全て5s保持を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
2026-10-17 車輪接触緯度 65→40度へ再設計: cycle完走達成
    根本因特定: 緯度65°では輪法線力 N=mg/(3sinλ) が不足しトラクション
    限界が減速コーナー脱輪・yaw転倒・保持ジッタを支配していた。緯度
    掃引で40°が最良（cycle完走0.27°・7/9、hold 0.19°、yaw完走7/8、
    stepX 7/8、CG20mm 2.06°保持）。45°も完走（6/9）、50°はガードoff
    条件で完走、55°以上は転倒。design.*オーバーライド機構追加で
    幾何/ゲイン派生前の一貫変更を可能化。先の球径拡大実験は幾何未連動
    のため無効と訂正。偏心ガードは40°でも有効のためON維持。
    Generated with [Devin](ht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
2026-10-18 車輪接触緯度 40→33度・案B内向きモーター配置へCAD再設計: MotorMount_v12
    - λ33採用(案B成立の幾何境界)でモーターを車軸内向き上向きに同軸直結
    - MotorMount_v12: 均一厚28mm側板スラブを新規設計(過去形状不使用)
    - 側面伏せ印刷でサポート不要、全穴が水平穴
    - Ø26挿通ボア/PCD17 Ø3.5×4/パッドØ4.6×4(印刷補正済)
    - 凹角フィレットR4×3+R2.5×1、ボルト頭隙間3.4mm
    - Frame_L1にモーター尾部用Ø48穴×3、ストラップ廃止(ハブブラケットと干渉)
    - 全3ステーション全ペア干渉0mm³、ホイール緯度33.00°、モーター軸dot=1.0000
    - ballbotParameters.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
2026-10-18 λ33・案B内向き構成の確定: モーター/ホイール配置の焼き込み固定、MotorMount_v13スリーブ式マウント新設計、λ65復帰原因の根絶
    - モーターをステーション別コンポーネント FIT0521_P0/P1/P2 として最終姿勢焼き込み（オカレンス変換の保存時巻き戻し対策）
    - MotorMount_v13: 車軸同軸スリーブ Ø31/Ø25.5 + ウェブ + L1タブ一体の単一ソリッド（18.63 cm³・39面）
    - ギヤボックス前面 PCD17 M3 締結（キャップ壁 Ø3.5×4 + Ø7.2 ポケット）、Frame_L1 とタブ Ø4.5×2 の M4 ボルト+ナット挟み締結
    - WheelAdapter_v4 延長でシャフト係合 3.7 mm 確保
    - 破損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
2026-10-18 MotorMount_v23確定: 接線平行面取り(フェイス板面と同一面)・締結穴2列化・締結規格をM3+Ø6ワッシャへ統一(フェイス板はM2.5)、スペーサー穴+30°回転
    - モーター端部下端角をボール・ホイール接線に平行な面で面取り、+1.358 mm深化でフェイス板外面と同一面へ(面統合)
    - 締結プレート穴を内外2列 (44.5,±29)+(62,±29) の4穴/ステーションへ増設、Frame_L1に対応12穴
    - M4想定箇所を全てM3(Ø3.5)+Ø6ワッシャへ移行。フェイス板のみM2.5(Ø2.9貫通+Ø6.0ポケット)で中央Ø25ボスへ再構成
    - スペーサー穴を全層で+30°回転({0,±60,±120,180}・r=65・Ø3.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
2026-10-18 R2026a版: λ33内向き構成のLQI制御を確定、contactConfidence系ロジック削除、GUI Run再現機構を整備
    - モデルを R2026a 形式で保存（R2024b 用はブランチ側にエクスポートを追加）
    - 既定プロファイル: 移動12s/停止4s×3周期、停止窓で0.1radヨーバーストを隔周期発行（49.5s完走・maxTilt~1.0°）
    - contactConfidence（常時~1で全ゲート不発）のモード遷移・バイアス学習ゲート・関連パラメータを削除
    - 推定バスは14幅維持（estimate 13要素+末尾未使用パッド）、モデル配線・Selectorは不変
    - ballbotRev1Parametersにpending→InitFcn再構築機構を実装（GUI Run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
2026-10-18 R2024b互換モデルを追加: ball_balancing_omni3_multibody_lqi_rev1_r2024b.slx
    mainの .slx は R2026a 形式に移行したため、R2024b 環境向けに R2024b 形式の
    コピーをこのブランチに保持する。Simscapeブロックを含むモデルは
    exportToVersion が部分変換しか完了しないため、最後の真の R2024b 形式
    ファイル（2b349dc 時点）を採用。内容は現行モデルと同一（プラント変更は
    全てランタイム適用）。
    注意: 保存値 StopTime=2 のため、GUI でフルサイクルを確認する場合は
    StopTime を 50 に設定すること。
    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
2026-10-19 起立リカバリ制御の強化と初期傾き・傾斜床の検証包絡を確定
    - recoveryTilt 18→5deg, 退出ヒステリシス2deg, recoveryGainScale 3.0
    - mode 2 専用トルク上限 recoveryWheelTorqueLimit（公称2倍）を
    LQI/下流TorqueDutyStep双方に追加し elevatedAuthority で mode 1
    定常化期も継承（車輪静止で解除）
    - mode 2 を姿勢チャネルのみに限定（速度系はLQIゲインゼロのため無損失）、
    settle中の速度積分器を凍結
    - 推定器Unit Delay ICをaugment時に数値凍結し初期傾きを確実に伝達
    - p.simulation.floorSlopeDeg/AzimuthDegでGroundFrame傾斜床を実装
    - 実測包絡: 初期傾きは≤7de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
2026-10-19 settle制御のエンコーダ真値化と微分減衰で10°ロール保持を~5s→~8.6sに延長
    - elevatedAuthority中のmode1(settle)で推定器のボール/機体速度
    (ドリフト中~7x/~3xバイアス実測)を捨て、エンコーダ輪速逆解の
    運動学レートをチェイス・速度誤差・スリップ基準に共用
    - settleLeanDamping: 速度外ループの微分減衰でドリフト振動を抑制
    - 不効な減速ランプ/スリップ制動/相対位置補正の実験コードを撤去
    - 包絡: 全方向≤7°、10°はピッチ・対角線合格、純ロールのみ~8.6sで
    再転倒(残留ドリフトの単調加速が本質、LQI速度状態再設計が必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
2026-10-19 速度状態LQIゲインで10°初期傾きの保持時間を~8.6s→15-25sに延長
    10状態プラント(dv/dt = g*tilt + forceScale*W'*tau/mEff)のLQRで
    速度列を設計する ballbotVelocityTorqueGains を追加。settle中の
    state(1:2)にボール速度誤差を供給し、直接力チャネルでシミーを
    減衰させる。通常運転では牽引駆動ポンプになるためsettle専用に
    ゲート。加速度フィードフォワードをユーザー指令基準に修正し、
    chase指令の微分によるドリフト方向ポンプを除去。settleLeanGain/
    settleLeanDamping=1.0を追加し、IMU加速度バイアスを相殺する
    制動リーン要求を実現。ドリフ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
2026-10-19 ドリフト残留機構を同定: 車輪-ボール接触トラクションが物理限界
    IMU計測でドリフト中の真の運動を確認: ローバーはほぼ静止を維持
    する一方ボールだけが滑走して逃げる。車輪-ボール接触は0.2-0.45
    m/sで滑り、~0.078 N*m/輪のトラクションが姿勢権限と制動力を
    分け合う。直接ブレーキトルク(c*pinv(W')*v)はc≈4でボールほぼ
    停止・c≈8で完全停止するが反作用で保持が~7s早まり両立しない
    ため撤去。速度ゲインのシミー減衰は半減で保持が悪化することを
    確認し維持。限界をシステム仕様に記録。
    Generated with [Devin](https:/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
2026-10-19 ベイルアウト・ラッチ追加: ボール喪失後の反復フェースプラントを防止
    ボールが到達不能域まで逃げた後、mode 2が機体を繰り返し立て直しては
    再転倒する反復サイクル(実測: ~22sから0.55->0.03 radバウンスが反復)
    を確認。実機では床への反復衝突=破損リスク。recoveryRetryLimit(3)回の
    fallen->recovery再突入を1.5s以上の直立滞留なく超えた場合にmode 0へ
    ラッチする安全機構を追加。直立に成功すれば滞留判定でカウントは
    リセットされるため通常運転・正常リカバリには影響しない。
    ライド追従(relPos追従込み)は誤差駆動のシ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
2026-10-20 mode 0 を終端化し、lean 上限・速度ランプを λ33 幾何で再導出
    - mode 0 (DISABLED/FALLEN) は復帰なしの終端状態に。fallen→recovery
    再突入は床バウンスで反復フェースプラント化する実測があるため削除。
    recoveryRetries/recoveryLatch/uprightDwell/recoveryRetryLimit を撤去し
    単純な mode0Latch に置換（新規ランで解除）。
    - leanSetpointLimit 0.009→0.015 rad: 値は65°時代の K_tilt~6.5 由来で
    陳腐化。現行 K_tilt~4.3 N·m/rad でエッジ要求はクランプの ~83% と
    同等マージンを回復。静的保持コーン ~0.11 rad に対し十分な余裕。
    - accelerationLimit 0.03→0.06、de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
2026-10-20 mode 0 でシミュレーション打ち切り + 牽引上限を λ33 実測荷重へ修正
    - mode 0 突入で set_param(bdroot(gcs),'SimulationCommand','stop') —
    転倒後の dead time を走らせない（非 Simulink 呼出時は gcs 空でスキップ）。
    - tractionLimitedWheelTorque: 静止荷重定数が 65°時代の 4.07 N のまま
    だった。λ33 実測は 8.45 N/輪 → 上限 0.078→0.162 N·m（物理限界
    ~0.41 N·m に対し依然保守的）。これは「接触トラクションが物理上限」
    という残存機構の結論が推定側の飢餓による誤同定だったことを意味する。
    - recoveryWheelTorqueLimit: 2×公称だと 0.32 N·m で 10°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
2026-10-20 静的保持コーンの記述を修正後牽引上限ベースへ更新 (~0.11→~0.23 rad)
    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
2026-10-20 Replace velocity integral with stateless drag feedforward; harden floor/ball contact model
    Sustained translation needs an external force channel: wheel torque is
    internal to the rover+ball assembly (measured integral saturated while
    the ball sat still), and a lean-demand integral winds a stored bias
    that repeatedly produced ~0.9 m/s runaways ending in falls. The
    rolling-resistance coefficient IS the equilibrium lean angle, so a
    stateless feedforward supplies the drag thrust with nothing to wind.
    Physical model: ball-floor mu 2.0 -> 1.2 (real membrane ball ~0.8 plus
    margin), rolling resistance validated across the 0.005-0.015
    flooring-to-carpet band, ball contact stiffness 1e4 -> 3e4 N/m for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
2026-10-21 Error-state EKF with motion-model gating; LSM6DSO/G474RE hardware; maxSpeed 0.40
    Estimator: replace the rest-only gated proportional correction with an
    error-state EKF (3 attitude + 2 roll/pitch gyro-bias states, covariance
    propagation, Joseph-form update, attitude-variance floor). The motion
    model -- a_pred = a_ball + relPos_ddot + z_com*thetaddot from encoder
    kinematics, relPos state, and gyro-rate derivative, all independent of
    the estimated attitude -- gates update admissibility instead of
    entering the residual: every residual-injection variant parasitically
    cancelled true tilt or fed back through the attitude-bootstrapped
    relPos/velocity channels (hold maxTilt degraded to 0.15-0.72).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
2026-10-21 Model omniwheel roller rubber as series compliance; add contact-stiffness acceptance sweep
    Wheel-ball contact stiffness now reflects the goBILDA 50A rubber roller
    layer in series with the ball membrane (~1.4e4 N/m effective, was 3e4);
    floor contact stays membrane-dominated at 3e4. 10-deg roll hold improves
    ~12 s -> 39.2 s at the design point.
    scratch_ksweep sweeps both contacts over {1e4,3e4,6e4} N/m with
    critical-matched damping across hold/cycle/v040/roll10 as the stiffness
    robustness acceptance matrix. Same controller at every point - no
    per-stiffness gains. Results: hold and 0.40 m/s pass at all points;
    50 s cycle passes except a fall onset at t~49.9 at 3e4; roll10 survives
    31.9/13.0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
2026-10-21 Add rev2 multirate model: 1 kHz inner wheel servo + 200 Hz balance loop
    Split the controller for R2024b Embedded Coder multi-tasking on
    STM32G474RE (treat-each-discrete-rate-as-separate-task):
    - Outer ballbotLqiControllerUpdateRev2 (5 ms): estimation, LQI, mode
    logic; emits attitude torque (minus propulsion), kinematic wheel-rate
    target, mode and context flags on a 12-element output.
    - Inner ballbotWheelServoDutyStep (servoSampleTime = 1 ms): propulsion
    wheel-rate servo and torque-to-duty inversion on ZOH-held commands.
    - Wheel-rate measurement stays on the 5 ms window
    (ServoWheelSpeedSensing at estimator.sampleTime): 1 ms backward
    difference flickers +-18.5 rad/s per encoder coun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
2026-10-21 Rework frame packaging for lambda33: L1 donut, 25/50 mm layer stack, electronics placement
    - Frame_L1: replace 3 motor-tail cutouts with single central 98 mm opening
    - Layer stack now L1-L2 = 25 mm, L2-L3 = 50 mm (bodies moved in component space)
    - Frame_L2: fill center hole, add 3 Nucleo mount holes and 3 radial wiring
    slots (10 mm wide, r26-56) above motor connectors
    - Layer spacers realigned to 0-deg hole phase: 6x M3x25 (L1-L2) + 6x M3x50 (L2-L3)
    - Add Nucleo-64 board, UNO protoshield, Adafruit LSM6DSOX centered on vehicle
    origin, and Zeee NiMH battery envelope under the board
    - Two M3x25 board spacers at junction-side mount holes; third mount point is
    an L2 hole only (battery enve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
2026-10-22 Fill Frame_L3 center hole (unneeded) and update mass model/docs
    - Fusion: joined extrusion over the Ø20 center profile of Frame_L3
    (10 -> 9 faces; six Ø3.5 spacer holes and Ø160 profile preserved);
    document saved, STEP/STL re-exported
    - ballbotParameters.m: L3 disc now uses its own mass (60.146 cm3,
    +0.99 g) instead of sharing the L2 disc mass
    - README/cad-plan: split the combined L2/L3 row; L3 marked as
    no-center-hole with updated volume/mass
    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
2026-10-22 Re-export all assembly components to STL
    Per-occurrence export of all 15 unique components in
    ball_balancing_omnirover3wd_assembly. New files: Nucleo64_G474,
    UnoProtoshield, Adafruit_LSM6DSOX, Battery_Zeee_NiMH_7.2V,
    Spacer_M3x25. Ball_100, FIT0521, Ground_ref and omniwheel_14108
    were previously identical duplicate meshes; they now contain the
    correct per-part geometry.
    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
2026-10-22 Flatten MotorMount_v23 face plate for flat-head M2.5 screws
    Remove the 2 mm raised Ø25 boss and Ø6.0 washer pockets on the
    wheel-side face — both plate faces are now coplanar/flat since
    flat-head screws need no head-height relief. Keeps PCD17 Ø2.9
    through-holes and Ø8 nose clearance. Mount: 50.743 cm³, 52 faces.
    Sync ballbotParameters (mount mass/CG/inertia), validation JSON,
    report, README, and lambda33 plan; re-export F3D/STEP/STL.
    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
2026-10-25 Add wiring spec and mount two MDD3A drivers stacked on Frame_L2
    - New electronics/wiring_specification.md: power tree, single-5VO
    rule (no parallel regulator outputs), common GND, channel map,
    mounting and checklist.
    - Frame_L2: four Ø3.5 mounting holes at the actual MDD3A pattern
    (43.18 x 36.58 mm); obsolete generic/below-deck hole sets filled
    and trimmed flat. Volume 56.594 cm3.
    - MDD3A_repr updated to real board envelope 48.26 x 41.66 x 11 mm;
    both boards 2-layer stacked on the right strip via two stages of
    M3x10 spacers (z 188-199 / 209-220). 1220-pair interference = 0.
    - Sync stack-up/hole docs, README and frameDiscMass parameter.
    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
2026-10-27 CAD等の修正 48mmオムニ用ハブの自作stl
2026-10-27 ハブをFIT0521 D軸直挿入仕様に修正
    - 軸穴は奥7mmをDカット(Ø4.1/フラット間隔3.6mm)、口元2mmを真円Ø4.1にし、モータ軸根本の未加工部が挿入できるようにした
    - イモネジ用Ø3.0貫通穴をボス側面(z=6mm、フラット反対側)に追加
    - **/nul をgitignoreへ
    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
2026-10-28 Frame_L1を7.5mm化し尾部支持一体型へ再設計
    - 実機のL1たわみ対策: 板厚3->7.5mm(z=147-154.5)
    - 上面ダブラー案はやめ、旧Ø98中央開口を内側へ充填し
    モーター軸と同一の57°傾斜Ø25.6支持穴×3+基板挿入スロットで
    L1自体がモーター尾部を直接拘束する構成に変更
    - L1-L2スペーサーは20.5mm短縮版Spacer_M3x20p5へ置換
    - 質量モデル・READMEを更新(bodyMass 0.985kg)
    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
